CollinHeist/CropTop/docs/prototype/Raspberry Pi Code/stalk-pusher-master/README.md

```

Copyright (c) 2016-2017 [NYUAD Biomechanics Laboratory] - All Rights Reserved

No part of StalkPusher Project, including this file, may be copied, modified, 
propagated, or distributed unless given explicit permission.

Please contact Professor Cook at douglascook(at)nyu.edu for permission and 
further information.

```
# StalkPusher

A device that aids crop plant breeders to more accurately predict plant strength

## Introduction

IMAGE ALT TEXT (https://www.youtube.com/watch?v=vgz_xZ3Y4XQ "Corn Stalk Engineering")

Yield losses in maize (Zea mays L.) due to stalk lodging has significant negative economic impact. The lodging resistance in maize could be advanced more rapidly with the development of selective breeding tools that accurately predict stalk strength. Motivated by the strong correlation between flexural stiffness and stalk strength as demonstrated by Robertson et al, the StalkPusher device aims to predict crop stalk strength by measuring the plant's flexural rigidity.

## Installation/Setup

For installation and setup, please refer to [placeholder]

## Electronics Hardware

https://circuitmaker.com/Projects/Details/Ting-Che-Lin/stalkTesterForkWithDCDCConverter

## Graphical User Interface

## Physical Hardware

## Results

## Bibliography
Robertson, Daniel J., et al. "Maize Stalk Lodging: Flexural Stiffness Predicts Strength." Crop Science 56.4 (2016): 1711-1718.
