CollinHeist/CropTop/docs/prez/schematic poster.pptx

## cereal grain Data Acquisition device Designed by Ryan Donahue & Kennedy Caisley

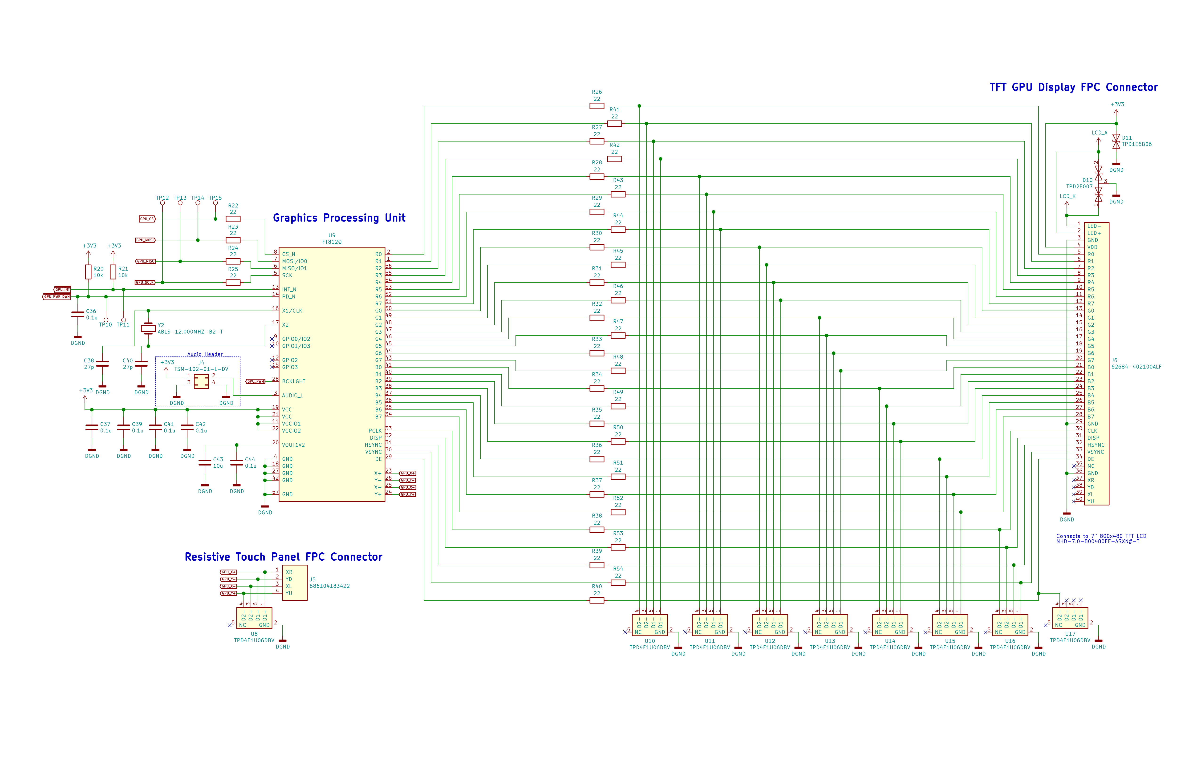
[picture p9: figure]
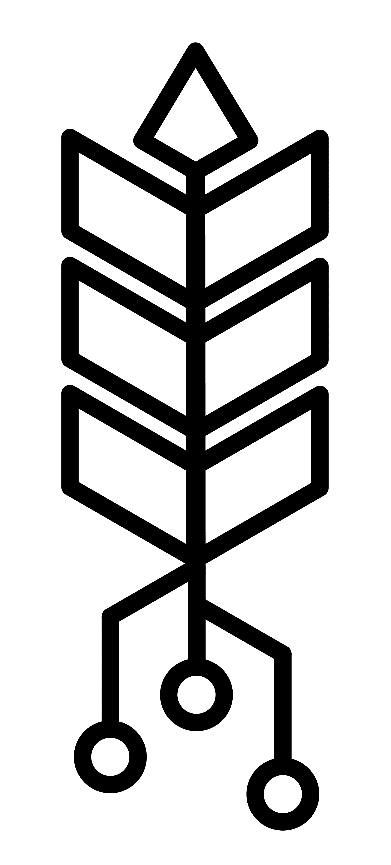
[picture p10: figure]
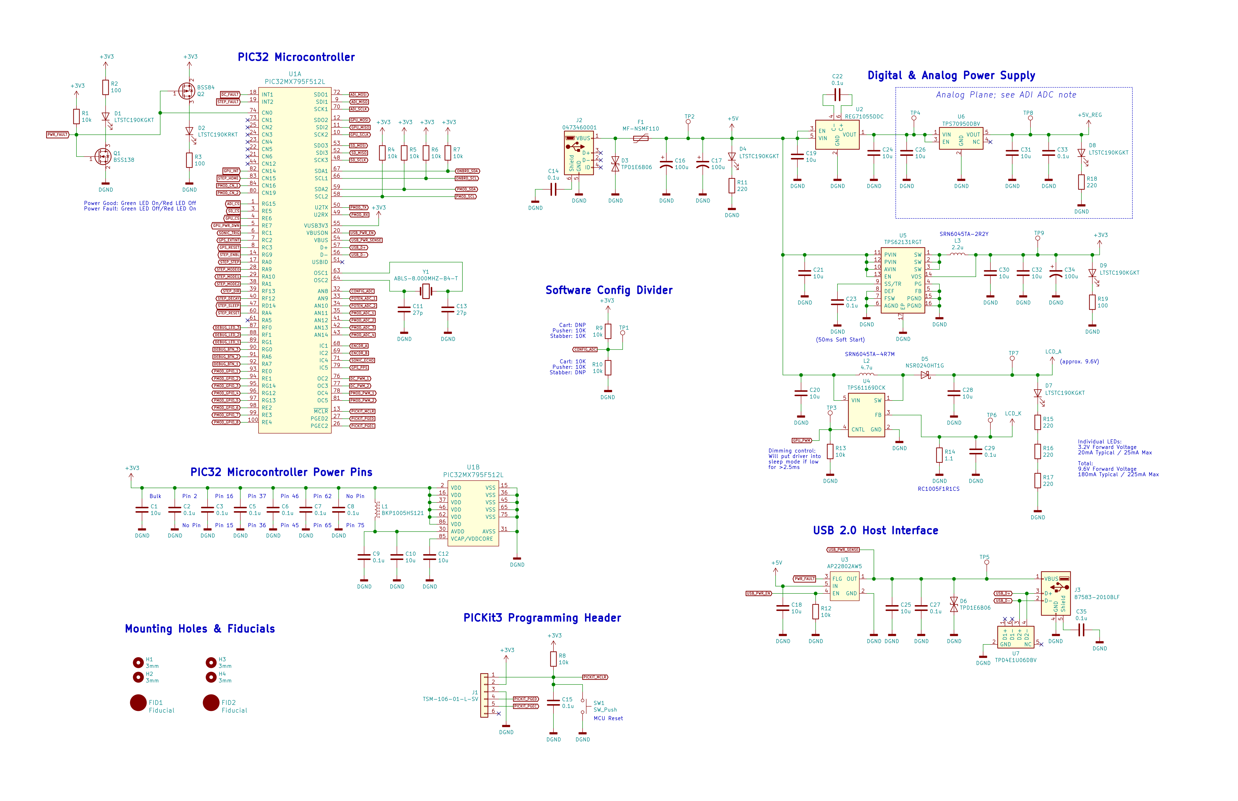
[picture p11: figure]
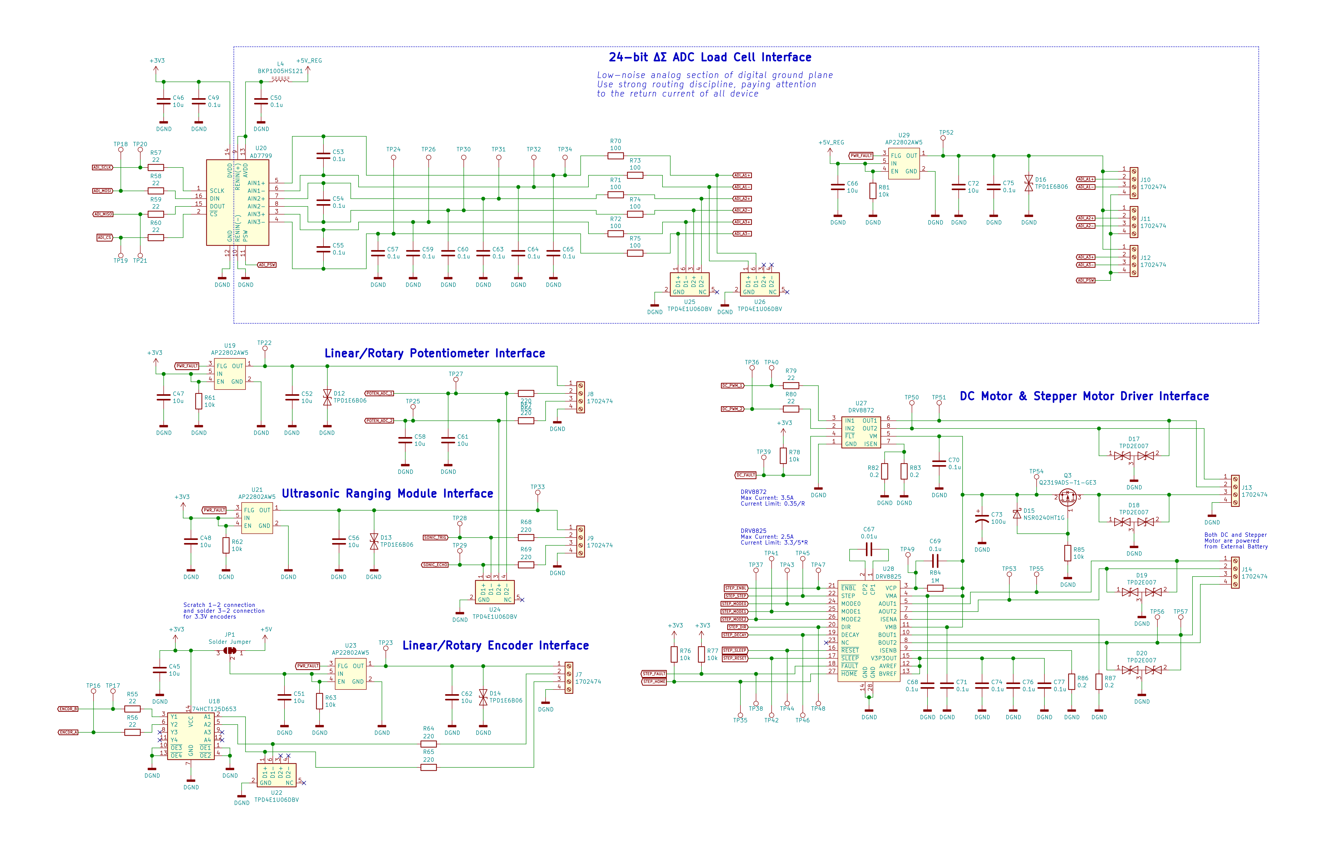
[picture p12: figure]
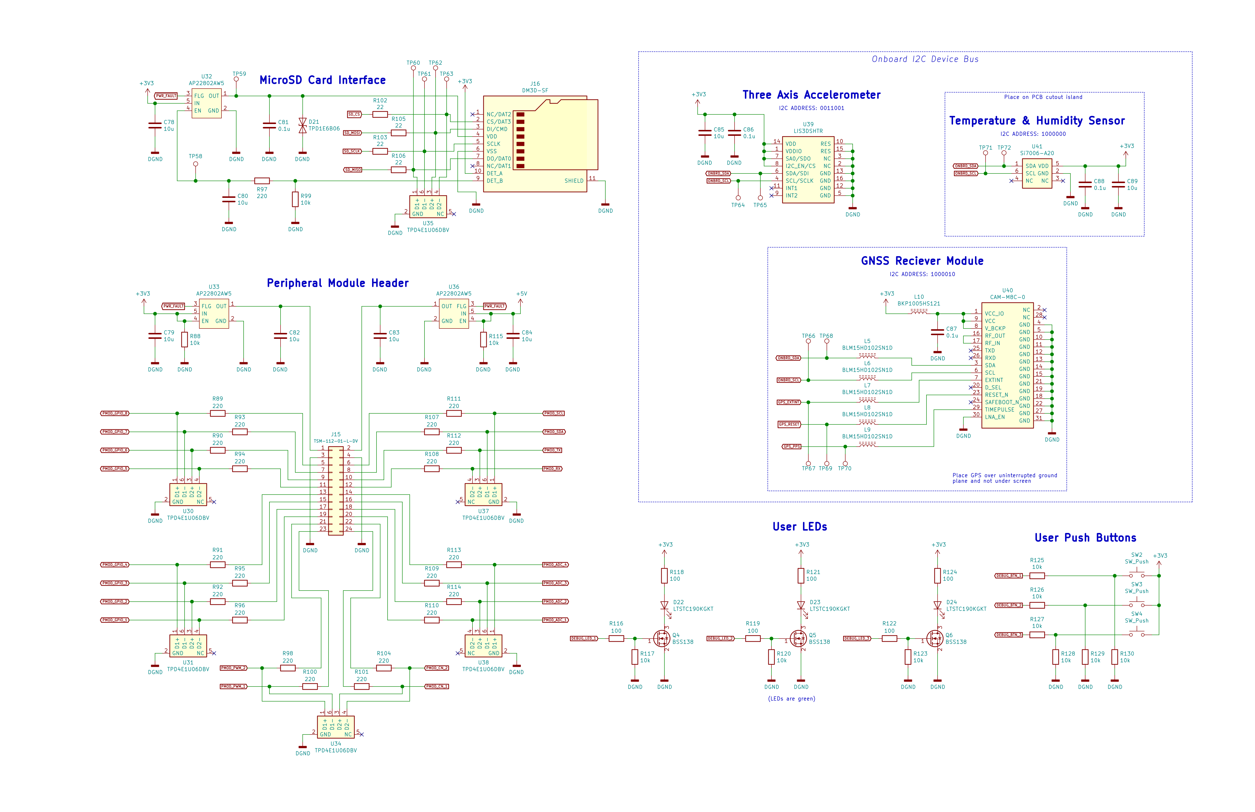
[picture p13: figure]
