CollinHeist/CropTop/pinout.xlsx

Sheet: Pin Function Selection
AERXERR/RG15 | GPIO |  |  |  |  | RG15 | GPIO
VDD | POWER
PMD5/RE5 | GPIO
PMD6/RE6 | GPIO
PMD7/RE7 | GPIO
T2CK/RC1 | GPIO
T3CK/AC2TX/RC2 | GPIO
T4CK/AC2RX/RC3 | GPIO
T5CK/SDI1/RC4 |  | SPI1
ECOL/SCK2/U6TX/U3RTS/PMA5/CN8/RG6 | I2C | SPI2 | UART | CN
ECRS/SDA4/SDI2/U3RX/PMA4/CN9/RG7 | I2C | SPI2 | UART | CN
ERXDV/AERXDV/ECRSDV/AECRSDV/SCL4/SDO2/U3TX/PMA3/CN10/RG8 |  | SPI2 |  | CN
MCLR | PROGRAM
ERXCLK/AERXCLK/EREFCLK/AEREFCLK/SS2/U6RX/U3CTS/PMA2/CN11/RG9 |  | SPI2 |  | CN
VSS | POWER
VDD | POWER
TMS/RA0 | GPIO
AERXD0/INT1/RE8 |  |  |  |  | INT
AERXD1/INT2/RE9 |  |  |  |  | INT
AN5/C1IN+/VBUSON/CN7/RB5 | USB | ADC |  | CN
AN4/C1IN-/CN6/RB4 |  | ADC |  | CN
AN3/C2IN+/CN5/RB3 |  | ADC |  | CN
AN2/C2IN-/CN4/RB2 |  | ADC |  | CN
PGEC1/AN1/CN3/RB1 | PROGRAM | ADC |  | CN
PGED1/AN0/CN2/RB0 | PROGRAM | ADC |  | CN
PGEC2/AN6/OCFA/RB6 | PROGRAM | ADC |  |  | OC FAULT
PGED2/AN7/RB7 | PROGRAM | ADC
VREF-/CVREF-/AERXD2/PMA7/RA9 | GPIO
VREF+/CVREF+/AERXD3/PMA6/RA10 | GPIO
AVDD | POWER
AVSS | POWER
AN8/C1OUT/RB8 |  | ADC
AN9/C2OUT/RB9 |  | ADC
AN10/CVREFOUT/PMA13/RB10 |  | ADC
AN11/ERXERR/AETXERR/PMA12/RB11 |  | ADC
VSS | POWER
VDD | POWER
TCK/RA1 | GPIO
AC1TX/SCK4/U5TX/U2RTS/RF13 |  | SPI4 | UART
AC1RX/SS4/U5RX/U2CTS/RF12 |  | SPI4 | UART
AN12/ERXD0/AECRS/PMA11/RB12 |  | ADC
AN13/ERXD1/AECOL/PMA10/RB13 |  | ADC
AN14/ERXD2/AETXD3/PMALH/PMA1/RB14 |  | ADC
AN15/ERXD3/AETXD2/OCFB/PMALL/PMA0/CN12/RB15 |  | ADC |  | CN | OC FAULT
VSS | POWER
VDD | POWER
AETXD0/SS3/U4RX/U1CTS/CN20/RD14 |  | SPI3 | UART | CN
AETXD1/SCK3/U4TX/U1RTS/CN21/RD15 |  | SPI3 | UART | CN
SDA5/SDI4/U2RX/PMA9/CN17/RF4 | I2C | SPI4 | UART | CN
SCL5/SDO4/U2TX/PMA8/CN18/RF5 | I2C | SPI4 | UART | CN
USBID/RF3 | USB
SDA3/SDI3/U1RX/RF2 | I2C | SPI3 | UART
SCL3/SDO3/U1TX/RF8 | I2C | SPI3 | UART | e
VBUS | USB
VUSB3V3 | USB
D-/RG3 | USB
D+/RG2 | USB
SCL2/RA2 | I2C
SDA2/RA3 | I2C
TDI/RA4 | GPIO
TDO/RA5 | GPIO
VDD | POWER
OSC1/CLKI/RC12 | OSCILLATOR
OSC2/CLKO/RC15 | OSCILLATOR
VSS | POWER
AETXCLK/SCL1/INT3/RA14 | I2C |  |  |  | INT
AETXEN/SDA1/INT4/RA15 | I2C |  |  |  | INT
RTCC/EMDIO/AEMDIO/IC1/RD8 | GPIO |  |  | IC
SS1/IC2/RD9 |  | SPI1 |  | IC
SCK1/IC3/PMCS2/PMA15/RD10 |  | SPI1 |  | IC
EMDC/AEMDC/IC4/PMCS1/PMA14/RD11 |  |  |  | IC
SDO1/OC1/INT0/RD0 |  | SPI1 |  |  | OC | INT
SOSCI/CN1/RC13 |  |  | CN
SOSCO/T1CK/CN0/RC14 |  |  | CN
VSS | POWER
OC2/RD1 |  |  |  |  | OC
OC3/RD2 |  |  |  |  | OC
OC4/RD3 |  |  |  |  | OC
ETXD2/IC5/PMD12/RD12 |  |  |  | IC
ETXD3/PMD13/CN19/RD13 |  |  | CN
OC5/PMWR/CN13/RD4 |  |  | CN |  | OC
PMRD/CN14/RD5 |  |  | CN
ETXEN/PMD14/CN15/RD6 |  |  | CN
ETXCLK/PMD15/CN16/RD7 |  |  | CN
VCAP/VDDCORE | POWER
VDD | POWER
C1RX/ETXD1/PMD11/RF0 | GPIO
C1TX/ETXD0/PMD10/RF1 | GPIO
C2TX/ETXERR/PMD9/RG1 | GPIO
C2RX/PMD8/RG0 | GPIO
TRCLK/RA6 | GPIO
TRD3/RA7 | GPIO
PMD0/RE0 | GPIO
PMD1/RE1 | GPIO
TRD2/RG14 | GPIO
TRD1/RG12 | GPIO
TRD0/RG13 | GPIO
PMD2/RE2 | GPIO
PMD3/RE3 | GPIO
PMD4/RE4 | GPIO

Sheet: Totals
GPIO | 28
SPI | 3
UART | 2
INT | 2 | PKT_PGED |  | DC_PWM_1 |  | ADI_MOSI | GPU_MOSI | SDCARD_MOSI |  | ONBRD_SCL
CN | 12 | PKT_PGEC |  | DC_PWM_2 |  | ADI_MISO | GPU_MISO | SDCARD_MISO |  | ONBRD_SDA
ADC | 8 | PKT_MCLR |  |  |  | ADI_SCLK | GPU_SCLK | SDCARD_SCLK
USB | 1
I2C | 2
IC | 3
OC | 4
 |  | INT | 2 | CN | 12 | GPIO | 28 | ADC | 8 | IC | 3
 |  | ~STEPPER_FAULT |  | ~USB_PWR_GOOD |  | LED_1 |  | CONFIG_ADC |  | ENCDR_A |  | PMOD_TX
 |  | ~DC_FAULT |  | ~ADI_PWR_GOOD |  | LED_2 |  | POTEN_ADC_1 |  | ENCDR_B |  | PMOD_RX
 |  |  |  | ~SDCARD_PWR_GOOD |  | LED_3 |  | POTEN_ADC_2 |  | SONIC_ECHO
 |  |  |  | ~POTEN_PWR_GOOD |  | BTN_1 |  |  |  | GPS_PPS
 |  |  |  | ~SONIC_PWR_GOOD |  | BTN_2 |  | PMOD_ADC_1
 |  |  |  | ~ENCDR_PWR_GOOD |  | BTN_3 |  | PMOD_ADC_2
 |  |  |  | ~PMOD_3V3_PWR_GOOD |  |  |  | PMOD_ADC_3
 |  |  |  | ~PMOD_5V0_PWR_GOOD |  |  |  | PMOD_ADC_4
 |  |  |  |  |  | ~GPU_PD
 |  |  |  | ~STEPPER_HOME |  | ~GPU_INT
 |  |  |  | ACCEL_INT_1
 |  |  |  | ACCEL_INT_2 |  | SONIC_TRIG
 |  |  |  |  |  | ~GPU_CS
 |  |  |  |  |  | ~SDCARD_CS
 |  |  |  |  |  | ~ADI_CS
 |  |  |  |  |  | ~STEPPER_ENBL
 |  |  |  |  |  | STEPPER_STEP
 |  |  |  |  |  | STEPPER_MODE_0
 |  |  |  |  |  | STEPPER_MODE_1
 |  |  |  |  |  | STEPPER_MODE_2
 |  |  |  |  |  | STEPPER_DIR
 |  |  |  |  |  | STEPPER_DECAY
 |  |  |  |  |  | ~STEPPER_SLEEP
 |  |  |  |  |  | ~STEPPER_RESET
 |  |  |  |  |  | GPS_RST
 |  |  |  |  |  | GPS_EXTINT

Sheet: Tasks to Accomplish
Add Piezo Buzzer | Testpoints
Finish FT812Q Connection | Netnames
Work on PIC32 Pinout | Labels
Finish Stepper Motor Chip | Calculations
 | Check testpoint are on labeled nets
