CollinHeist/CropTop/docs/images/idaho.jpg

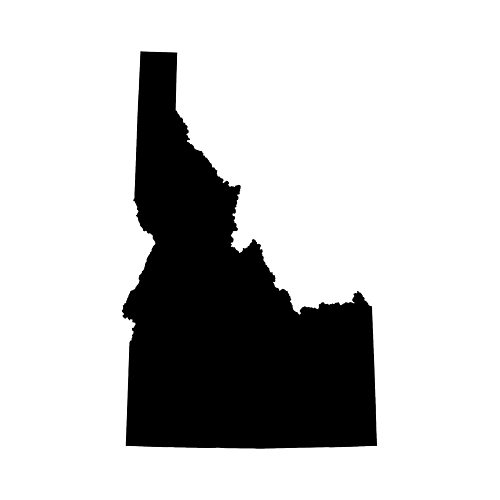
docs/images/idaho.jpg
