CollinHeist/CropTop/docs/prototype/Raspberry Pi Code/stalk-pusher-master/hardware/docs/buildOfMaterials/BOM_PartType-stalkTesterForkWithDCDCConverter.xls

CiivaID | Comment | Description | Designator | Footprint | LibRef | Quantity
 | 1k Ohms | Res Carbon Film 1K Ohm 5% 1/4W -400ppm/°C to 0ppm/°C Conformal AXL Thru-Hole T/R | R5 | PCB-bfjjg625tt0lscyu35rt-1 | CMP-db3e1311f37e04f9-1 | 1.0
 | 150 Ohm | Through Hole Thin Film Resistor, LR Series, 150 ohm, 600 mW, - 1%, 350 V, Axial Leaded | R7 | PCB-vx15ok3iiu352umrckug-1 | CMP-aa5a626003c1759d-1 | 1.0
 | 150 Ohms | Through Hole Thin Film Resistor, LR Series, 150 ohm, 600 mW, - 1%, 350 V, Axial Leaded | R1, R3 | PCB-vx15ok3iiu352umrckug-1 | CMP-aa5a626003c1759d-1 | 2.0
 | 220uF | Aluminium Electrolytic Capacitor, WCAP-ATG8 Series, 220 F, 20%, 25 V, 6.3 mm, Radial Leaded | C1 | PCB-kyskzfzvu5hkft7entwf-1 | CMP-eaa62094da6d3561-1 | 1.0
2034380 | 240 Ohm | RES 0.0 OHM 1/4W JUMP AXIAL | R6 | PCB-2034380-1 | CMP-2034380-1 | 1.0
 | 270 Ohm | Res Metal Film 270 Ohm 1% 0.6W ?50ppm/C Conformal Coated AXL Ammo Pack | R8, R9 | PCB-3e396qau55ic585a88p4-1 | CMP-fd3b34c9d94622fc-2 | 2.0
 | 470 Ohm | Through Hole Metal Film Resistor, SFR16S Series, 470 kohm, 500 mW, - 5%, 200 V, Axial Leaded | R4 | PCB-ignmdqeaj071785ev1qy-1 | CMP-135bdb585537cc9c-1 | 1.0
 | 620 Ohm | RESISTOR, 0.25W 1% 620R; Series: MF25; Resistance: 620R; Tolerance, resistance: +/-1%; Power rating: 0.25W; Temperatu... | R2 | PCB-2034602-1 | CMP-08b0c1ebf079d777-1 | 1.0
 | 282834-2 | Conn; Term Blk; PCB; Wire Receptacle; 3; 2.54mm; 30-16AWG; Green; 10A; 150V; M1.6 | Pot | PCB-3ptdhsghoqvd1l0ur6gj-1 | CMP-2bf4e0a55a8ff433-1 | 1.0
 | 282834-2 | Conn; Term Blk; PCB; Wire Receptacle; 4; 2.54mm; 30-16AWG; Green; 10A; 150V; M1.6 | AM2315 | PCB-pck2b3tw6vugzxi4asp2-1 | CMP-e39628c790073c51-1 | 1.0
 | Adafruit Industries 746 | Adafruit Ultimate GPS Breakout | GPS | PCB-bz3yr8570f4b4qxddo1b-1 | CMP-5d1695eb4fdc82d1-6 | 1.0
 | Adafruit Industries 1085 | ADS-1115 Programmable Gain Amplifier | ADC1, ADC2 | PCB-4lejntxigf7lhwnms15s-1 | CMP-311cf9d8a243eedb-16 | 2.0
 | Adafruit Industries 2021 | Adafruit 9-DOF Accel/Mag/Gyro+Temp Breakout Board | LSM9DS0 | PCB-maed6y3qleiqj331msl7-1 | CMP-d3cc19ecca900c0b-5 | 1.0
 | Arduino PRO shield | Arduino Pro Mini Atmega328 (3.3V /5V) | Arduino Pro Mini 5V | PCB-xjupnshw5z1zqg394mrs-1 | CMP-14badecfe295cb7d-20 | 1.0
 | CMP-4964073-3 | Standard Recovery Rectifier, 2-Pin Axial_Lead, Pb-Free, Tape and Reel | D1, D2 | ONSC-AXIAL_LEAD-2-59-10_P | CMP-4964073-3 | 2.0
 | CUI PDS1-S5-S12-S | PDS1 Series 1 W 12 VDC 83 mA Single Output DC-DC Isolated Converter | DCDC Conv | PCB-vjduovkroff0l3ptlkf4-1 | CMP-2838e08a97fff7ff-2 | 1.0
 | INA114AP | Precision Instrumentation Amplifier, -40 to 85 degC, 8-pin DIP (P8), Green (RoHS & no Sb/Br) | (1)INA114, (2)INA114 | TI-P8 | CMP-13608889-2 | 2.0
 | Inductor | High Frequency Split Core Ferrite Suppressors for Round Cable 835ohms 100MHz 5A Thru-hole | L2 | PCB-mg0q4fr7srabzfbwe7jf-1 | CMP-92d25afd71424d15-2 | 1.0
 | LM317T | 1.5A, 1.2V to 37V Adjustable Voltage Regulator, 3-Pin TO-220 | LReg 5V, LReg 7V | TO-220 | CMP-1170851-2 | 2.0
 | Raspberry Pi RASPBERRYPI3-MODB-1GB. | Raspberry Pi 3 Model B, 64bit, 1GB RAM, Wi-Fi 802.11n BT 4.1 | Raspberry Pi 3 | PiHAT template | Raspberry Pi RASPBERRYPI3-MODB-1GB.-4 | 1.0
 | SparkFun BOB-12009 | Logic Level Converter - Bi-Direc | Lvl Shifter | PCB-snpsjs3ljinaye23s7fj-1 | CMP-a9a86355bbb8766f-7 | 1.0
 | TDK FG28X5R1E475KRT06 | CAP CER 4.7UF 25V X5R RADIAL | C2, C3 | PCB-t6r2jniesmrfxoqfoh3w-1 | CMP-c1ff0cfb06121e38-1 | 2.0
 | TE Connectivity 282834-5 | Buchanan; Conn; Term Blk; PCB; 5; 2.54mm; Front; 30-16 AWG; Green; 10 A; 150 V | LCell X/Single, LCell Y | PCB-pck2b3tw6vugzxi4asp2-1 | CMP-216fea3e502afea8-2 | 2.0
 | TE Connectivity / AMP 282834-8 | Buchanan; Conn; Term Blk; PCB; 8; 2.54mm; Front; 30-16 AWG; Green; 10 A; 150 V | D Pad, LBut | PCB-31ifldq471oc3mn4sxz4-1 | CMP-2b39e0501fb7f4fe-6 | 2.0
 | UA741CP | General-Purpose Operational Amplifier, 7 to 36 V, 0 to 70 degC, 8-pin DIP (P8), Pb-Free (RoHS) | UA741 | TI-P8 | CMP-1320630-2 | 1.0
 | Vishay BCcomponents K104Z15Y5VF5TL2 | Capacitor; Ceramic; Cap 0.1 uF; Tol -20, +80%; Vol-Rtg 50 VDC; Radial; Y5V; Tape & Reel | C4, C5, C6, C7, C8, C9, C10, C11 | PCB-l4zci1ynknckpo24ombh-1 | CMP-7d20b42952c2a2e7-2 | 8.0
