CollinHeist/CropTop/PCB v3.0/step/ABS07.STEP

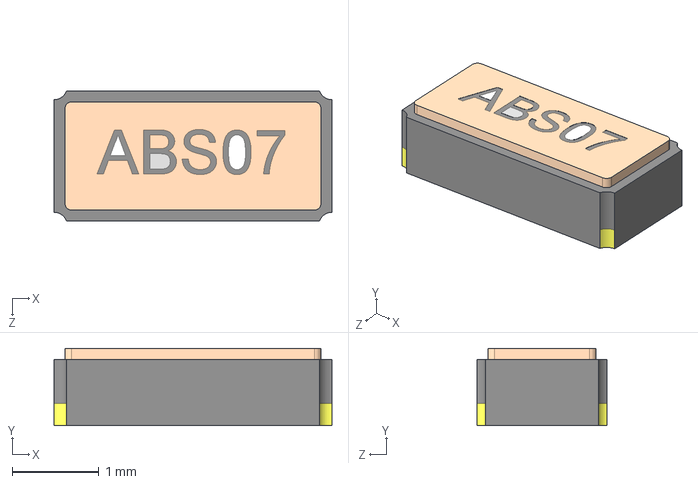
[picture p15: CAD file, 2019-05-08]
PCB v3.0/step/ABS07.STEP
3.20 x 0.889 x 1.50 mm
