CollinHeist/CropTop/PCB v3.0/step/USB_Micro-B_Molex_47346-0001.step

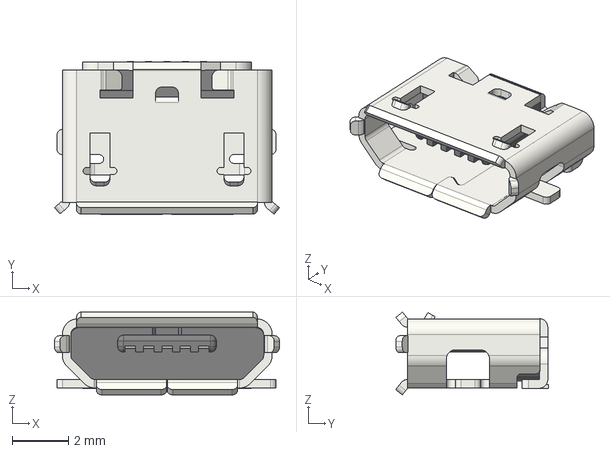
[picture p16: CAD file, 2019-04-25]
PCB v3.0/step/USB_Micro-B_Molex_47346-0001.step
7.98 x 5.42 x 2.94 mm
