CollinHeist/CropTop/PCB v3.0/step/usb a.step

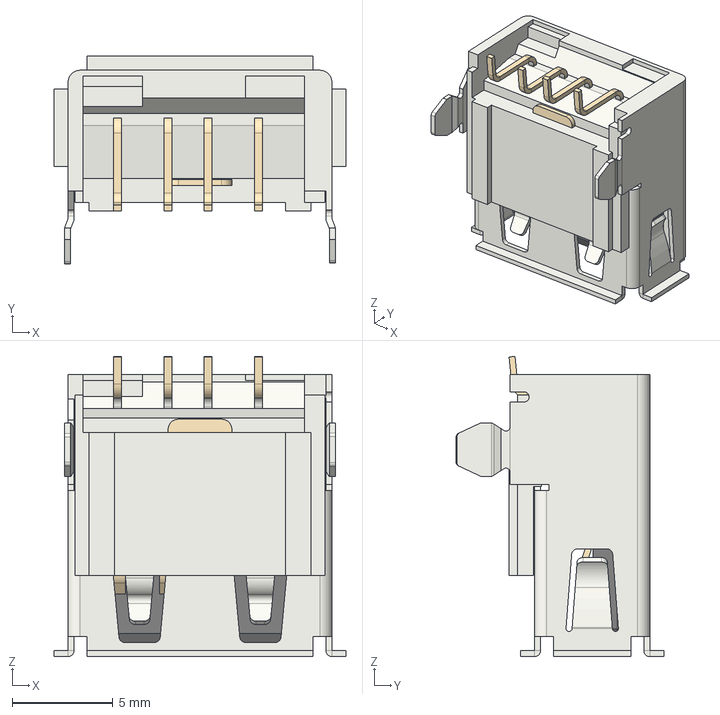
[picture p17: CAD file, 2019-04-25]
PCB v3.0/step/usb a.step
14.5 x 10.3 x 14.9 mm
