CollinHeist/CropTop/PCB v3.0/step/LGA-16.stp

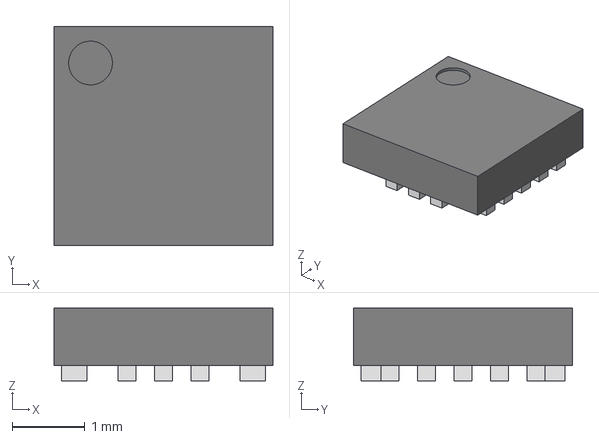
[picture p18: CAD file, 2019-04-22]
PCB v3.0/step/LGA-16.stp
3.00 x 3.00 x 1.00 mm
