CollinHeist/CropTop/PCB v3.0/step/soic-14.stp

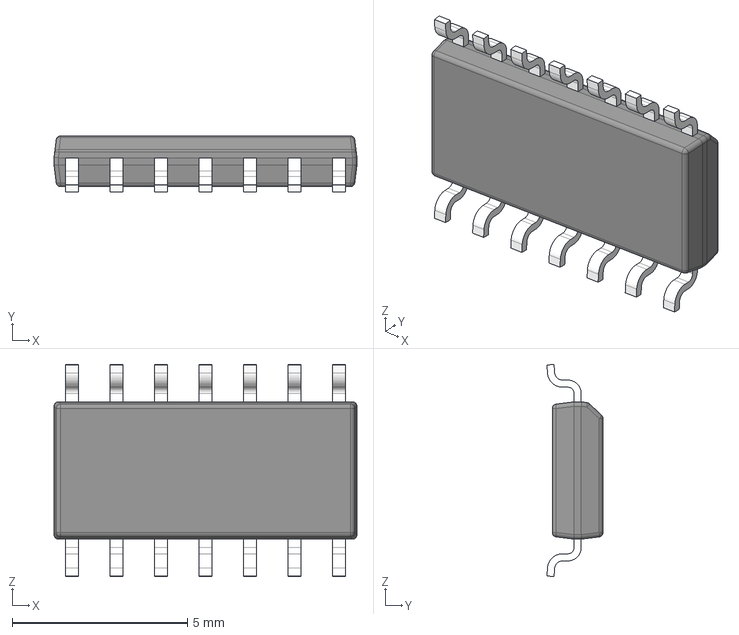
[picture p19: CAD file, 2019-04-22]
PCB v3.0/step/soic-14.stp
8.64 x 1.60 x 6.05 mm
BODY_M14A_20
LEAD_M14A_46 x 14
