CollinHeist/CropTop/PCB v3.0/step/DM3CS-SF.stp

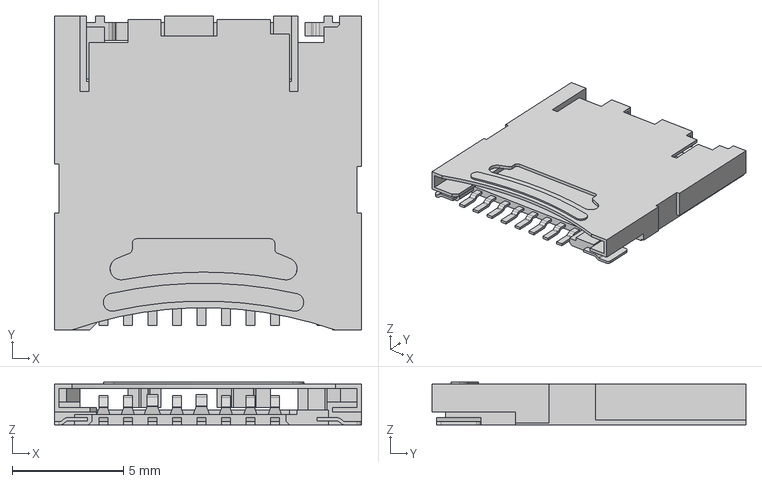
[picture p20: CAD file, 2019-04-22]
PCB v3.0/step/DM3CS-SF.stp
13.8 x 14.1 x 1.93 mm
