CollinHeist/CropTop/PCB v3.0/step/mf-nsmf110.stp

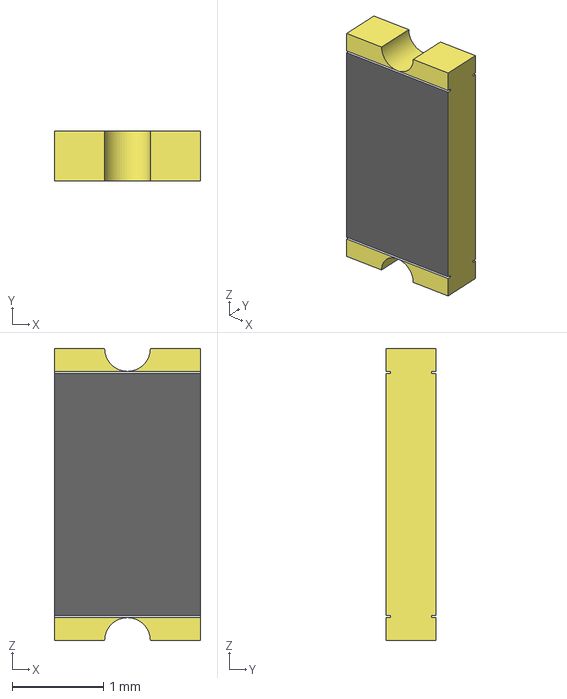
[picture p21: CAD file, 2019-04-22]
PCB v3.0/step/mf-nsmf110.stp
1.60 x 0.55 x 3.20 mm
