CollinHeist/CropTop/PCB v3.0/step/4fpc.FCStd

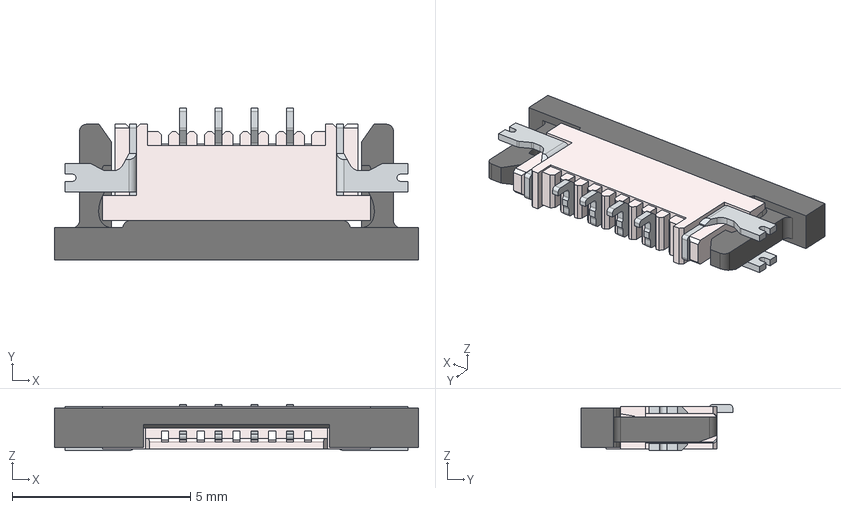
[picture p22: CAD file, 2019-04-22]
PCB v3.0/step/4fpc.FCStd
10.2 x 4.25 x 1.29 mm
68x109183x22
68x109183x22_Actuator
68X1xx183x22_Solder_Pad2
68X1XX183X22_Solder_Pad
68X1XX183X22_Pin_TOP
68X1XX183X22_Pin_TOP001
68X1XX183X22_Pin_TOP002
68X1XX183X22_Pin_TOP003
