CollinHeist/CropTop/PCB v3.0/step/40fpc.FCStd

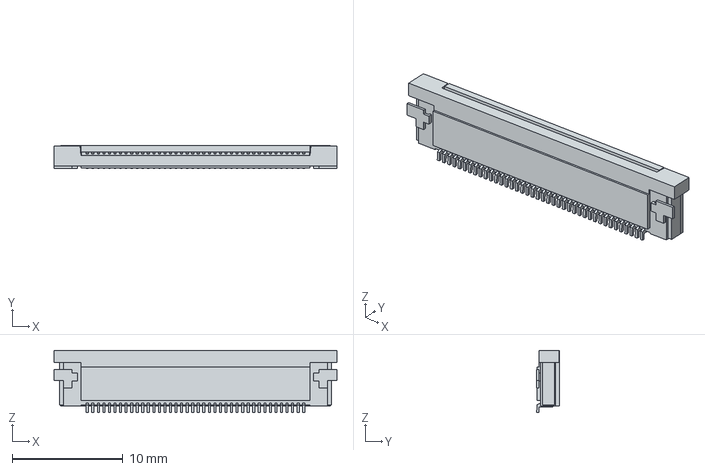
[picture p23: CAD file, 2019-04-22]
PCB v3.0/step/40fpc.FCStd
25.5 x 2.05 x 5.60 mm
