CollinHeist/CropTop/PCB v3.0/step/DM3AT-SF-PEJM5.stp

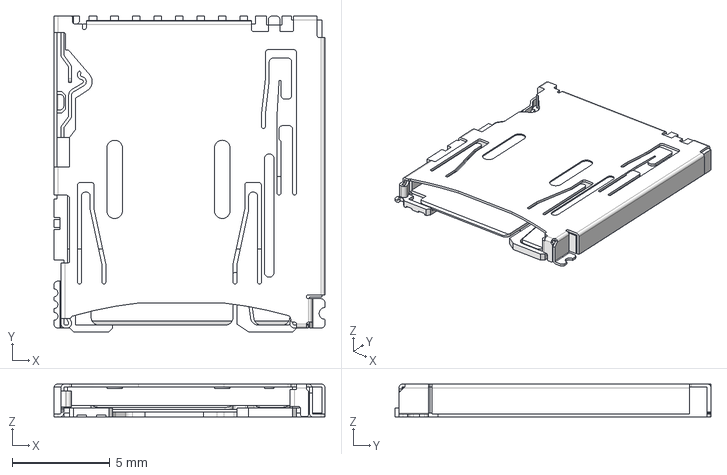
[picture p24: CAD file, 2019-04-22]
PCB v3.0/step/DM3AT-SF-PEJM5.stp
13.8 x 16.2 x 1.68 mm
