CollinHeist/CropTop/PCB v3.0/step/CAM-M8.STEP

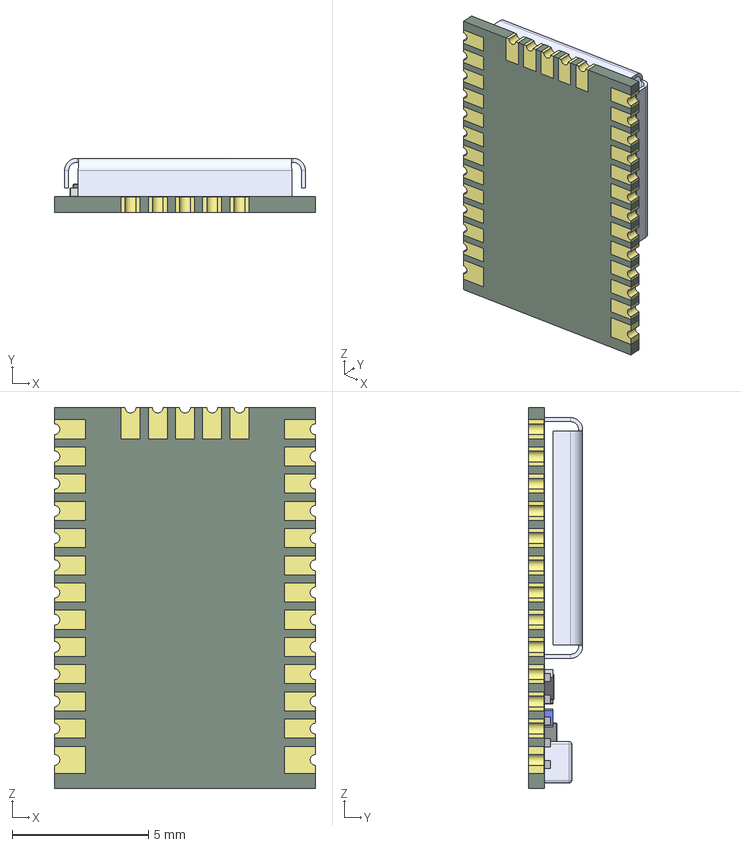
[picture p25: CAD file, 2019-04-22]
PCB v3.0/step/CAM-M8.STEP
9.60 x 2.00 x 14.0 mm
CAM-M8_PCB
CAM-M8_Pad_big001 x 2
CAM-M8_Pad_small028 x 29
CAM-M8_Shield
Capsule004 x 5
Encapsulation009 x 10
Cap0201_top004 x 5
Encapsulation_008 x 8
CAP_PART002 x 3
IC01
IC02
ChipAntenna
IND_PART
