CollinHeist/CropTop/PCB v3.0/step/TSM-102-01-T-DV.stp

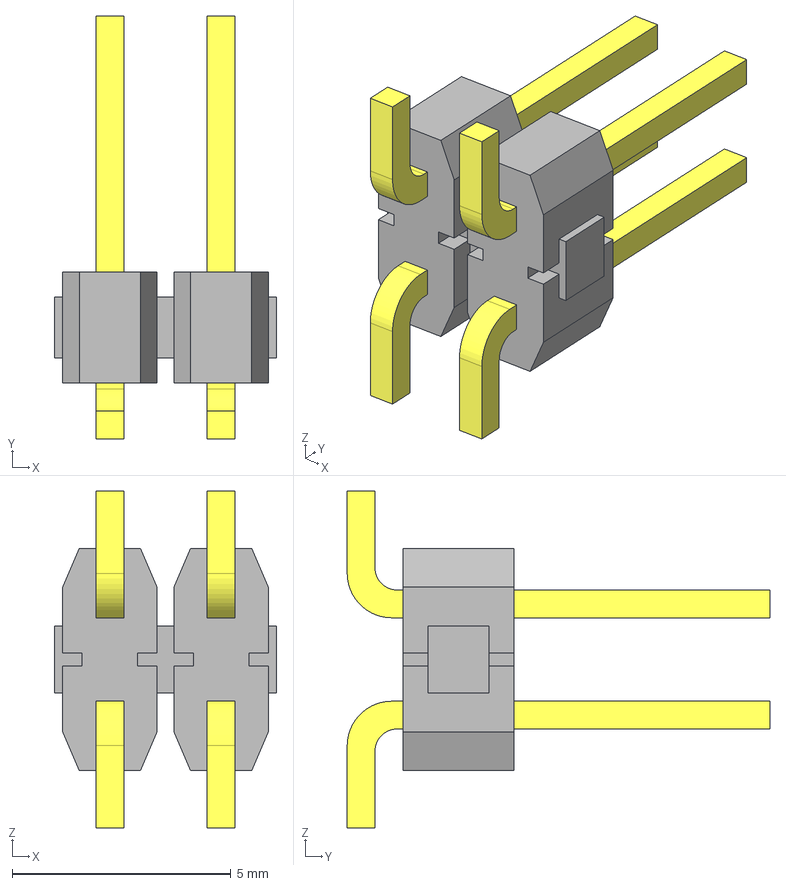
[picture p26: CAD file, 2019-04-22]
PCB v3.0/step/TSM-102-01-T-DV.stp
5.08 x 9.65 x 7.70 mm
_TSM-102-01-DV_body
_T-1S6-16(-01-2-DV)
