CollinHeist/CropTop/PCB v3.0/step/srn8040.stp

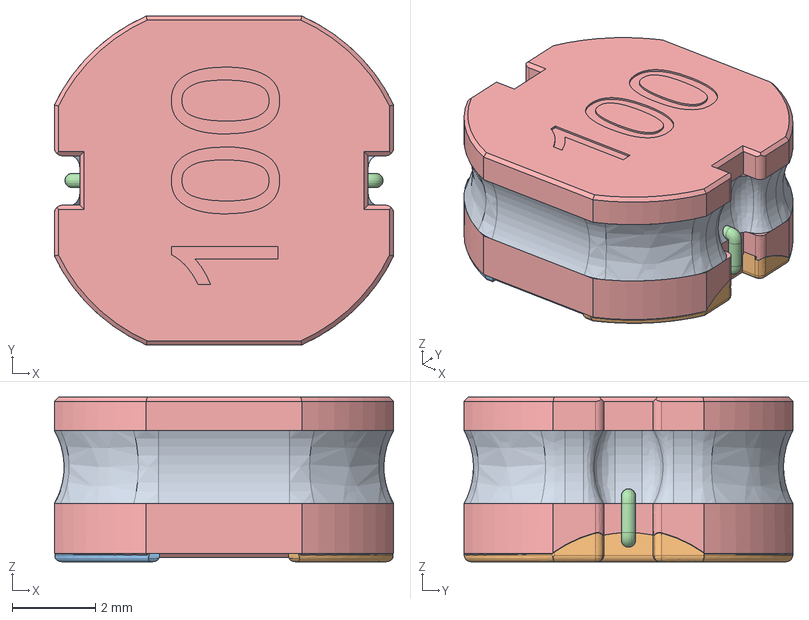
[picture p27: CAD file, 2019-04-22]
PCB v3.0/step/srn8040.stp
8.15 x 7.90 x 3.95 mm
