CollinHeist/CropTop/PCB v3.0/step/TSM-106-01-T-SV.stp

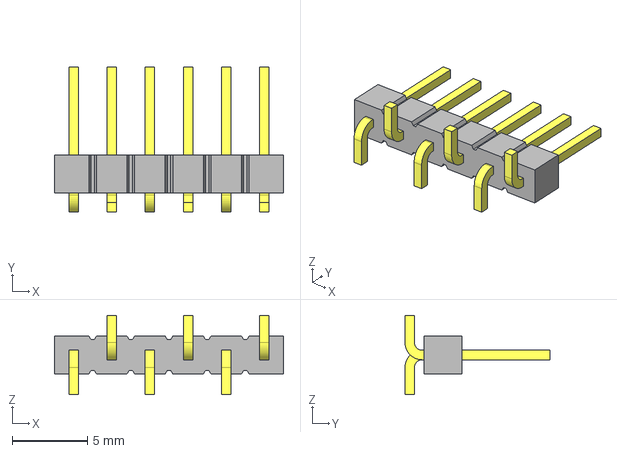
[picture p28: CAD file, 2019-04-22]
PCB v3.0/step/TSM-106-01-T-SV.stp
15.2 x 9.65 x 5.28 mm
_TSM-106-01-SV_body
_T-1S6-16(-01-6-SV)
