CollinHeist/CropTop/PCB v3.0/step/usb no.stp

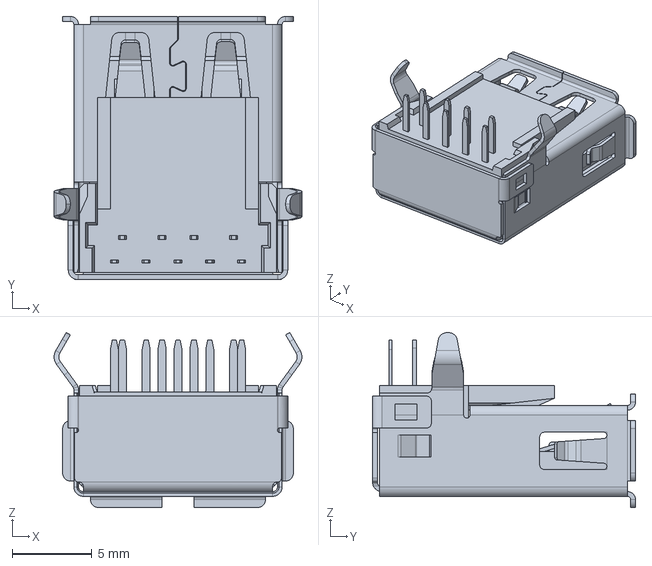
[picture p29: CAD file, 2019-03-17]
PCB v3.0/step/usb no.stp
15.6 x 16.5 x 11.0 mm
