CollinHeist/CropTop/PCB v3.0/step/c-4-1734839-0-c-3d.stp

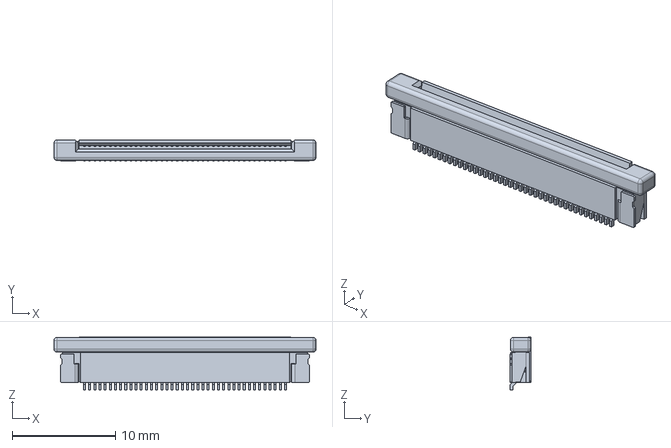
[picture p30: CAD file, 2019-03-17]
PCB v3.0/step/c-4-1734839-0-c-3d.stp
25.4 x 2.05 x 5.11 mm
