CollinHeist/CropTop/PCB v3.0/step/usb2.stp

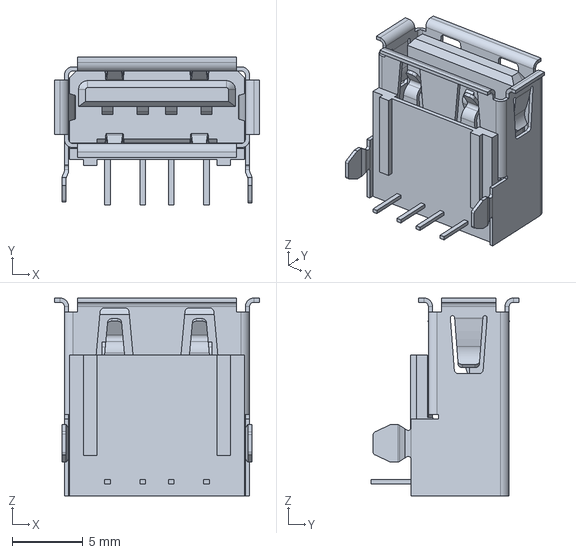
[picture p31: CAD file, 2019-03-17]
PCB v3.0/step/usb2.stp
14.5 x 10.5 x 14.0 mm
