CollinHeist/CropTop/PCB v3.0/step/Download_STP_614004190021 (rev1).stp

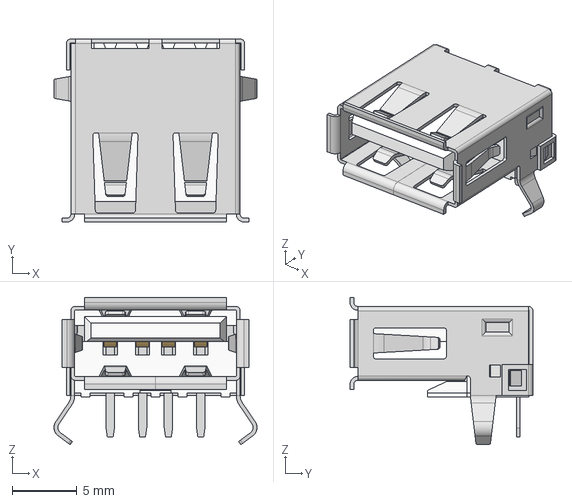
[picture p32: CAD file, 2019-03-17]
PCB v3.0/step/Download_STP_614004190021 (rev1).stp
15.7 x 14.1 x 11.4 mm
614004190021_Shielding
