CollinHeist/CropTop/PCB v3.0/step/ABLS.STEP

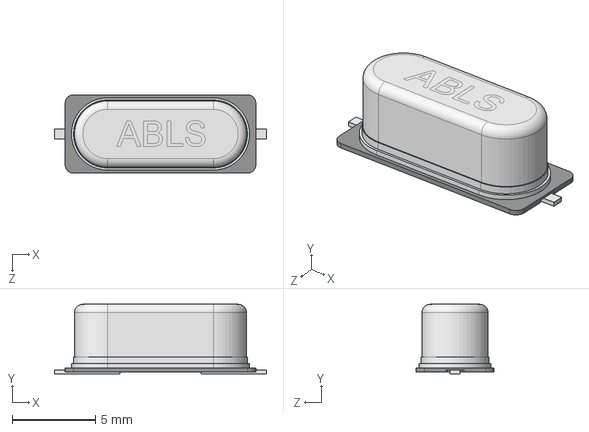
[picture p33: CAD file, 2019-03-17]
PCB v3.0/step/ABLS.STEP
12.7 x 4.17 x 4.70 mm
