CollinHeist/CropTop/PCB v3.0/step/Download_STP_61300611121 (rev1).stp

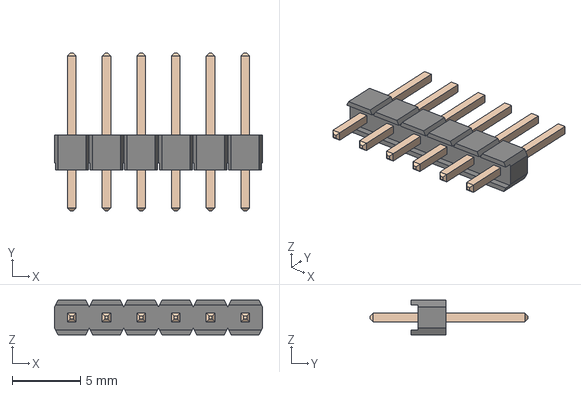
[picture p34: CAD file, 2019-03-17]
PCB v3.0/step/Download_STP_61300611121 (rev1).stp
15.2 x 11.5 x 2.54 mm
6130xx11121_PIN x 6
