CollinHeist/CropTop/PCB v3.0/step/Downlaod_STP_61300411121 (rev1).stp

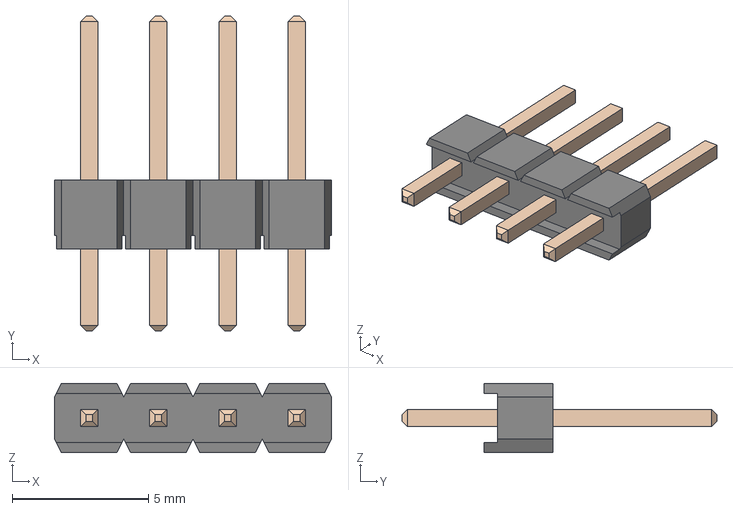
[picture p35: CAD file, 2019-03-17]
PCB v3.0/step/Downlaod_STP_61300411121 (rev1).stp
10.2 x 11.5 x 2.54 mm
6130xx11121_PIN x 4
