CollinHeist/CropTop/(list of files, cad)

Other CAD files:
PCB v3.0/step/gps step.FCStd
PCB v3.0/step/bourns_ptc_fuse.FCStd
PCB v2.0/step/1040310811.stp
PCB v2.0/step/1702474.stp
PCB v2.0/step/393570015.stp
PCB v2.0/step/686104183422.stp
PCB v2.0/step/87583-2010blfc.stp
PCB v2.0/step/bourns_ptc_fuse.FCStd
PCB v2.0/step/gps step.FCStd
PCB v2.0/step/s62684-402100alf.stp
PCB v2.0/step/usb a.FCStd
PCB v3.0/step/1040310811.stp
PCB v3.0/step/1702474.stp
PCB v3.0/step/393570015.stp
PCB v3.0/step/686104183422.stp
PCB v3.0/step/87583-2010blfc.stp
PCB v3.0/step/s62684-402100alf.stp
PCB v3.0/step/usb a.FCStd
