CollinHeist/CropTop/docs/prototype/Raspberry Pi Code/stalk-pusher-master/hardware/schematics/Schematics.PDF

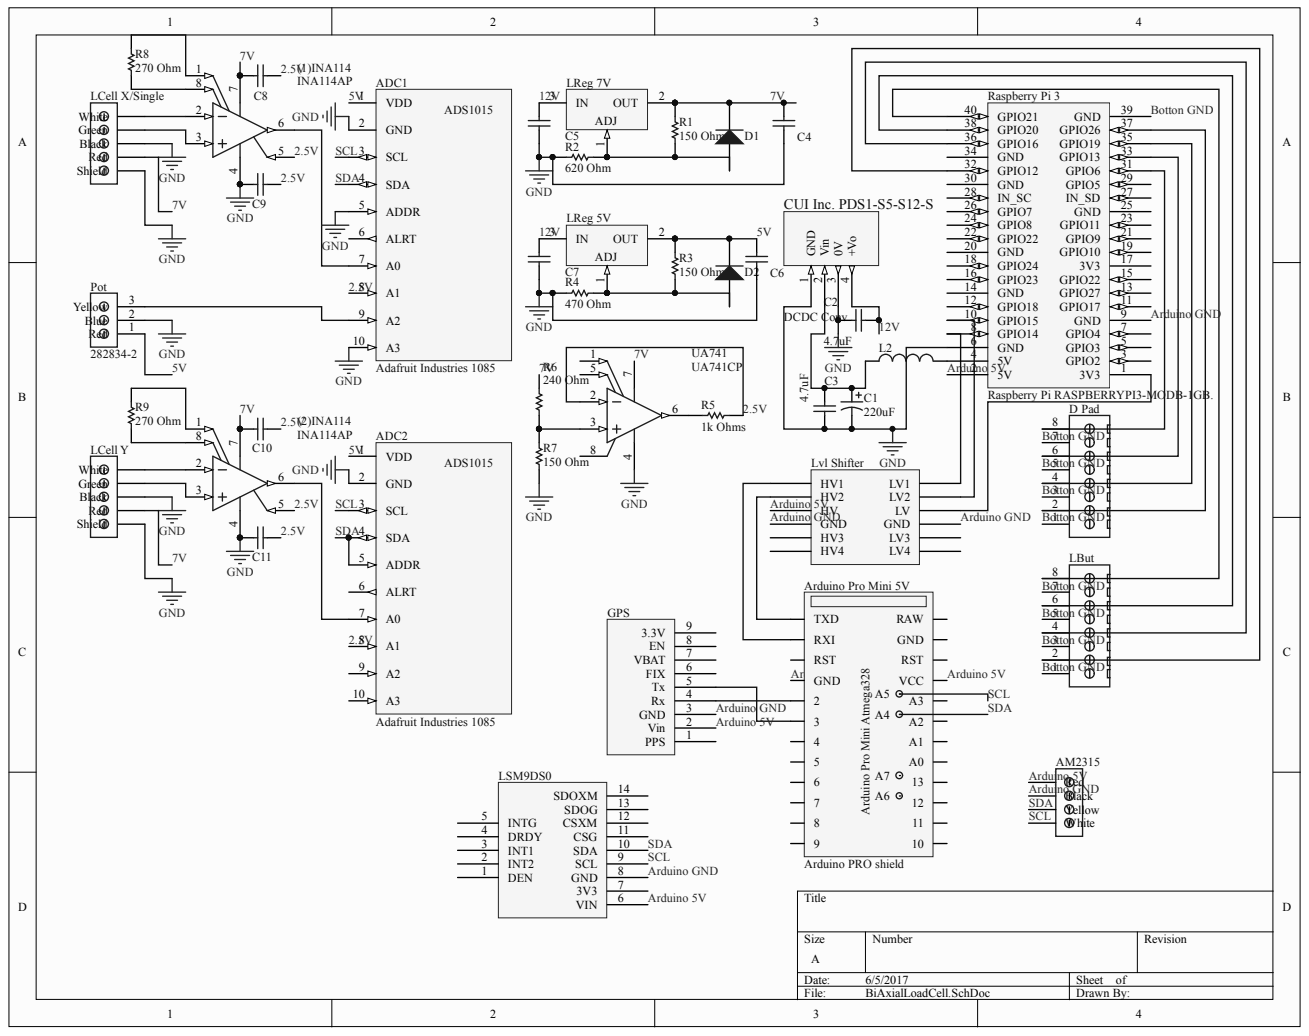
[picture p36: page 1]

Arduino 5V

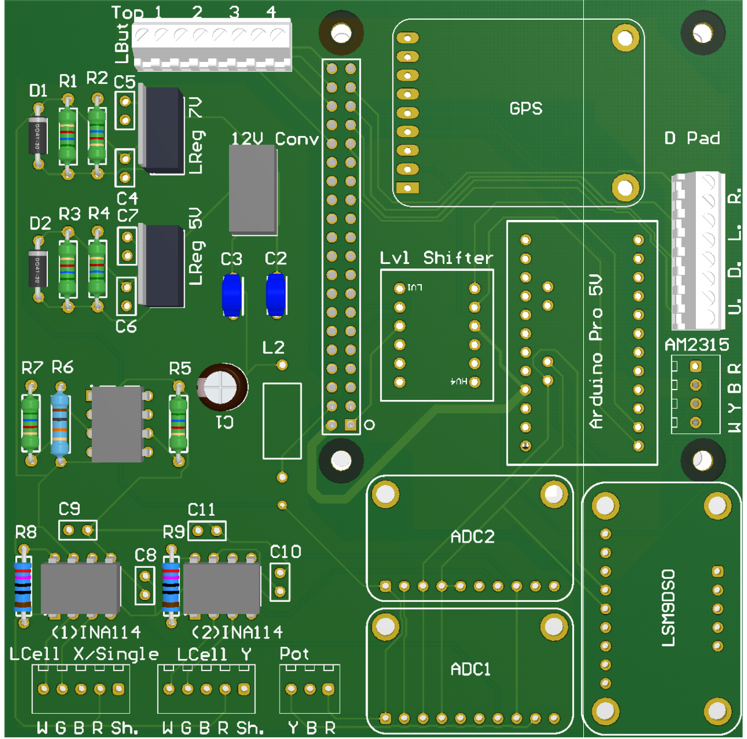
[picture p37: page 2]

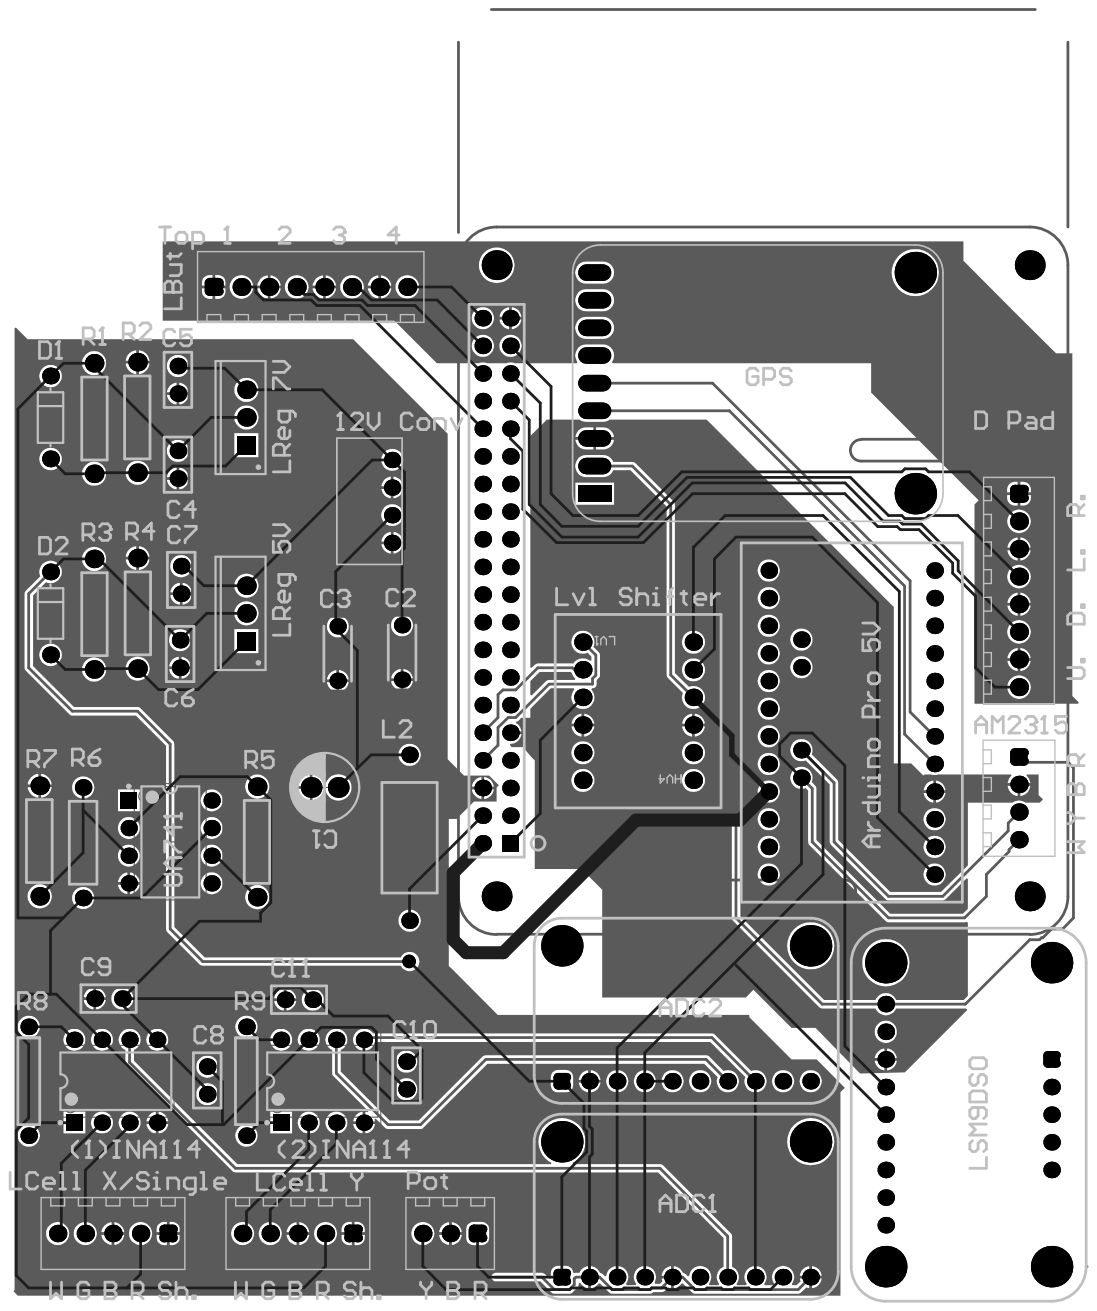
[picture p38: page 3]

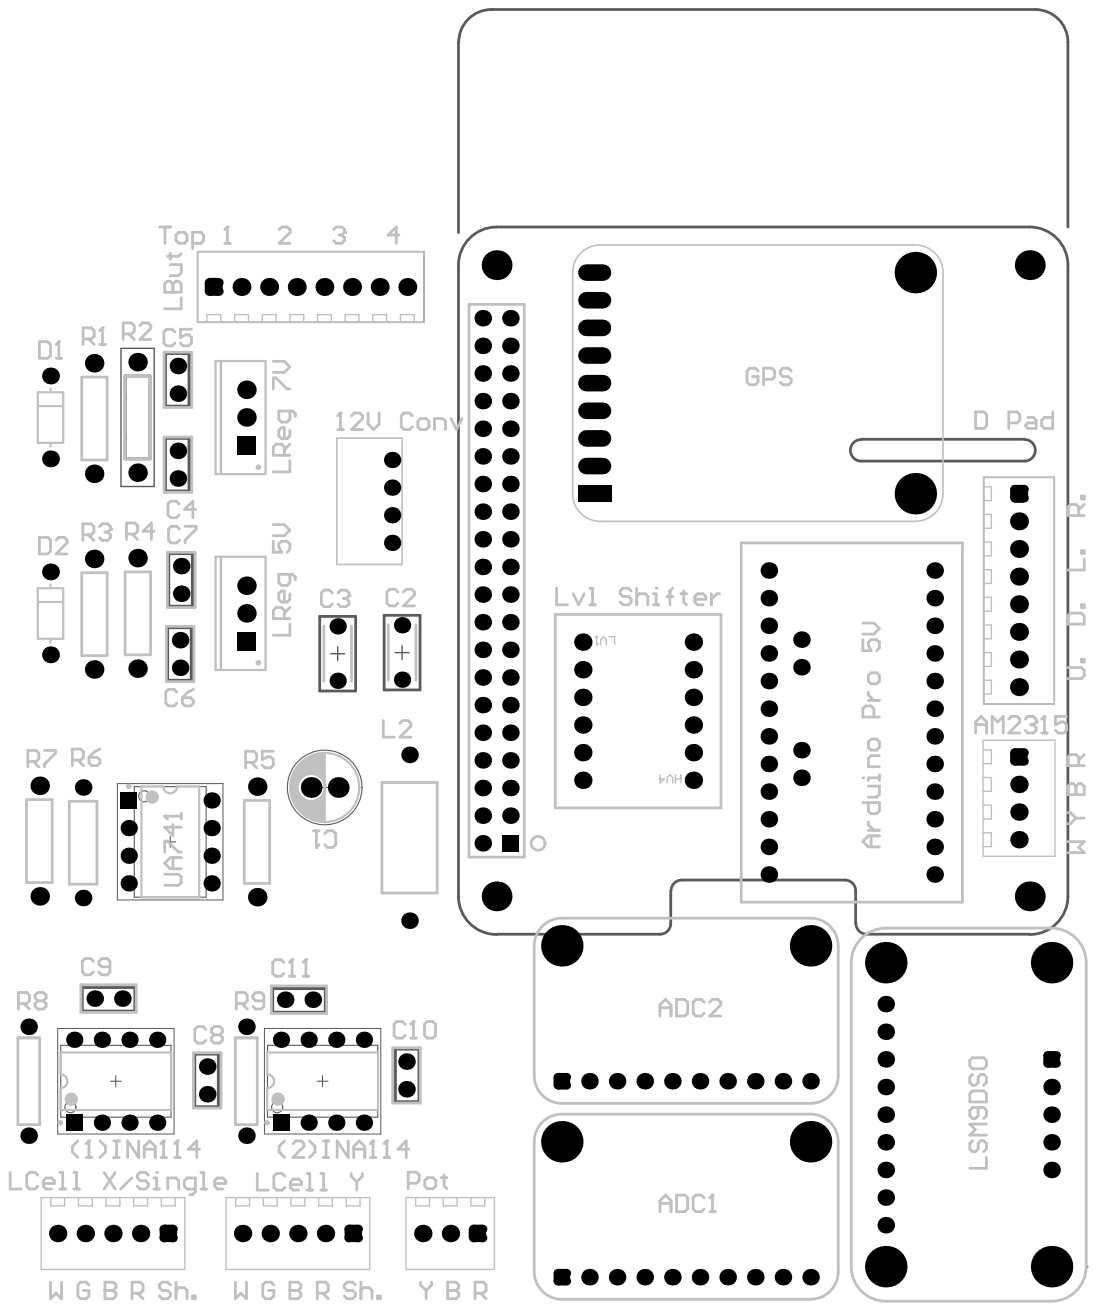
[picture p39: page 4]
