CollinHeist/CropTop/docs/7.0_Nextion_Dimension.pdf

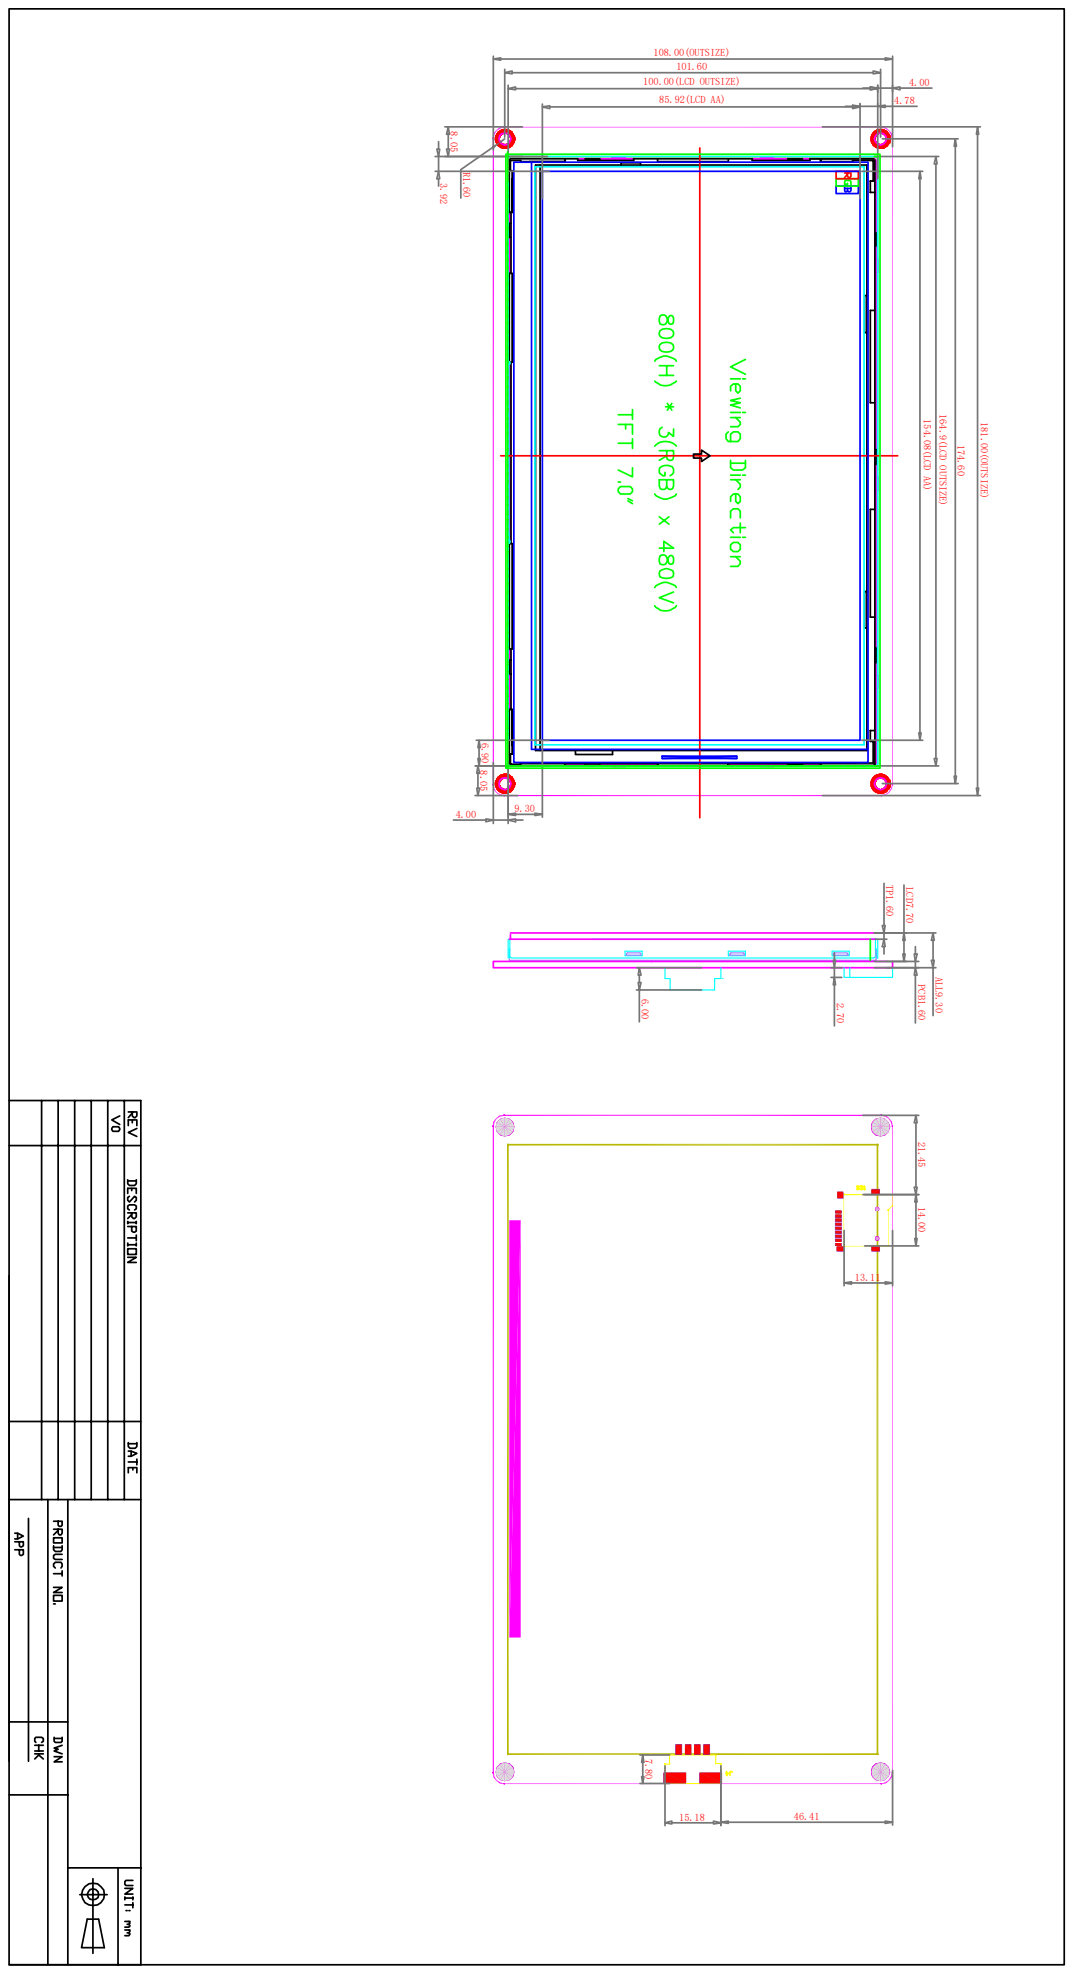
[picture p40: page 1]
154.08(LCD AA); 164.9(LCD OUTSIZE); 181.00(OUTSIZE); 85.92(LCD AA); 100.00(LCD OUTSIZE); 108.00(OUTSIZE); LCD7.70; PCB1.60 14.00 21.45; ALL9.30
