CollinHeist/CropTop/PCB v3.0/croptop.kicad_pcb

## KiCad design PCB v3.0/croptop.kicad_pcb (2020-05-27)

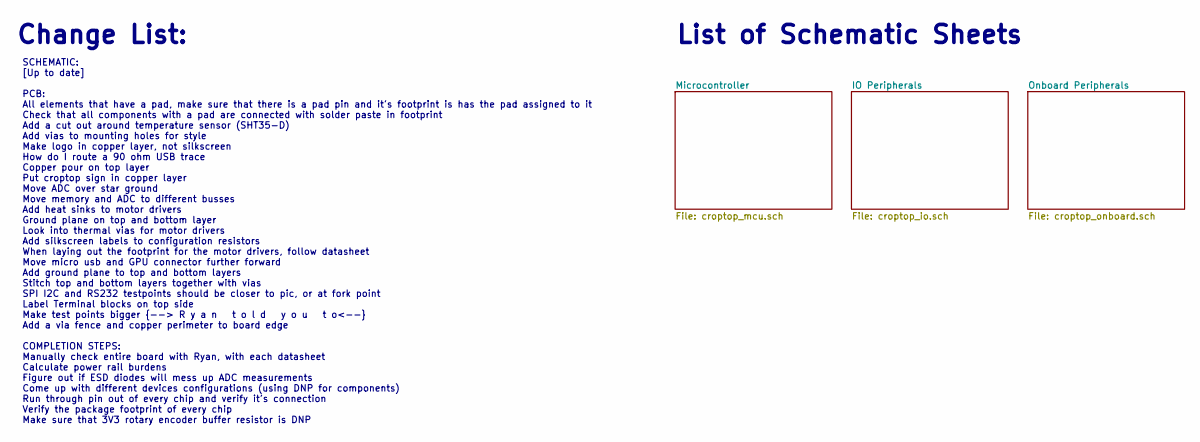
[picture p49: schematic croptop.sch, CropTop 2.2]

Notes on the sheet:
List of Schematic Sheets
SCHEMATIC: [Up to date] PCB: All elements that have a pad, make sure that there is a pad pin and it's footprint is has the pad assigned to it Check that all components with a pad are connected with solder paste in footprint Add a cut out around temperature sensor (SHT35-D) Add vias to mounting hole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
Change List:

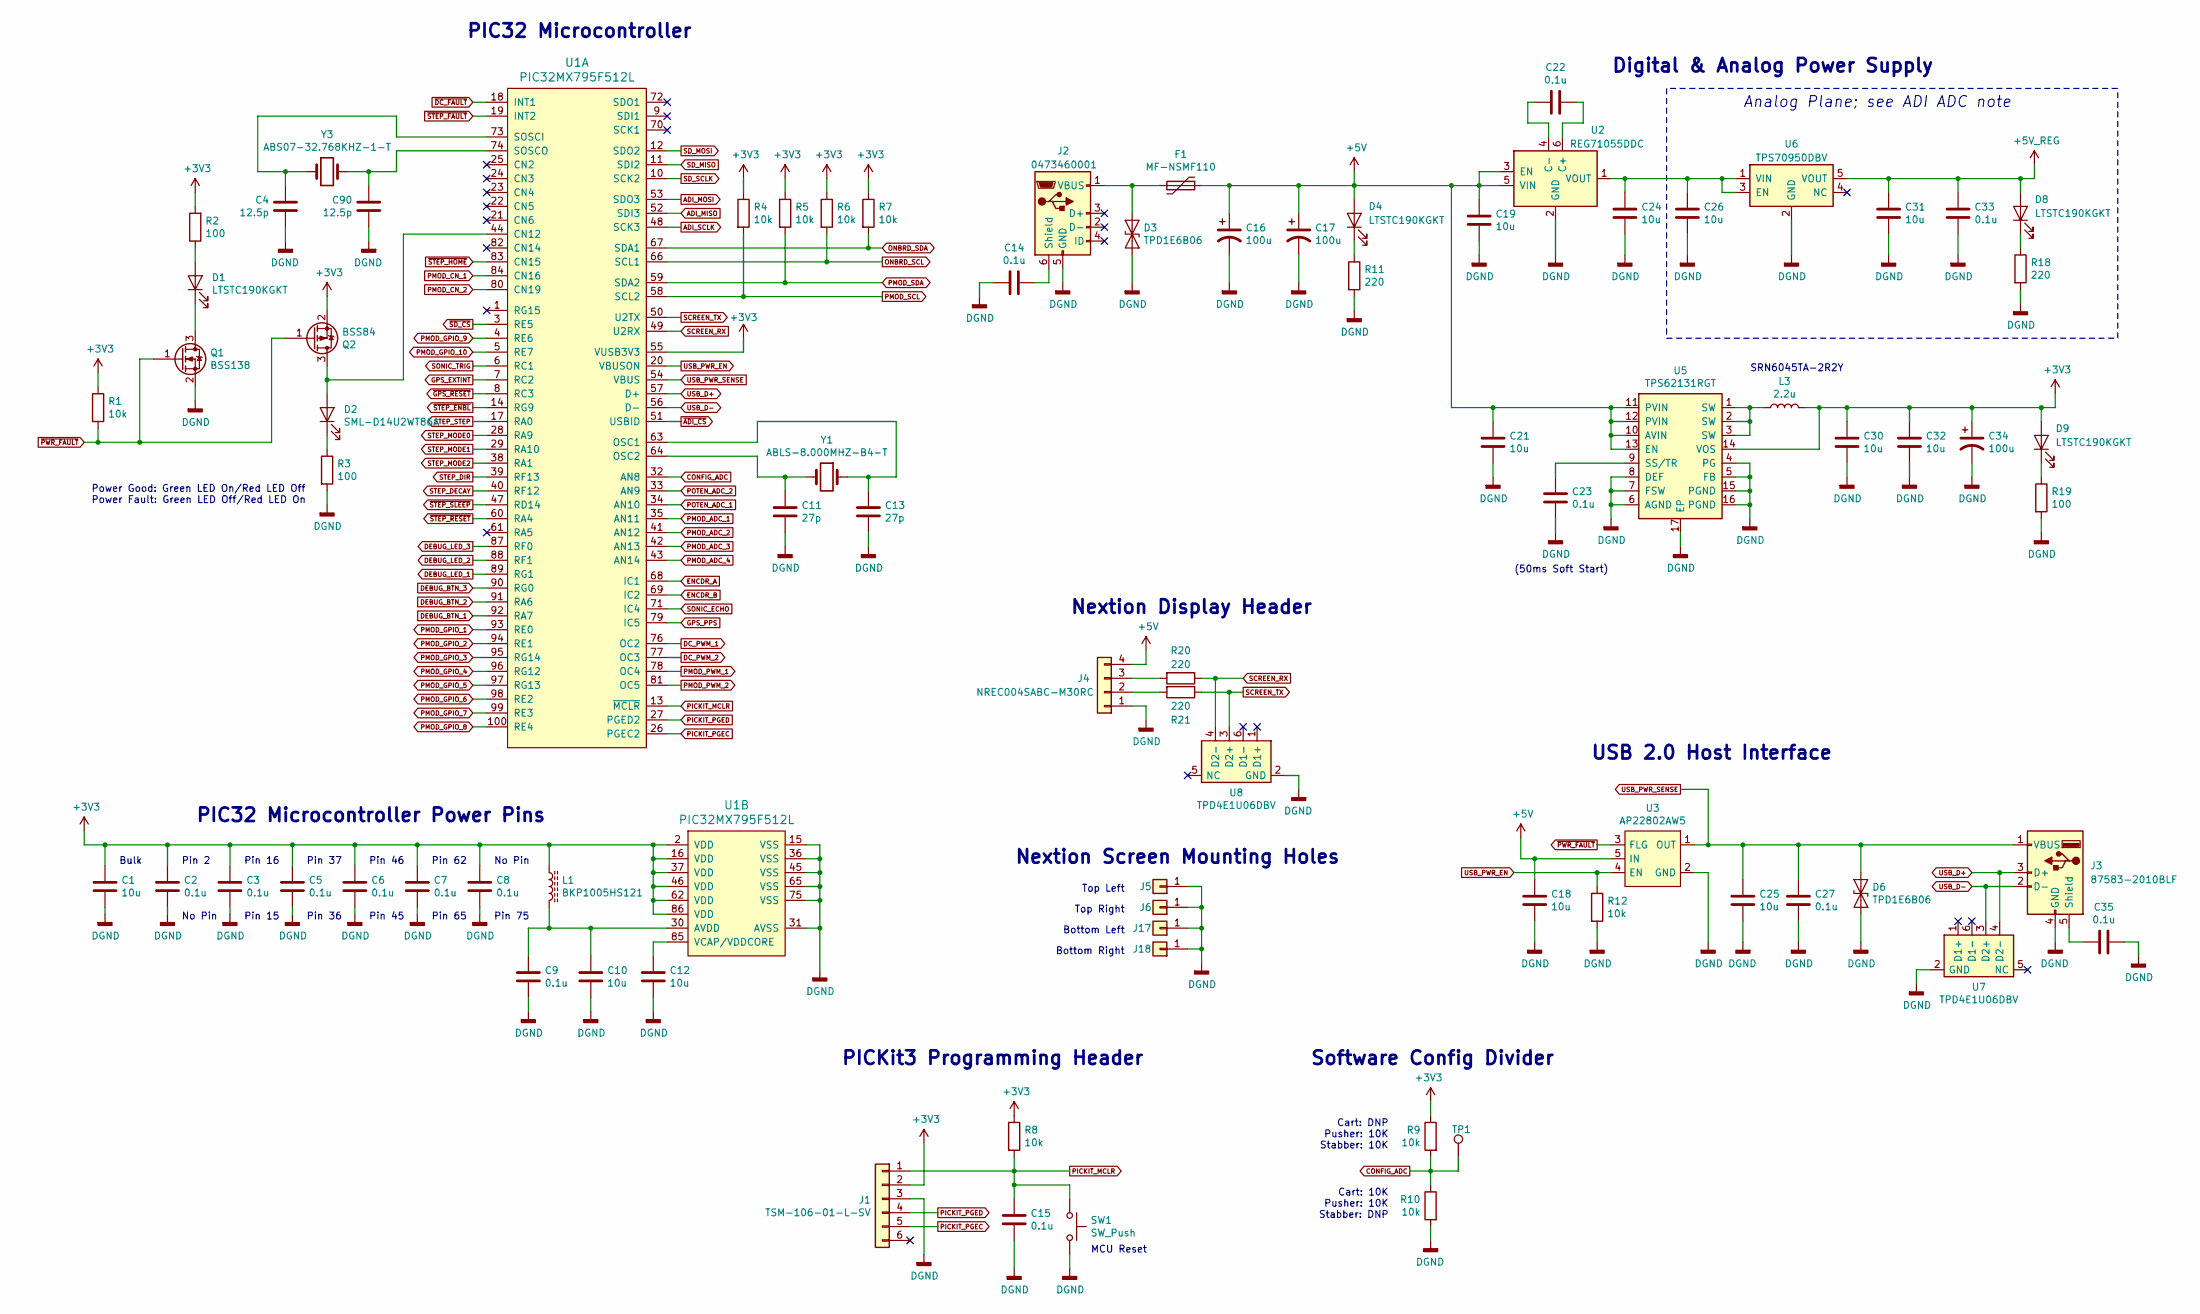
[picture p50: schematic croptop_mcu.sch, CropTop 2.2]

Parts:
C1, C10, C12, C18, C19, C21, C24, C25, C26, C31, C32: 10u; C_1206_3216Metric; MPN CC1206ZRY5V6BB106
C2, C3, C5, C6, C7, C8, C9, C14, C15, C22, C23, C27, C33, C35: 0.1u; C_0402_1005Metric; MPN CL05F104ZO5NNNC
C4, C90: 12.5p; C_0402_1005Metric; MPN CC0402JRNPO9BN120
C11, C13: 27p; C_0402_1005Metric; MPN C0402C270K5GACTU
C16, C17, C34: 100u; CP_Elec_6.3x7.7; MPN EEE-HC1C101XP
C30: 10u; C_1206_3216Metric; Rating 16V; MPN CC1206ZKY5V7BB106
D1, D4, D8, D9: LTSTC190KGKT; LED_0603_1608Metric; MPN LTST-C190KGKT
D2: SML-D14U2WT86A; LED_0603_1608Metric; MPN SML-D14U2WT86A
D3, D6: TPD1E6B06; D_0201_0603Metric; MPN TPD1E6B06DPLR
F1: MF-NSMF110; Fuse_1206_3216Metric; MPN MF-NSMF110-2
J1: TSM-106-01-L-SV; PinHeader_1x06_P2.54mm_Vertical_SMD_Pin1Right; MPN TSM-106-01-L-SV
J2: 0473460001; USB_Micro-B_Molex_47346-0001; MPN 0473460001
J3: 87583-2010BLF; MPN 87583-2010BLF
J4: NREC004SABC-M30RC; PinHeader_1x04_P2.54mm_Vertical_SMD_Pin1Right; MPN NREC004SABC-M30RC
J5, J6, J17, J18: Conn_01x01; MountingHole_3.2mm_M3_Pad_Via
L1: BKP1005HS121; L_0402_1005Metric; MPN BKP1005HS121-TV
L3: 2.2u; L_Bourns_SRN6045TA; MPN SRN6045TA-2R2Y
Q1: BSS138; SOT-23; MPN BSS138-TP
Q2: BSS84; SOT-23; MPN BSS84
R1, R4, R5, R6, R7, R8, R9, R10, R12: 10k; R_0402_1005Metric; MPN RC0402FR-0710KL
R2, R3, R19: 100; R_0402_1005Metric; MPN RC0402FR-07100RL
R11, R18, R20, R21: 220; R_0402_1005Metric; MPN CRGCQ0402F220R
SW1: SW_Push; SW_SPST_PTS645; MPN PTS645SM43SMTR92 LFS
TP1: TestPoint; TestPoint_Pad_D1.0mm
U1: PIC32MX795F512L; TQFP-100_12x12mm_P0.4mm; MPN PIC32MX795F512LT-80I/PT
U2: REG71055DDC; SOT-23-6; MPN REG71055DDCT
U3: AP22802AW5; SOT-23-5; MPN AP22802AW5-7
U5: TPS62131RGT; QFN-16-1EP_3x3mm_P0.5mm_EP1.8x1.8mm; MPN TPS62131RGTT
U6: TPS70950DBV; SOT-23-5; MPN TPS70950DBVR
U7, U8: TPD4E1U06DBV; SOT-23-6; MPN TPD4E1U06DBVR
Y1: ABLS-8.000MHZ-B4-T; ABLS_OX; MPN ABLS-8.000MHZ-B4-T
Y3: ABS07-32.768KHZ-1-T; ABLS_SEC; MPN ABS07-32.768KHZ-1-T

Connections:
+3V3: C1.1, C2.1, C3.1, C5.1, C6.1, C7.1, C8.1, C30.1, C32.1, C34.1, D9.2 (A), J1.2, L1.1, L3.1, Q2.2 (S), R1.1, R2.2, R4.1, R5.1, R6.1, R7.1, R8.1, R9.1, U1.2 (VDD), U1.16 (VDD), U1.37 (VDD), U1.46 (VDD), U1.55 (VUSB3V3), U1.62 (VDD), U1.86 (VDD), U5.14 (VOS); also elsewhere on the board
+5V: C16.1, C17.1, C18.1, C19.1, C21.1, D4.2 (A), F1.1, J4.4, U2.3 (EN), U2.5 (VIN), U3.5 (IN), U5.10 (AVIN), U5.11 (PVIN), U5.12 (PVIN), U5.13 (EN); also elsewhere on the board
+5V_REG: C31.1, C33.1, D8.2 (A), U6.5 (VOUT); also elsewhere on the board
ADI_MISO: U1.52 (SDI3); also elsewhere on the board
ADI_MOSI: U1.53 (SDO3); also elsewhere on the board
ADI_SCLK: U1.48 (SCK3); also elsewhere on the board
CONFIG_ADC: R9.2, R10.1, TP1.1, U1.32 (AN8)
DC_PWM_1: U1.76 (OC2); also elsewhere on the board
DC_PWM_2: U1.77 (OC3); also elsewhere on the board
DEBUG_BTN_1: U1.92 (RA7); also elsewhere on the board
DEBUG_BTN_2: U1.91 (RA6); also elsewhere on the board
DEBUG_BTN_3: U1.90 (RG0); also elsewhere on the board
DEBUG_LED_1: U1.89 (RG1); also elsewhere on the board
DEBUG_LED_2: U1.88 (RF1); also elsewhere on the board
DEBUG_LED_3: U1.87 (RF0); also elsewhere on the board
DGND: C1.2, C2.2, C3.2, C4.2, C5.2, C6.2, C7.2, C8.2, C9.2, C10.2, C11.2, C12.2, C13.2, C14.2, C15.2, C16.2, C17.2, C18.2, C19.2, C21.2, C23.2, C24.2, C25.2, C26.2, C27.2, C30.2, C31.2, C32.2, C33.2, C34.2, C35.1, C90.2, D3.2 (A2), D6.2 (A2), J1.3, J2.5 (GND), J3.4 (GND), J4.1, J5.1, J6.1, J17.1, J18.1, Q1.2 (S), R3.2, R10.2, R11.2, R12.2, R18.2, R19.2, SW1.2, U1.15 (VSS), U1.31 (AVSS), U1.36 (VSS), U1.45 (VSS), U1.65 (VSS), U1.75 (VSS), U2.2 (GND), U3.2 (GND), U5.4 (PG), U5.5 (FB), U5.6 (AGND), U5.7 (FSW), U5.8 (DEF), U5.15 (PGND), U5.16 (PGND), U5.17 (EP), U6.2 (GND), U7.2 (GND), U8.2 (GND); also elsewhere on the board
ENCDR_A: U1.68 (IC1); also elsewhere on the board
ENCDR_B: U1.69 (IC2); also elsewhere on the board
GPS_EXTINT: U1.7 (RC2); also elsewhere on the board
GPS_PPS: U1.79 (IC5); also elsewhere on the board
unnamed: C4.1, U1.73 (SOSCI), Y3.1
unnamed: C9.1, C10.1, L1.2, U1.30 (AVDD)
unnamed: C11.1, U1.64 (OSC2), Y1.2
unnamed: C12.1, U1.85 (VCAP/VDDCORE)
unnamed: C13.1, U1.63 (OSC1), Y1.1
unnamed: C14.1, J2.6 (Shield)
unnamed: C22.1, U2.6 (C+)
unnamed: C22.2, U2.4 (C-)
unnamed: C23.1, U5.9 (SS/TR)
unnamed: C24.1, C26.1, U2.1 (VOUT), U6.1 (VIN), U6.3 (EN)
unnamed: C35.2, J3.5 (Shield)
unnamed: C90.1, U1.74 (SOSCO), Y3.2
unnamed: D1.1 (K), Q1.3 (D)
unnamed: D1.2 (A), R2.1
unnamed: D2.1 (K), R3.1
unnamed: D2.2 (A), Q2.3 (D), U1.44 (CN12)
unnamed: D3.1 (A1), F1.2, J2.1 (VBUS)
unnamed: D4.1 (K), R11.1
unnamed: D8.1 (K), R18.1
unnamed: D9.1 (K), R19.1
unnamed: J4.2, R21.2
unnamed: J4.3, R20.2
unnamed: L3.2, U5.1 (SW), U5.2 (SW), U5.3 (SW)
ONBRD_SCL: R6.2, U1.66 (SCL1); also elsewhere on the board
ONBRD_SDA: R7.2, U1.67 (SDA1); also elsewhere on the board
PICKIT_MCLR: C15.1, J1.1, R8.2, SW1.1, U1.13 (~MCLR)
PICKIT_PGEC: J1.5, U1.26 (PGEC2)
PICKIT_PGED: J1.4, U1.27 (PGED2)
PMOD_ADC_1: U1.35 (AN11); also elsewhere on the board
PMOD_ADC_2: U1.41 (AN12); also elsewhere on the board
PMOD_ADC_3: U1.42 (AN13); also elsewhere on the board
PMOD_ADC_4: U1.43 (AN14); also elsewhere on the board
PMOD_CN_1: U1.84 (CN16); also elsewhere on the board
PMOD_CN_2: U1.80 (CN19); also elsewhere on the board
PMOD_GPIO_1: U1.93 (RE0); also elsewhere on the board
PMOD_GPIO_2: U1.94 (RE1); also elsewhere on the board
PMOD_GPIO_3: U1.95 (RG14); also elsewhere on the board
PMOD_GPIO_4: U1.96 (RG12); also elsewhere on the board
PMOD_GPIO_5: U1.97 (RG13); also elsewhere on the board
PMOD_GPIO_6: U1.98 (RE2); also elsewhere on the board
PMOD_GPIO_7: U1.99 (RE3); also elsewhere on the board
PMOD_GPIO_8: U1.100 (RE4); also elsewhere on the board
PMOD_GPIO_9: U1.4 (RE6); also elsewhere on the board
PMOD_GPIO_10: U1.5 (RE7); also elsewhere on the board
PMOD_PWM_1: U1.78 (OC4); also elsewhere on the board
PMOD_PWM_2: U1.81 (OC5); also elsewhere on the board
PMOD_SCL: R4.2, U1.58 (SCL2); also elsewhere on the board
PMOD_SDA: R5.2, U1.59 (SDA2); also elsewhere on the board
POTEN_ADC_1: U1.34 (AN10); also elsewhere on the board
POTEN_ADC_2: U1.33 (AN9); also elsewhere on the board
SCREEN_RX: R20.1, U1.49 (U2RX), U8.4 (D2-)
SCREEN_TX: R21.1, U1.50 (U2TX), U8.3 (D2+)
SD_MISO: U1.11 (SDI2); also elsewhere on the board
SD_MOSI: U1.12 (SDO2); also elsewhere on the board
SD_SCLK: U1.10 (SCK2); also elsewhere on the board
SONIC_ECHO: U1.71 (IC4); also elsewhere on the board
SONIC_TRIG: U1.6 (RC1); also elsewhere on the board
STEP_DECAY: U1.40 (RF12); also elsewhere on the board
STEP_DIR: U1.39 (RF13); also elsewhere on the board
STEP_MODE0: U1.28 (RA9); also elsewhere on the board
STEP_MODE1: U1.29 (RA10); also elsewhere on the board
STEP_MODE2: U1.38 (RA1); also elsewhere on the board
STEP_STEP: U1.17 (RA0); also elsewhere on the board
USB_D+: J3.3 (D+), U1.57 (D+), U7.4 (D2-)
USB_D-: J3.2 (D-), U1.56 (D-), U7.3 (D2+)
USB_PWR_EN: R12.1, U1.20 (VBUSON), U3.4 (EN)
USB_PWR_SENSE: C25.1, C27.1, D6.1 (A1), J3.1 (VBUS), U1.54 (VBUS), U3.1 (OUT)
~ADI_CS: U1.51 (USBID); also elsewhere on the board
~DC_FAULT: U1.18 (INT1); also elsewhere on the board
~GPS_RESET: U1.8 (RC3); also elsewhere on the board
~PWR_FAULT: Q1.1 (G), Q2.1 (G), R1.2, U3.3 (FLG); also elsewhere on the board
~SD_CS: U1.3 (RE5); also elsewhere on the board
~STEP_ENBL: U1.14 (RG9); also elsewhere on the board
~STEP_FAULT: U1.19 (INT2); also elsewhere on the board
~STEP_HOME: U1.83 (CN15); also elsewhere on the board
~STEP_RESET: U1.60 (RA4); also elsewhere on the board
~STEP_SLEEP: U1.47 (RD14); also elsewhere on the board

Notes on the sheet:
Digital & Analog Power Supply
Analog Plane; see ADI ADC note
(50ms Soft Start)
SRN6045TA-2R2Y
Bulk
No Pin
Pin 2
Pin 16
Pin 15
Pin 46
Pin 45
Pin 37
Pin 36
Pin 62
Pin 65
Pin 75
PIC32 Microcontroller
PICKit3 Programming Header
MCU Reset
Software Config Divider
Cart: 10K Pusher: 10K Stabber: DNP
Cart: DNP Pusher: 10K Stabber: 10K
USB 2.0 Host Interface
PIC32 Microcontroller Power Pins
Power Good: Green LED On/Red LED Off Power Fault: Green LED Off/Red LED On
Nextion Display Header
Top Left
Top Right
Bottom Left
Bottom Right
Nextion Screen Mounting Holes

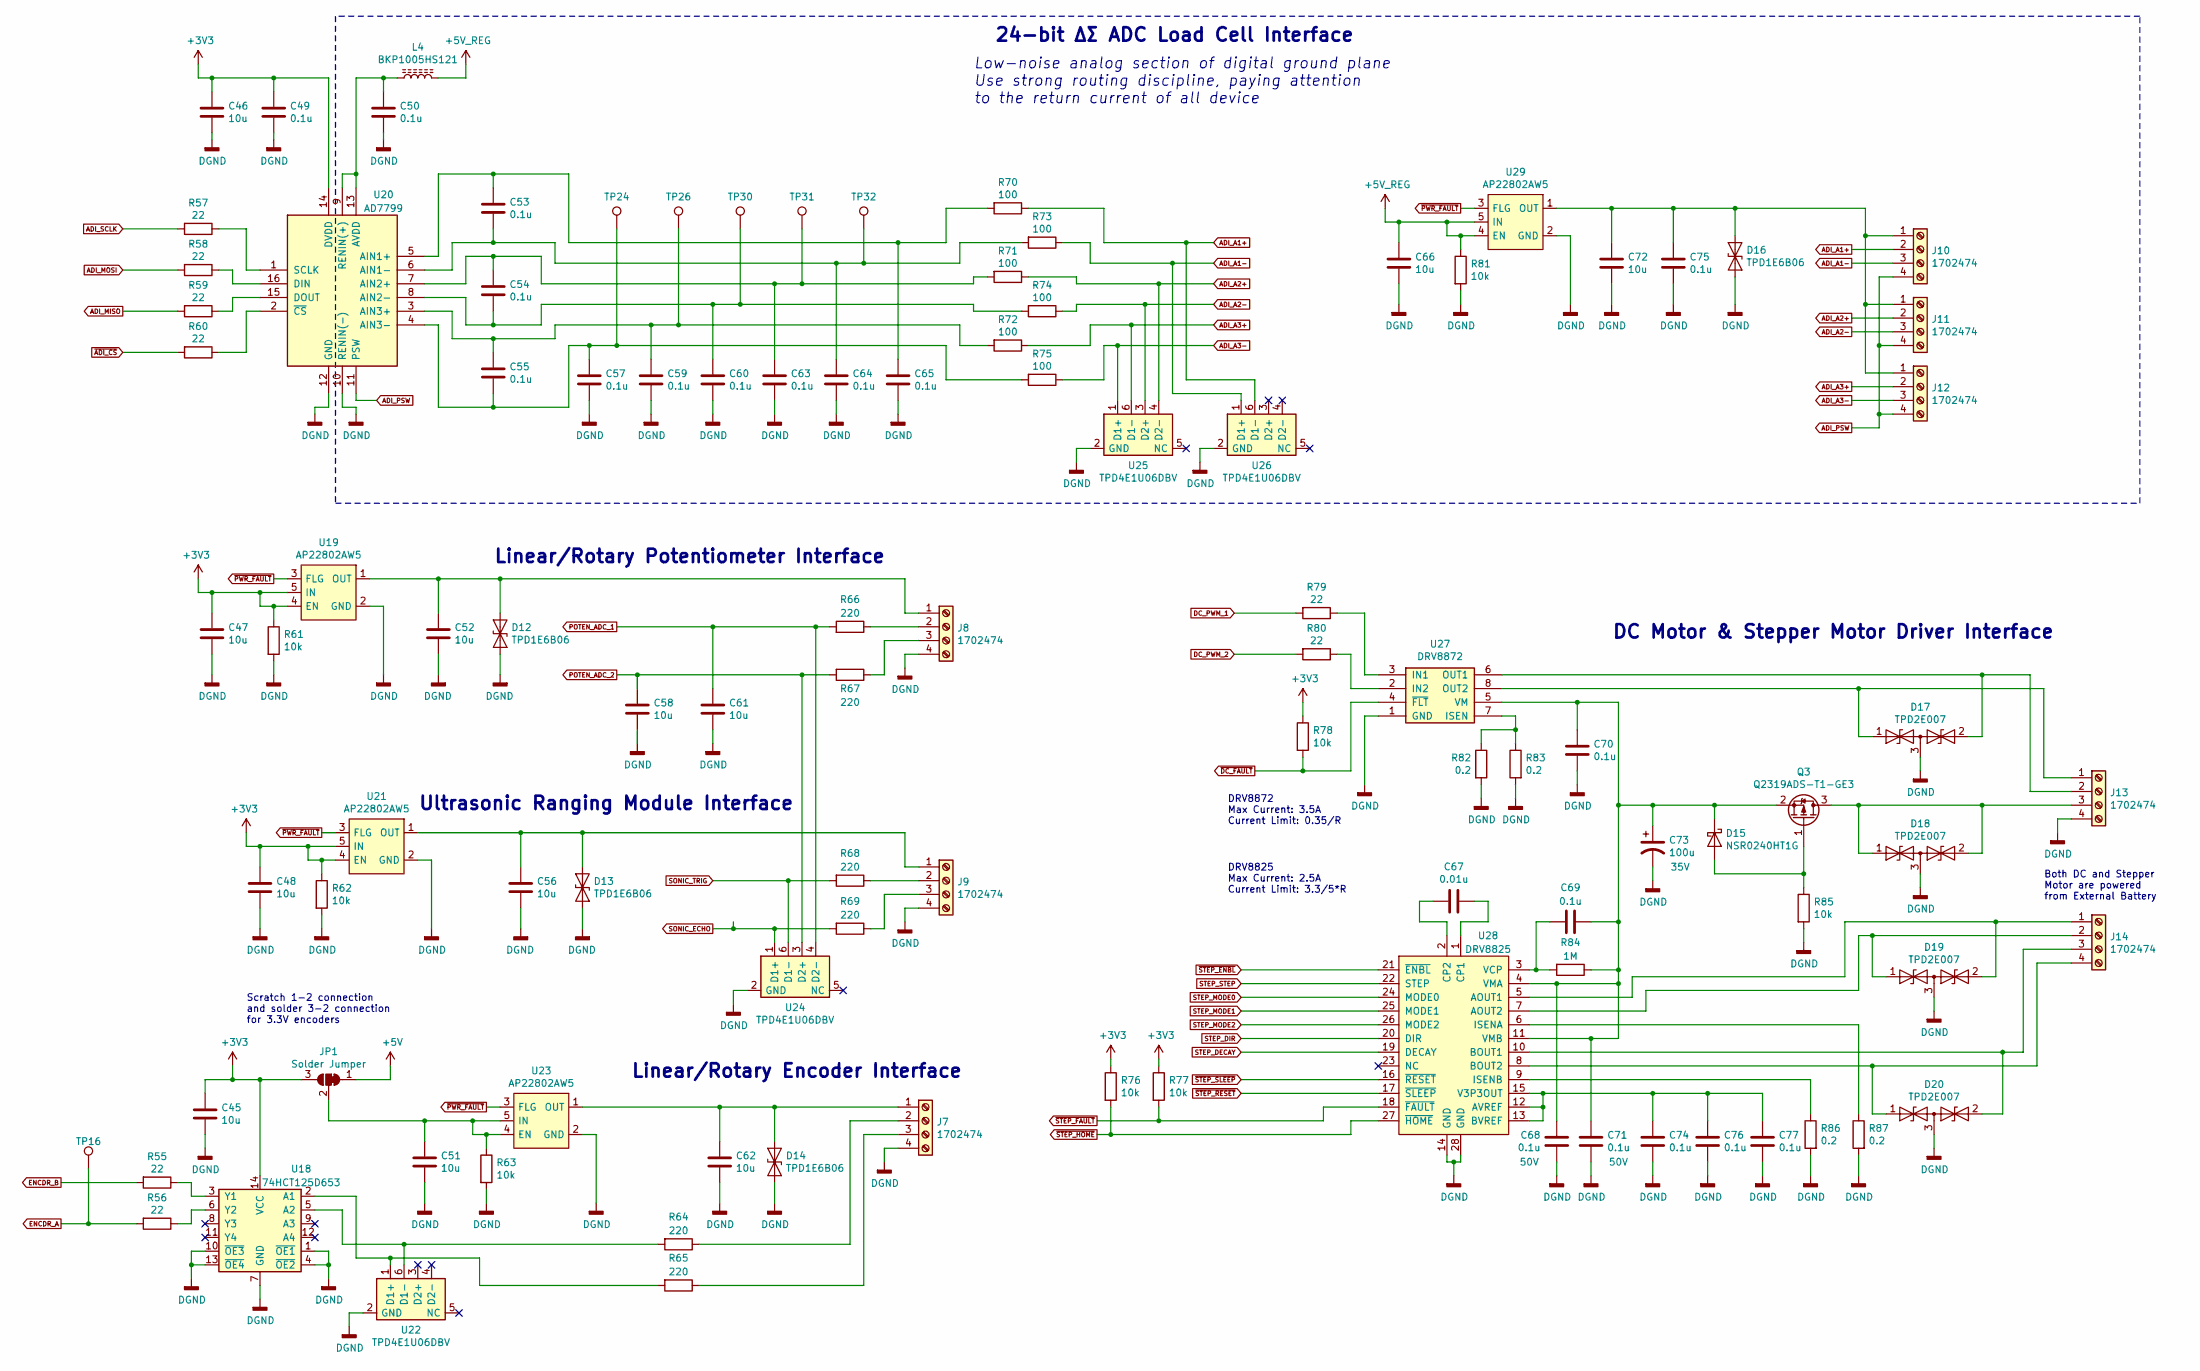
[picture p51: schematic croptop_io.sch, CropTop 2.2]

Parts:
C45, C46, C47, C48, C51, C52, C56, C58, C61, C62, C66, C72: 10u; C_1206_3216Metric; MPN CC1206ZRY5V6BB106
C49, C50, C53, C54, C55, C57, C59, C60, C63, C64, C65, C74, C75, C76, C77: 0.1u; C_0402_1005Metric; MPN CL05F104ZO5NNNC
C67: 0.01u; C_0402_1005Metric; Rating 50V; MPN CC0402KRX7R9BB103
C68, C71: 0.1u; C_0805_2012Metric; Rating 50V; MPN C0805C104Z5VACTU
C69: 0.1u; C_0402_1005Metric; Rating 50V; MPN CL05F104ZO5NNNC
C70: 0.1u; C_0805_2012Metric; MPN C0805C104Z5VACTU
C73: 100u; CP_Elec_6.3x7.7; Rating 35V; MPN UWT1V101MCL1GS
D12, D13, D14, D16: TPD1E6B06; D_0201_0603Metric; MPN TPD1E6B06DPLR
D15: NSR0240HT1G; D_SOD-323; MPN NSR0240HT1G
D17, D18, D19, D20: TPD2E007; SOT-323_SC-70; MPN TPD2E007DCKR
J7, J8, J9, J10, J11, J12, J13, J14: 1702474; solderless_terminal; MPN 1702474
JP1: Solder Jumper; SolderJumper-3_P1.3mm_Bridged12_RoundedPad1.0x1.5mm; MPN JL-100-25-T
L4: BKP1005HS121; L_0402_1005Metric; MPN BKP1005HS121-TV
Q3: Q2319ADS-T1-GE3; SOT-23; MPN SQ2319ADS-T1_GE3
R55, R56, R57, R58, R59, R60, R79, R80: 22; R_0402_1005Metric; MPN RC0402FR-0722RL
R61, R62, R63, R76, R77, R78, R81, R85: 10k; R_0402_1005Metric; MPN RC0402FR-0710KL
R64, R65, R66, R67, R68, R69: 220; R_0402_1005Metric; MPN CRGCQ0402F220R
R70, R71, R72, R73, R74, R75: 100; R_0402_1005Metric; MPN RC0402FR-07100RL
R82, R83, R86, R87: 0.2; R_2512_6332Metric; MPN CSRN2512FKR200
R84: 1M; R_0402_1005Metric; MPN RC0402FR-071ML
TP16, TP24, TP26, TP30, TP31, TP32: TestPoint; TestPoint_Pad_D1.0mm
U18: 74HCT125D653; SOIC-14_3.9x8.7mm_P1.27mm; MPN 74HCT125D,653
U19, U21, U23, U29: AP22802AW5; SOT-23-5; MPN AP22802AW5-7
U20: AD7799; TSSOP-16_4.4x5mm_P0.65mm; MPN AD7799BRUZ
U22, U24, U25, U26: TPD4E1U06DBV; SOT-23-6; MPN TPD4E1U06DBVR
U27: DRV8872; 8-PowerSOIC; MPN DRV8872DDAR
U28: DRV8825; HTSSOP-28-1EP_4.4x9.7mm_P0.65mm_EP3.4x9.5mm_Mask2.4x6.17mm_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; MPN DRV8825PWPR

Connections:
+3V3: C45.1, C46.1, C47.1, C48.1, C49.1, JP1.3 (B), R61.1, R62.1, R76.1, R77.1, R78.1, U18.14 (VCC), U19.4 (EN), U19.5 (IN), U20.14 (DVDD), U21.4 (EN), U21.5 (IN); also elsewhere on the board
+5V: JP1.1 (A); also elsewhere on the board
+5V_REG: C66.1, L4.2, R81.1, U29.4 (EN), U29.5 (IN); also elsewhere on the board
ADI_A1+: J10.2, R70.1, U26.6 (D1-)
ADI_A1-: J10.3, R73.1, U26.1 (D1+)
ADI_A2+: J11.2, R71.1, U25.4 (D2-)
ADI_A2-: J11.3, R74.1, U25.3 (D2+)
ADI_A3+: J12.2, R72.1, U25.6 (D1-)
ADI_A3-: J12.3, R75.1, U25.1 (D1+)
ADI_MISO: R59.2; also elsewhere on the board
ADI_MOSI: R58.2; also elsewhere on the board
ADI_PSW: J10.4, J11.4, J12.4, U20.11 (PSW)
ADI_SCLK: R57.2; also elsewhere on the board
DC_PWM_1: R79.2; also elsewhere on the board
DC_PWM_2: R80.2; also elsewhere on the board
DGND: C45.2, C46.2, C47.2, C48.2, C49.2, C50.2, C51.2, C52.2, C56.2, C57.1, C58.2, C59.1, C60.1, C61.2, C62.2, C63.1, C64.1, C65.1, C66.2, C68.2, C70.2, C71.2, C72.2, C73.2, C74.2, C75.1, C76.2, C77.2, D12.1 (A1), D13.1 (A1), D14.1 (A1), D16.2 (A2), D17.3 (common), D18.3 (common), D19.3 (common), D20.3 (common), J7.4, J8.4, J9.4, J13.4, R61.2, R62.2, R63.2, R81.2, R82.2, R83.2, R85.2, R86.2, R87.2, U18.1 (~OE1), U18.4 (~OE2), U18.7 (GND), U18.10 (~OE3), U18.13 (~OE4), U19.2 (GND), U20.10 (RENIN(-)), U20.12 (GND), U21.2 (GND), U22.2 (GND), U23.2 (GND), U24.2 (GND), U25.2 (GND), U26.2 (GND), U27.1 (GND), U28.14 (GND), U28.28 (GND), U29.2 (GND); also elsewhere on the board
ENCDR_A: R56.2, TP16.1; also elsewhere on the board
ENCDR_B: R55.2; also elsewhere on the board
unnamed: C50.1, L4.1, U20.9 (RENIN(+)), U20.13 (AVDD)
unnamed: C51.1, JP1.2 (C), R63.1, U23.4 (EN), U23.5 (IN)
unnamed: C52.1, D12.2 (A2), J8.1, U19.1 (OUT)
unnamed: C53.1, C64.2, R73.2, TP32.1, U20.6 (AIN1-)
unnamed: C53.2, C65.2, R70.2, U20.5 (AIN1+)
unnamed: C54.1, C60.2, R74.2, TP30.1, U20.8 (AIN2-)
unnamed: C54.2, C63.2, R71.2, TP31.1, U20.7 (AIN2+)
unnamed: C55.1, C57.2, R75.2, TP24.1, U20.4 (AIN3-)
unnamed: C55.2, C59.2, R72.2, TP26.1, U20.3 (AIN3+)
unnamed: C56.1, D13.2 (A2), J9.1, U21.1 (OUT)
unnamed: C62.1, D14.2 (A2), J7.1, U23.1 (OUT)
unnamed: C67.1, U28.2 (CP2)
unnamed: C67.2, U28.1 (CP1)
unnamed: C68.1, C69.2, C70.1, C71.1, C73.1, D15.1 (K), Q3.2 (S), R84.1, U27.5 (VM), U28.4 (VMA), U28.11 (VMB)
unnamed: C69.1, R84.2, U28.3 (VCP)
unnamed: C72.1, C75.2, D16.1 (A1), J10.1, J11.1, J12.1, U29.1 (OUT)
unnamed: C74.1, C76.1, C77.1, U28.12 (AVREF), U28.13 (BVREF), U28.15 (V3P3OUT)
unnamed: D15.2 (A), Q3.1 (G), R85.1
unnamed: D17.1 (A1), J13.1, U27.8 (OUT2)
unnamed: D17.2 (A2), J13.2, U27.6 (OUT1)
unnamed: D18.1 (A1), D18.2 (A2), J13.3, Q3.3 (D)
unnamed: D19.1 (A1), J14.2, U28.7 (AOUT2)
unnamed: D19.2 (A2), J14.1, U28.5 (AOUT1)
unnamed: D20.1 (A1), J14.4, U28.8 (BOUT2)
unnamed: D20.2 (A2), J14.3, U28.10 (BOUT1)
unnamed: J7.2, R64.1
unnamed: J7.3, R65.1
unnamed: J8.2, R66.1
unnamed: J8.3, R67.1
unnamed: J9.2, R68.1
unnamed: J9.3, R69.1
unnamed: R55.1, U18.3 (Y1)
unnamed: R56.1, U18.6 (Y2)
unnamed: R57.1, U20.1 (SCLK)
unnamed: R58.1, U20.16 (DIN)
unnamed: R59.1, U20.15 (DOUT)
unnamed: R60.1, U20.2 (~CS)
unnamed: R64.2, U18.5 (A2), U22.6 (D1-)
unnamed: R65.2, U18.2 (A1), U22.1 (D1+)
unnamed: R79.1, U27.3 (IN1)
unnamed: R80.1, U27.2 (IN2)
unnamed: R82.1, R83.1, U27.7 (ISEN)
unnamed: R86.1, U28.9 (ISENB)
unnamed: R87.1, U28.6 (ISENA)
POTEN_ADC_1: C61.1, R66.2, U24.4 (D2-); also elsewhere on the board
POTEN_ADC_2: C58.1, R67.2, U24.3 (D2+); also elsewhere on the board
SONIC_ECHO: R69.2, U24.1 (D1+); also elsewhere on the board
SONIC_TRIG: R68.2, U24.6 (D1-); also elsewhere on the board
STEP_DECAY: U28.19 (DECAY); also elsewhere on the board
STEP_DIR: U28.20 (DIR); also elsewhere on the board
STEP_MODE0: U28.24 (MODE0); also elsewhere on the board
STEP_MODE1: U28.25 (MODE1); also elsewhere on the board
STEP_MODE2: U28.26 (MODE2); also elsewhere on the board
STEP_STEP: U28.22 (STEP); also elsewhere on the board
~ADI_CS: R60.2; also elsewhere on the board
~DC_FAULT: R78.2, U27.4 (~FLT); also elsewhere on the board
~PWR_FAULT: U19.3 (FLG), U21.3 (FLG), U23.3 (FLG), U29.3 (FLG); also elsewhere on the board
~STEP_ENBL: U28.21 (~ENBL); also elsewhere on the board
~STEP_FAULT: R77.2, U28.18 (~FAULT); also elsewhere on the board
~STEP_HOME: R76.2, U28.27 (~HOME); also elsewhere on the board
~STEP_RESET: U28.17 (~SLEEP); also elsewhere on the board
~STEP_SLEEP: U28.16 (~RESET); also elsewhere on the board

Notes on the sheet:
Low-noise analog section of digital ground plane Use strong routing discipline, paying attention to the return current of all device
DC Motor & Stepper Motor Driver Interface
24-bit ΔΣ ADC Load Cell Interface
Linear/Rotary Encoder Interface
DRV8872 Max Current: 3.5A Current Limit: 0.35/R
DRV8825 Max Current: 2.5A Current Limit: 3.3/5*R
Ultrasonic Ranging Module Interface
Linear/Rotary Potentiometer Interface
Scratch 1-2 connection and solder 3-2 connection for 3.3V encoders
Both DC and Stepper Motor are powered from External Battery

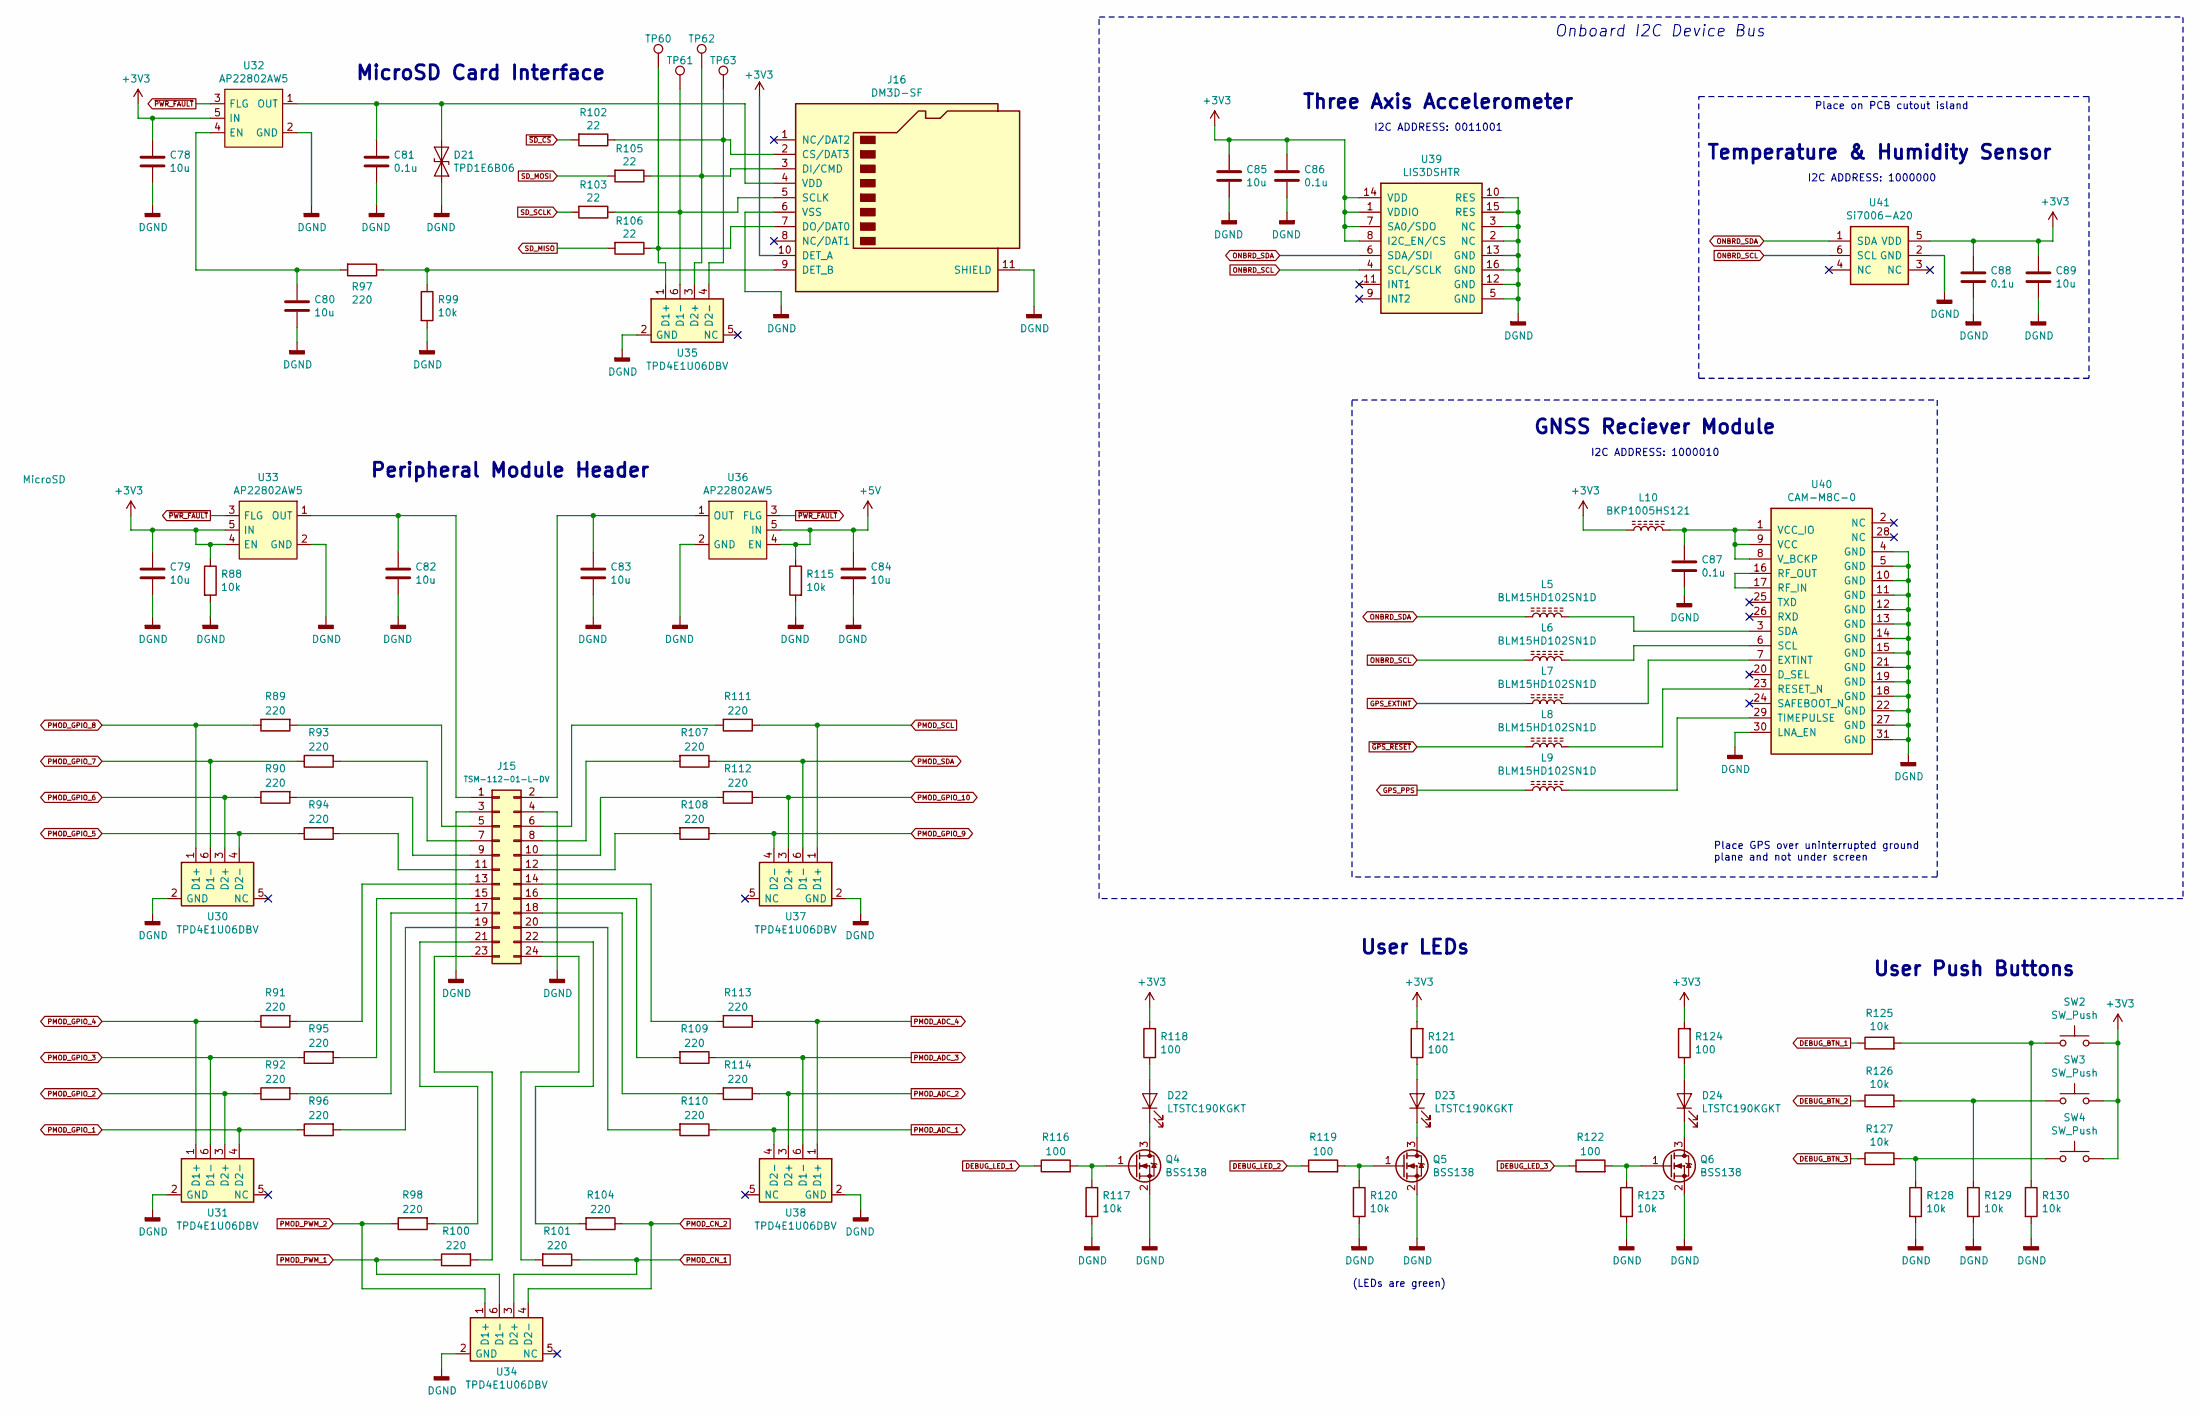
[picture p52: schematic croptop_onboard.sch, CropTop 2.2]

Parts:
C78, C79, C80, C82, C83, C84, C85, C89: 10u; C_1206_3216Metric; MPN CC1206ZRY5V6BB106
C81, C86, C87, C88: 0.1u; C_0402_1005Metric; MPN CL05F104ZO5NNNC
D21: TPD1E6B06; D_0201_0603Metric; MPN TPD1E6B06DPLR
D22, D23, D24: LTSTC190KGKT; LED_0603_1608Metric; MPN LTST-C190KGKT
J15: TSM-112-01-L-DV; PinHeader_2x12_P2.54mm_Vertical_SMD; MPN TSM-112-01-L-DV
J16: DM3D-SF; microSD_HC_Hirose_DM3D-SF; MPN DM3D-SF
L5, L6, L7, L8, L9: BLM15HD102SN1D; L_0402_1005Metric; MPN BLM15HD102SN1D
L10: BKP1005HS121; L_0402_1005Metric; MPN BKP1005HS121-TV
Q4, Q5, Q6: BSS138; SOT-23; MPN BSS138-TP
R88, R99, R115, R117, R120, R123, R125, R126, R127, R128, R129, R130: 10k; R_0402_1005Metric; MPN RC0402FR-0710KL
R89, R90, R91, R92, R93, R94, R95, R96, R97, R98, R100, R101, R104, R107, R108, R109, R110, R111, R112, R113, R114: 220; R_0402_1005Metric; MPN CRGCQ0402F220R
R102, R103, R105, R106: 22; R_0402_1005Metric; MPN RC0402FR-0722RL
R116, R118, R119, R121, R122, R124: 100; R_0402_1005Metric; MPN RC0402FR-07100RL
SW2, SW3, SW4: SW_Push; SW_SPST_PTS645; MPN PTS645SM43SMTR92 LFS
TP60, TP61, TP62, TP63: TestPoint; TestPoint_Pad_D1.0mm
U30, U31, U34, U35, U37, U38: TPD4E1U06DBV; SOT-23-6; MPN TPD4E1U06DBVR
U32, U33, U36: AP22802AW5; SOT-23-5; MPN AP22802AW5-7
U39: LIS3DSHTR; LISDR; MPN LIS3DSHTR
U40: CAM-M8C-0; GPS; MPN CAM-M8C-0-10
U41: Si7006-A20; SI7006; MPN SI7006-A20-IMR

Connections:
+3V3: C78.1, C79.1, C85.1, C86.1, C88.1, C89.1, J16.10 (DET_A), L10.1, R88.1, R118.2, R121.2, R124.2, SW2.2, SW3.2, SW4.2, U32.5 (IN), U33.4 (EN), U33.5 (IN), U39.1 (VDDIO), U39.7 (SA0/SDO), U39.8 (I2C_EN/CS), U39.14 (VDD), U41.5 (VDD); also elsewhere on the board
+5V: C84.1, R115.1, U36.4 (EN), U36.5 (IN); also elsewhere on the board
DEBUG_BTN_1: R125.1; also elsewhere on the board
DEBUG_BTN_2: R126.1; also elsewhere on the board
DEBUG_BTN_3: R127.1; also elsewhere on the board
DEBUG_LED_1: R116.1; also elsewhere on the board
DEBUG_LED_2: R119.1; also elsewhere on the board
DEBUG_LED_3: R122.1; also elsewhere on the board
DGND: C78.2, C79.2, C80.2, C81.2, C82.2, C83.2, C84.2, C85.2, C86.2, C87.2, C88.2, C89.2, D21.1 (A1), J15.3, J15.4, J16.6 (VSS), J16.11 (SHIELD), Q4.2 (S), Q5.2 (S), Q6.2 (S), R88.2, R99.2, R115.2, R117.2, R120.2, R123.2, R128.2, R129.2, R130.2, U30.2 (GND), U31.2 (GND), U32.2 (GND), U33.2 (GND), U34.2 (GND), U35.2 (GND), U36.2 (GND), U37.2 (GND), U38.2 (GND), U39.2 (NC), U39.3 (NC), U39.5 (GND), U39.10 (RES), U39.12 (GND), U39.13 (GND), U39.15 (RES), U39.16 (GND), U40.4 (GND), U40.5 (GND), U40.10 (GND), U40.11 (GND), U40.12 (GND), U40.13 (GND), U40.14 (GND), U40.15 (GND), U40.18 (GND), U40.19 (GND), U40.21 (GND), U40.22 (GND), U40.27 (GND), U40.30 (LNA_EN), U40.31 (GND), U41.2 (GND); also elsewhere on the board
GPS_EXTINT: L7.1; also elsewhere on the board
GPS_PPS: L9.1; also elsewhere on the board
unnamed: C80.1, R97.2, U32.4 (EN)
unnamed: C81.1, D21.2 (A2), J16.4 (VDD), U32.1 (OUT)
unnamed: C82.1, J15.1, U33.1 (OUT)
unnamed: C83.1, J15.2, U36.1 (OUT)
unnamed: C87.1, L10.2, U40.1 (VCC_IO), U40.8 (V_BCKP), U40.9 (VCC)
unnamed: D22.1 (K), Q4.3 (D)
unnamed: D22.2 (A), R118.1
unnamed: D23.1 (K), Q5.3 (D)
unnamed: D23.2 (A), R121.1
unnamed: D24.1 (K), Q6.3 (D)
unnamed: D24.2 (A), R124.1
unnamed: J15.5, R89.2
unnamed: J15.6, R111.2
unnamed: J15.7, R93.2
unnamed: J15.8, R107.2
unnamed: J15.9, R90.2
unnamed: J15.10, R112.2
unnamed: J15.11, R94.2
unnamed: J15.12, R108.2
unnamed: J15.13, R91.2
unnamed: J15.14, R113.2
unnamed: J15.15, R95.2
unnamed: J15.16, R109.2
unnamed: J15.17, R92.2
unnamed: J15.18, R114.2
unnamed: J15.19, R96.2
unnamed: J15.20, R110.2
unnamed: J15.21, R98.2
unnamed: J15.22, R104.2
unnamed: J15.23, R100.2
unnamed: J15.24, R101.2
unnamed: J16.2 (CS/DAT3), R102.1, TP63.1, U35.4 (D2-)
unnamed: J16.3 (DI/CMD), R105.1, TP62.1, U35.3 (D2+)
unnamed: J16.5 (SCLK), R103.1, TP61.1, U35.6 (D1-)
unnamed: J16.7 (DO/DAT0), R106.1, TP60.1, U35.1 (D1+)
unnamed: J16.9 (DET_B), R97.1, R99.1
unnamed: L5.2, U40.3 (SDA)
unnamed: L6.2, U40.6 (SCL)
unnamed: L7.2, U40.7 (EXTINT)
unnamed: L8.2, U40.23 (RESET_N)
unnamed: L9.2, U40.29 (TIMEPULSE)
unnamed: Q4.1 (G), R116.2, R117.1
unnamed: Q5.1 (G), R119.2, R120.1
unnamed: Q6.1 (G), R122.2, R123.1
unnamed: R125.2, R130.1, SW2.1
unnamed: R126.2, R129.1, SW3.1
unnamed: R127.2, R128.1, SW4.1
unnamed: U40.16 (RF_OUT), U40.17 (RF_IN)
ONBRD_SCL: L6.1, U39.4 (SCL/SCLK), U41.6 (SCL); also elsewhere on the board
ONBRD_SDA: L5.1, U39.6 (SDA/SDI), U41.1 (SDA); also elsewhere on the board
PMOD_ADC_1: R110.1, U38.4 (D2-); also elsewhere on the board
PMOD_ADC_2: R114.1, U38.3 (D2+); also elsewhere on the board
PMOD_ADC_3: R109.1, U38.6 (D1-); also elsewhere on the board
PMOD_ADC_4: R113.1, U38.1 (D1+); also elsewhere on the board
PMOD_CN_1: R101.1, U34.3 (D2+); also elsewhere on the board
PMOD_CN_2: R104.1, U34.4 (D2-); also elsewhere on the board
PMOD_GPIO_1: R96.1, U31.4 (D2-); also elsewhere on the board
PMOD_GPIO_2: R92.1, U31.3 (D2+); also elsewhere on the board
PMOD_GPIO_3: R95.1, U31.6 (D1-); also elsewhere on the board
PMOD_GPIO_4: R91.1, U31.1 (D1+); also elsewhere on the board
PMOD_GPIO_5: R94.1, U30.4 (D2-); also elsewhere on the board
PMOD_GPIO_6: R90.1, U30.3 (D2+); also elsewhere on the board
PMOD_GPIO_7: R93.1, U30.6 (D1-); also elsewhere on the board
PMOD_GPIO_8: R89.1, U30.1 (D1+); also elsewhere on the board
PMOD_GPIO_9: R108.1, U37.4 (D2-); also elsewhere on the board
PMOD_GPIO_10: R112.1, U37.3 (D2+); also elsewhere on the board
PMOD_PWM_1: R100.1, U34.6 (D1-); also elsewhere on the board
PMOD_PWM_2: R98.1, U34.1 (D1+); also elsewhere on the board
PMOD_SCL: R111.1, U37.1 (D1+); also elsewhere on the board
PMOD_SDA: R107.1, U37.6 (D1-); also elsewhere on the board
SD_MISO: R106.2; also elsewhere on the board
SD_MOSI: R105.2; also elsewhere on the board
SD_SCLK: R103.2; also elsewhere on the board
~GPS_RESET: L8.1; also elsewhere on the board
~PWR_FAULT: U32.3 (FLG), U33.3 (FLG), U36.3 (FLG); also elsewhere on the board
~SD_CS: R102.2; also elsewhere on the board

Notes on the sheet:
User Push Buttons
Temperature & Humidity Sensor
MicroSD Card Interface
GNSS Reciever Module
Three Axis Accelerometer
Peripheral Module Header
I2C ADDRESS: 0011001
I2C ADDRESS: 1000000
I2C ADDRESS: 1000010
Onboard I2C Device Bus
User LEDs
(LEDs are green)
Place on PCB cutout island
Place GPS over uninterrupted ground plane and not under screen
