CollinHeist/CropTop/PCB v3.0/croptop.kicad_pcb

## KiCad design PCB v3.0/croptop.kicad_pcb (continued)

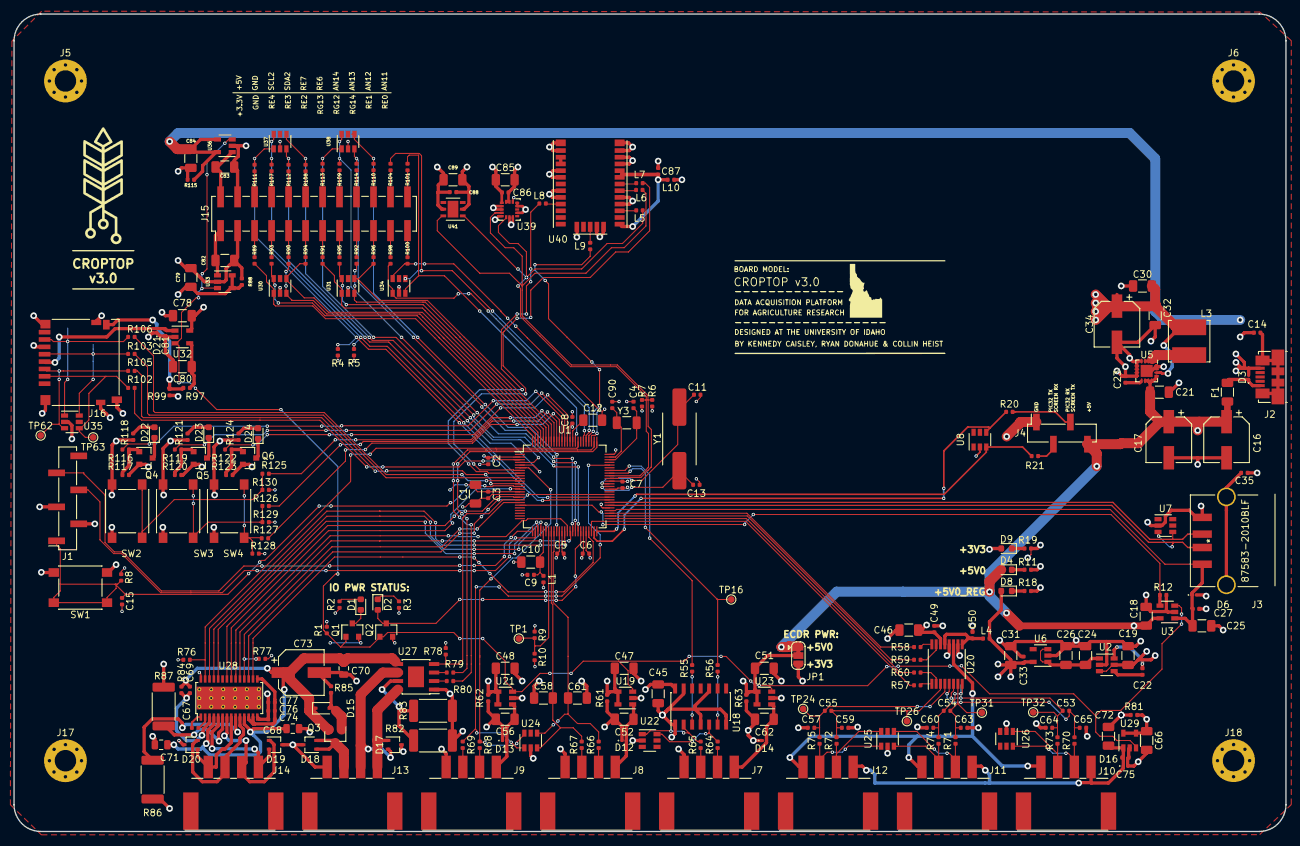
[picture p53: board PCB v3.0/croptop.kicad_pcb from above]

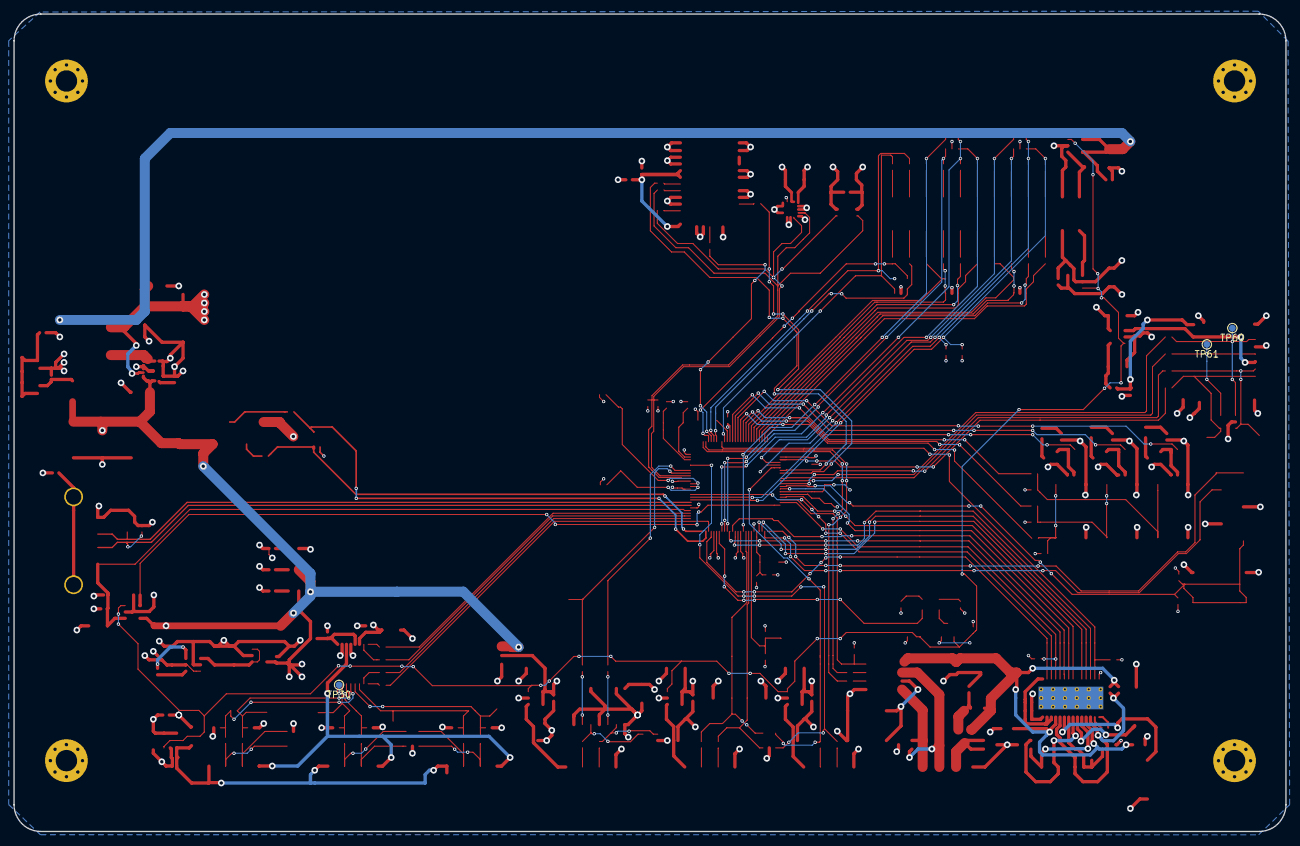
[picture p54: board PCB v3.0/croptop.kicad_pcb from below]

Board: 4 copper layers, 190.1 x 122.2 mm, 274 parts (3 on the bottom side), 196 nets.

Other parts of the board:
 : idaho
