CollinHeist/CropTop/PCB v1.0/croptop.kicad_pcb

## KiCad design PCB v1.0/croptop.kicad_pcb (2019-04-05, an earlier design)

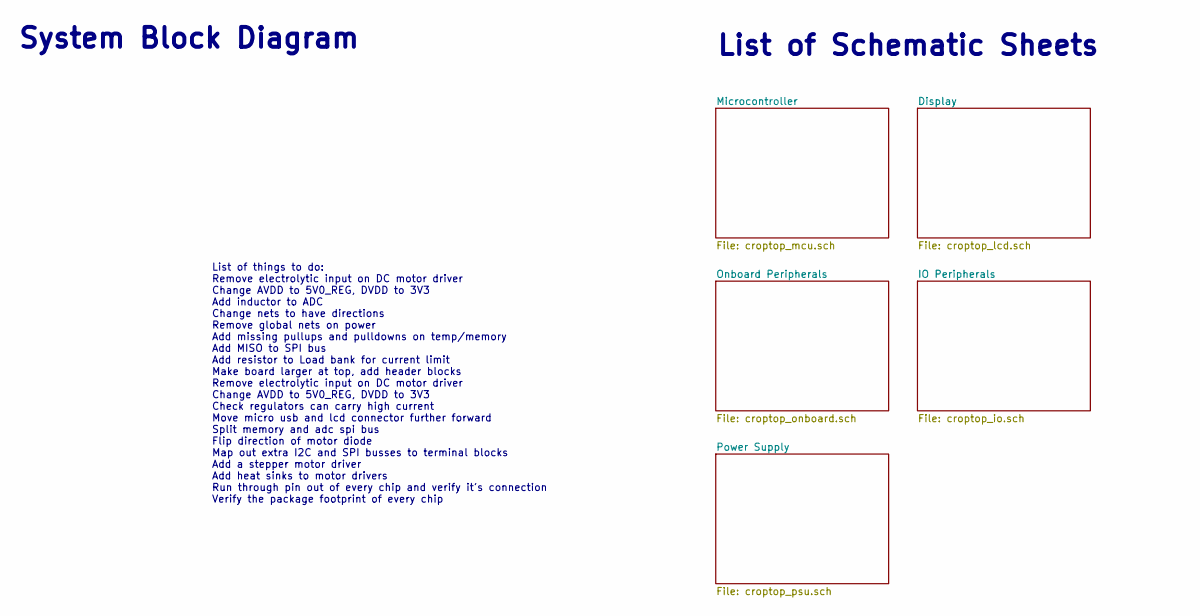
[picture p55: schematic croptop.sch]

Notes on the sheet:
List of Schematic Sheets
System Block Diagram
List of things to do: Remove electrolytic input on DC motor driver Change AVDD to 5V0_REG, DVDD to 3V3 Add inductor to ADC Change nets to have directions Remove global nets on power Add missing pullups and pulldowns on temp/memory Add MISO to SPI bus Add resistor to Load bank for current limit Make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

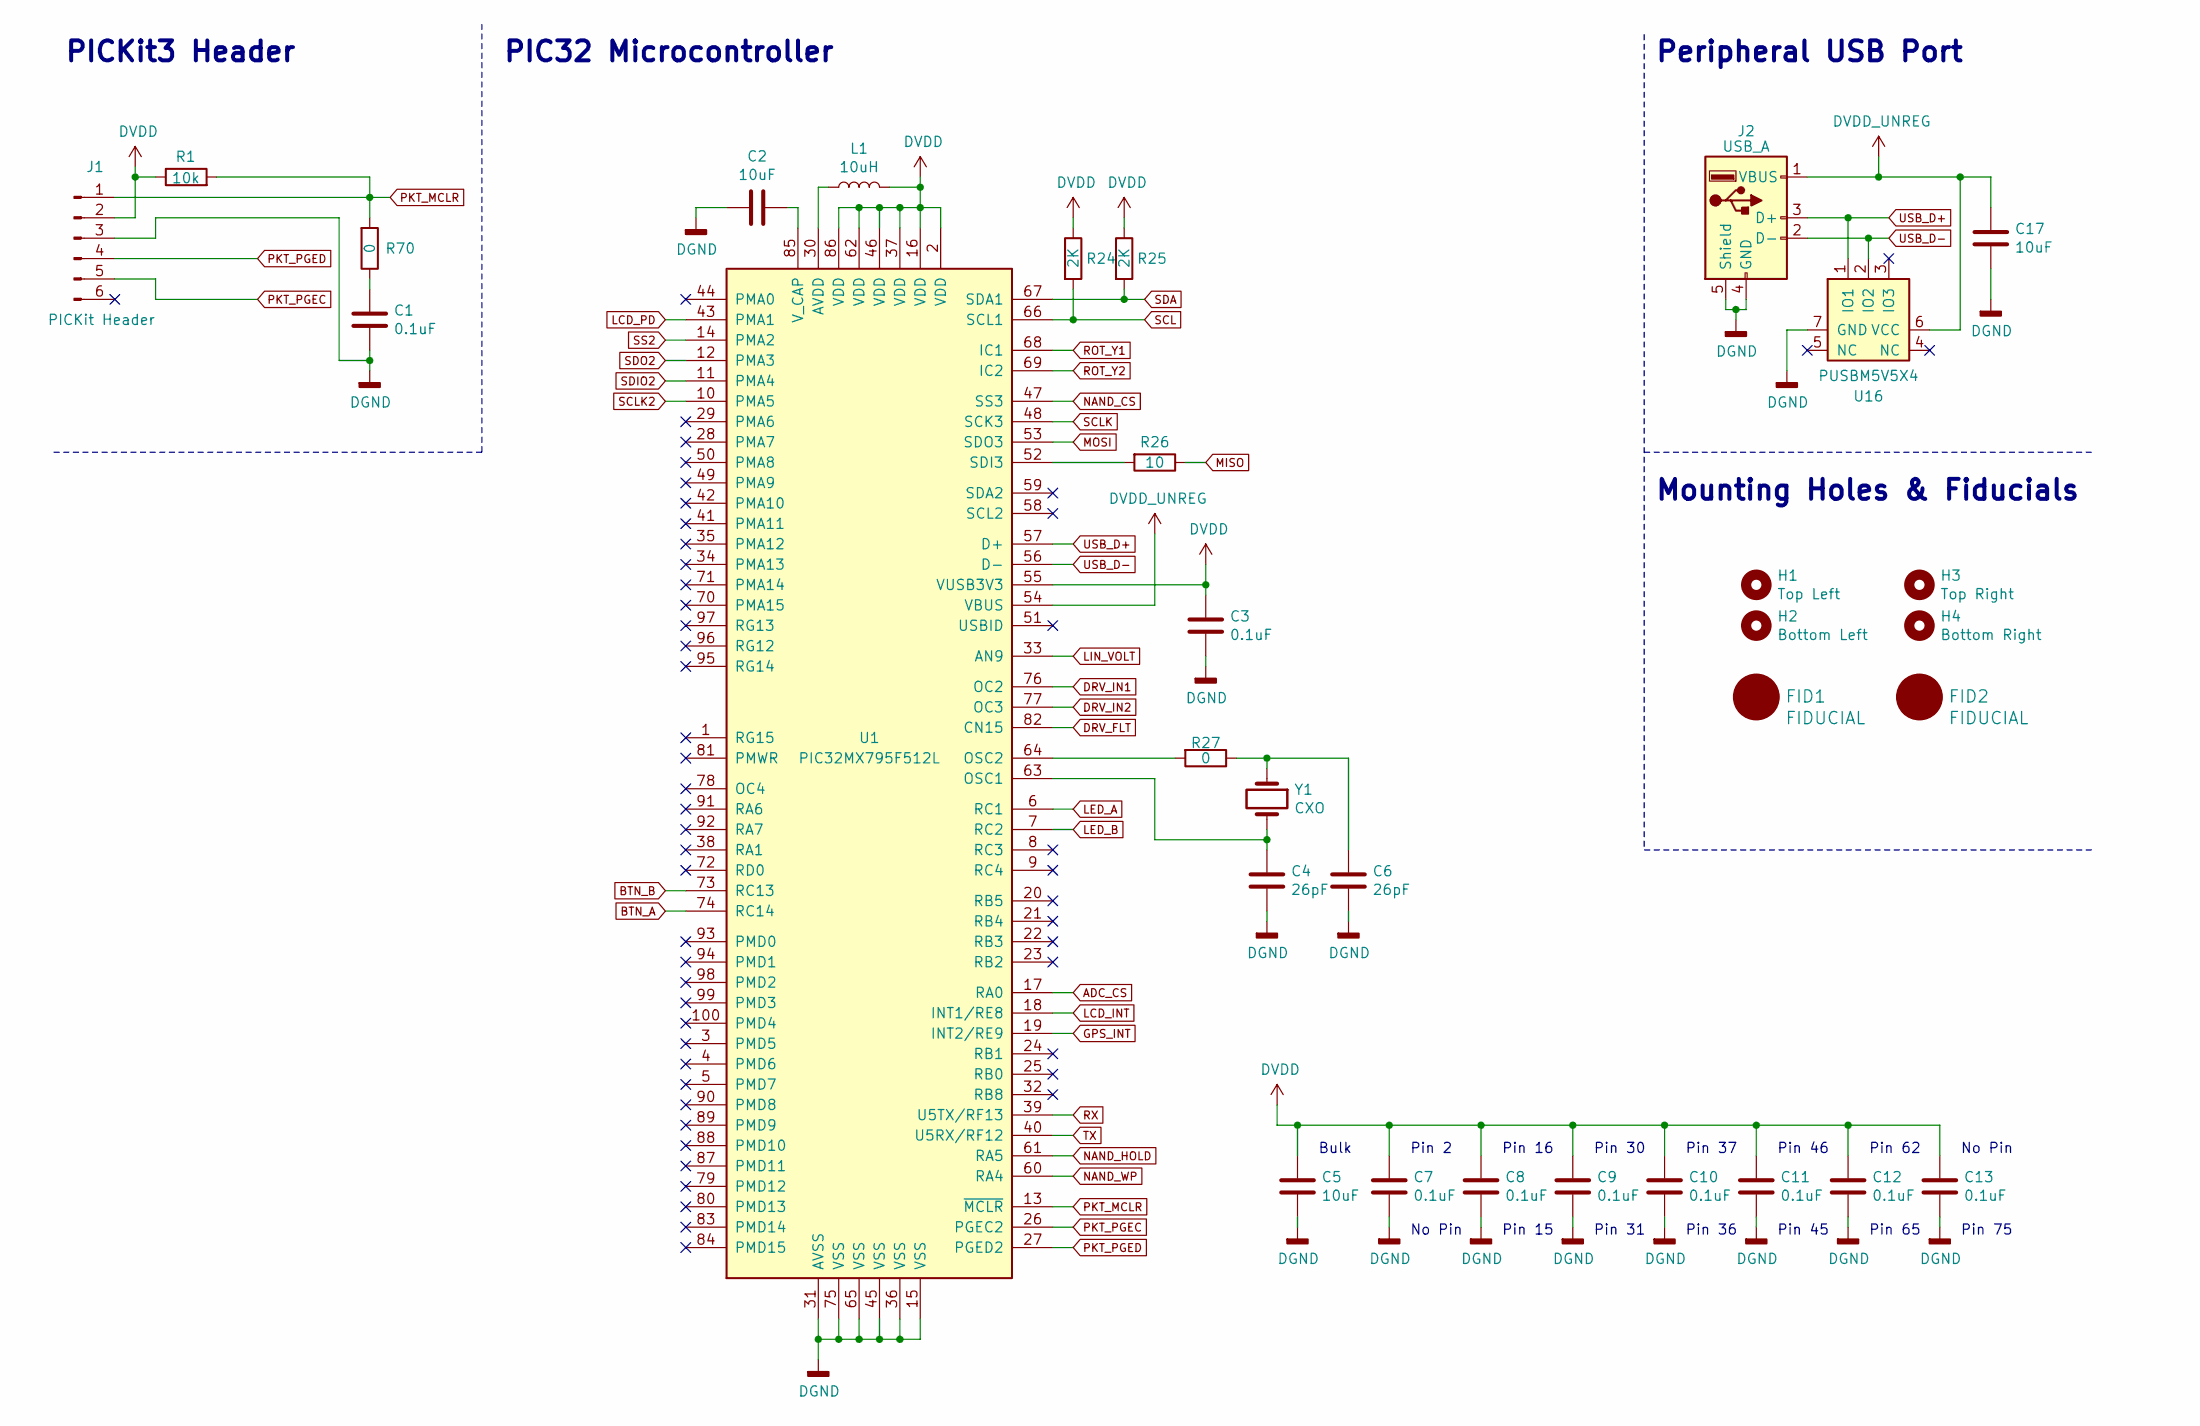
[picture p56: schematic croptop_mcu.sch, CropTop]

Parts:
C1, C3, C7, C8, C9, C10, C11, C12, C13: 0.1uF; C_0402_1005Metric
C2, C5, C17: 10uF; C_0805_2012Metric
C4, C6: 26pF; C_0402_1005Metric
FID1, FID2: FIDUCIAL; Fiducial_1mm_Dia_2.54mm_Outer_CopperTop
H1: Top Left; MountingHole_4mm_Pad
H2: Bottom Left; MountingHole_4mm_Pad
H3: Top Right; MountingHole_4mm_Pad
H4: Bottom Right; MountingHole_4mm_Pad
J1: PICKit Header; PinHeader_1x06_P2.54mm_Vertical
J2: USB_A; USB_A_Assmann_Horizontal
L1: 10uH; L_1210_3225Metric
R1: 10k; R_0402_1005Metric
R24, R25: 2K; R_0402_1005Metric
R26: 10; R_0402_1005Metric
R27, R70: 0; R_0402_1005Metric
U1: PIC32MX795F512L; TQFP-100_12x12mm_P0.4mm
U16: PUSBM5V5X4
Y1: CXO; ABLS_OX

Connections:
ADC_CS: U1.17 (RA0); also elsewhere on the board
BTN_A: U1.74 (RC14); also elsewhere on the board
BTN_B: U1.73 (RC13); also elsewhere on the board
DRV_FLT: U1.82 (CN15); also elsewhere on the board
DRV_GND: C1.2, C2.2, C3.2, C4.2, C5.2, C6.2, C7.2, C8.2, C9.2, C10.2, C11.2, C12.2, C13.2, C17.2, J1.3, J2.4 (GND), J2.5 (Shield), U1.15 (VSS), U1.31 (AVSS), U1.36 (VSS), U1.45 (VSS), U1.65 (VSS), U1.75 (VSS), U16.7 (GND); also elsewhere on the board
DRV_IN1: U1.76 (OC2); also elsewhere on the board
DRV_IN2: U1.77 (OC3); also elsewhere on the board
DVDD: C3.1, C5.1, C7.1, C8.1, C9.1, C10.1, C11.1, C12.1, C13.1, J1.2, L1.1, R1.1, R24.1, R25.1, U1.2 (VDD), U1.16 (VDD), U1.37 (VDD), U1.46 (VDD), U1.55 (VUSB3V3), U1.62 (VDD), U1.86 (VDD); also elsewhere on the board
DVDD_UNREG: C17.1, J2.1 (VBUS), U1.54 (VBUS), U16.6 (VCC); also elsewhere on the board
GPS_INT: U1.19 (INT2/RE9); also elsewhere on the board
LCD_INT: U1.18 (INT1/RE8); also elsewhere on the board
LCD_PD: U1.43 (PMA1); also elsewhere on the board
LED_A: U1.6 (RC1); also elsewhere on the board
LED_B: U1.7 (RC2); also elsewhere on the board
LIN_IN: U1.33 (AN9); also elsewhere on the board
MISO: R26.1; also elsewhere on the board
MOSI: U1.53 (SDO3); also elsewhere on the board
NAND_CS: U1.47 (SS3); also elsewhere on the board
NAND_HOLD: U1.61 (RA5); also elsewhere on the board
NAND_WP: U1.60 (RA4); also elsewhere on the board
unnamed: C1.1, R70.1
unnamed: C2.1, U1.85 (V_CAP)
unnamed: C4.1, U1.63 (OSC1), Y1.2
unnamed: C6.1, R27.1, Y1.1
unnamed: L1.2, U1.30 (AVDD)
unnamed: R26.2, U1.52 (SDI3)
unnamed: R27.2, U1.64 (OSC2)
PKT_MCLR: J1.1, R1.2, R70.2, U1.13 (~MCLR)
PKT_PGEC: J1.5, U1.26 (PGEC2)
PKT_PGED: J1.4, U1.27 (PGED2)
ROT_Y1: U1.68 (IC1); also elsewhere on the board
ROT_Y2: U1.69 (IC2); also elsewhere on the board
RX: U1.39 (U5TX/RF13); also elsewhere on the board
SCL: R24.2, U1.66 (SCL1); also elsewhere on the board
SCLK: U1.48 (SCK3); also elsewhere on the board
SCLK2: U1.10 (PMA5); also elsewhere on the board
SDA: R25.2, U1.67 (SDA1); also elsewhere on the board
SDIO2: U1.11 (PMA4); also elsewhere on the board
SDO2: U1.12 (PMA3); also elsewhere on the board
SS2: U1.14 (PMA2); also elsewhere on the board
TX: U1.40 (U5RX/RF12); also elsewhere on the board
USB_D+: J2.3 (D+), U1.57 (D+), U16.1 (IO1)
USB_D-: J2.2 (D-), U1.56 (D-), U16.2 (IO2)

Notes on the sheet:
Peripheral USB Port
PIC32 Microcontroller
PICKit3 Header
Pin 75
Pin 65
Pin 62
Pin 36
Pin 37
Pin 45
Pin 46
Pin 31
Pin 30
Pin 15
Pin 16
Pin 2
No Pin
Bulk
Mounting Holes & Fiducials

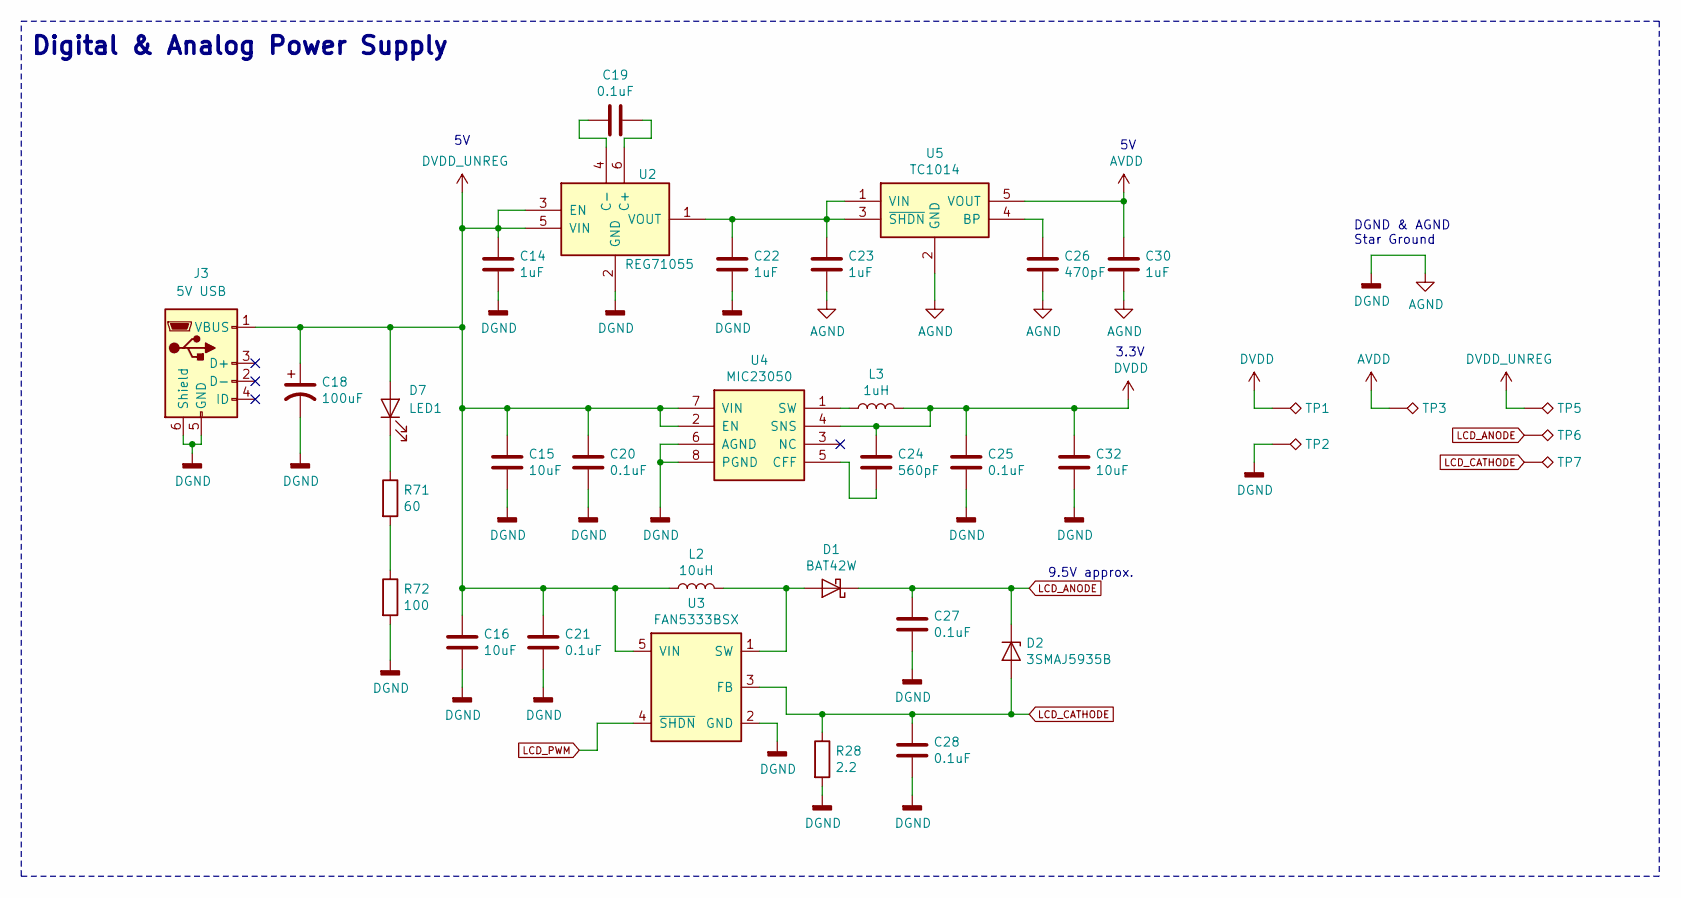
[picture p57: schematic croptop_psu.sch, CropTop]

Parts:
C14, C22, C23, C30: 1uF; C_0402_1005Metric
C15, C16, C32: 10uF; C_0805_2012Metric
C18: 100uF; CP_Elec_6.3x7.7
C19, C20, C21, C25, C28: 0.1uF; C_0402_1005Metric
C24: 560pF; C_0603_1608Metric
C26: 470pF; C_0402_1005Metric
C27: 0.1uF; C_0805_2012Metric
D1: BAT42W; D_SOD-123
D2: 3SMAJ5935B; DO-214AC
D7: LED1; LED_0805_2012Metric
J3: 5V USB; USB_Micro-B_Molex_47346-0001
L2: 10uH; L_1210_3225Metric
L3: 1uH; L_0805_2012Metric
R28: 2.2; R_0603_1608Metric
R71: 60; R_0402_1005Metric
R72: 100; R_0402_1005Metric
TP1, TP2, TP3, TP5, TP6, TP7: TestPoint_Alt; TestPoint
U2: REG71055; SOT-23-6
U3: FAN5333BSX; SOT-23-5
U4: MIC23050; DFN-8-1EP_2x2mm_P0.45mm_EP0.64x1.38mm
U5: TC1014; SOT-23-5

Connections:
ADC_VDD: C30.1, TP3.1, U5.5 (VOUT); also elsewhere on the board
DRV_GND: C14.2, C15.2, C16.2, C18.2, C20.2, C21.2, C22.2, C23.2, C25.2, C26.2, C27.2, C28.2, C30.2, C32.2, J3.5 (GND), J3.6 (Shield), R28.2, R72.2, TP2.1, U2.2 (GND), U3.2 (GND), U4.6 (AGND), U4.8 (PGND), U5.2 (GND); also elsewhere on the board
DVDD: C24.2, C25.1, C32.1, L3.1, TP1.1, U4.4 (SNS); also elsewhere on the board
DVDD_UNREG: C14.1, C15.1, C16.1, C18.1, C20.1, C21.1, D7.2 (A), J3.1 (VBUS), L2.2, TP5.1, U2.3 (EN), U2.5 (VIN), U3.5 (VIN), U4.2 (EN), U4.7 (VIN); also elsewhere on the board
LCD_ANODE: C27.1, D1.1 (K), D2.1 (K), TP6.1; also elsewhere on the board
LCD_CATHODE: C28.1, D2.2 (A), R28.1, TP7.1, U3.3 (FB); also elsewhere on the board
LCD_PWM: U3.4 (~SHDN); also elsewhere on the board
unnamed: C19.1, U2.6 (C+)
unnamed: C19.2, U2.4 (C-)
unnamed: C22.1, C23.1, U2.1 (VOUT), U5.1 (VIN), U5.3 (~SHDN)
unnamed: C24.1, U4.5 (CFF)
unnamed: C26.1, U5.4 (BP)
unnamed: D1.2 (A), L2.1, U3.1 (SW)
unnamed: D7.1 (K), R71.1
unnamed: L3.2, U4.1 (SW)
unnamed: R71.2, R72.1

Notes on the sheet:
Digital & Analog Power Supply
DGND & AGND Star Ground
3.3V
9.5V approx.

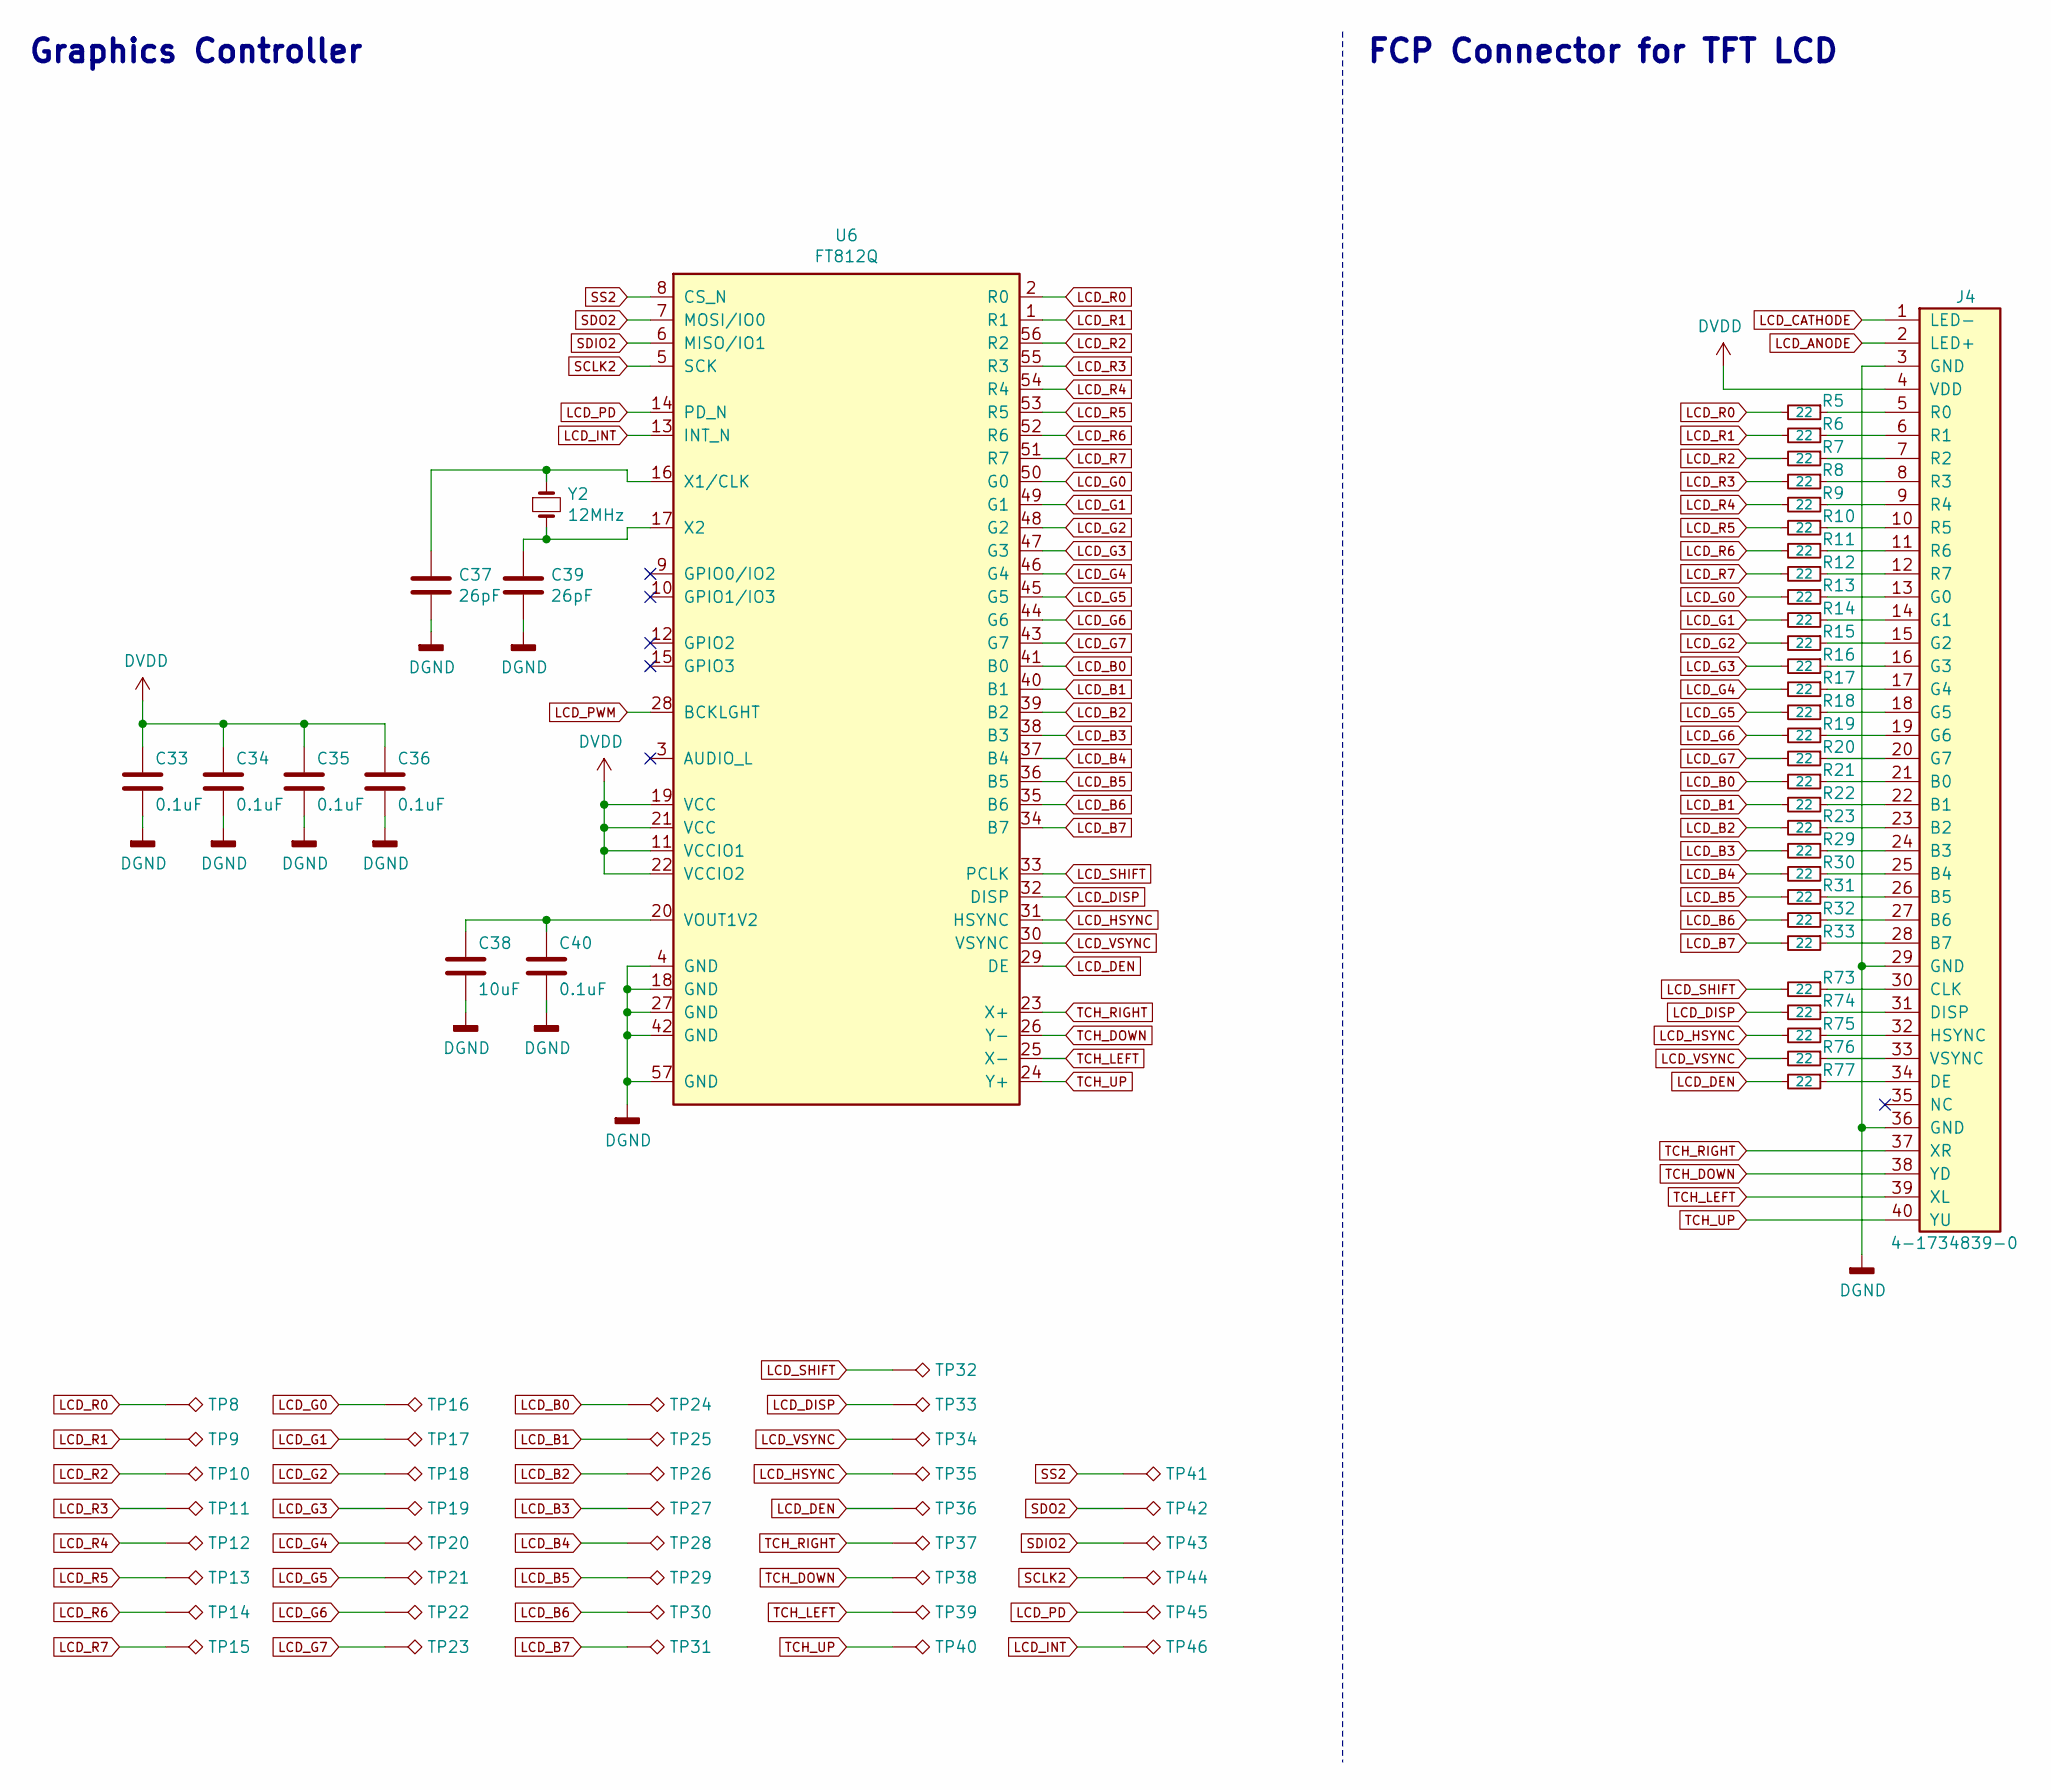
[picture p58: schematic croptop_lcd.sch, CropTop]

Parts:
C33, C34, C35, C36, C40: 0.1uF; C_0402_1005Metric
C37, C39: 26pF; C_0402_1005Metric
C38: 10uF; C_0805_2012Metric
J4: 4-1734839-0
R5, R6, R7, R8, R9, R10, R11, R12, R13, R14, R15, R16, R17, R18, R19, R20, R21, R22, R23, R29, R30, R31, R32, R33, R73, R74, R75, R76, R77: 22; R_0402_1005Metric
TP8, TP9, TP10, TP11, TP12, TP13, TP14, TP15, TP16, TP17, TP18, TP19, TP20, TP21, TP22, TP23, TP24, TP25, TP26, TP27, TP28, TP29, TP30, TP31, TP32, TP33, TP34, TP35, TP36, TP37, TP38, TP39, TP40, TP41, TP42, TP43, TP44, TP45, TP46: TestPoint_Alt; TestPoint
U6: FT812Q; QFN-56-1EP_8x8mm_P0.5mm_EP4.5x5.2mm
Y2: 12MHz; ABLS_OX

Connections:
DRV_GND: C33.2, C34.2, C35.2, C36.2, C37.2, C38.2, C39.2, C40.2, J4.3 (GND), J4.29 (GND), J4.36 (GND), U6.4 (GND), U6.18 (GND), U6.27 (GND), U6.42 (GND), U6.57 (GND); also elsewhere on the board
DVDD: C33.1, C34.1, C35.1, C36.1, J4.4 (VDD), U6.11 (VCCIO1), U6.19 (VCC), U6.21 (VCC), U6.22 (VCCIO2); also elsewhere on the board
LCD_ANODE: J4.2 (LED+); also elsewhere on the board
LCD_B0: R21.2, TP24.1, U6.41 (B0)
LCD_B1: R22.2, TP25.1, U6.40 (B1)
LCD_B2: R23.2, TP26.1, U6.39 (B2)
LCD_B3: R29.2, TP27.1, U6.38 (B3)
LCD_B4: R30.2, TP28.1, U6.37 (B4)
LCD_B5: R31.2, TP29.1, U6.36 (B5)
LCD_B6: R32.2, TP30.1, U6.35 (B6)
LCD_B7: R33.2, TP31.1, U6.34 (B7)
LCD_CATHODE: J4.1 (LED-); also elsewhere on the board
LCD_DEN: R77.2, TP36.1, U6.29 (DE)
LCD_DISP: R74.2, TP33.1, U6.32 (DISP)
LCD_G0: R13.2, TP16.1, U6.50 (G0)
LCD_G1: R14.2, TP17.1, U6.49 (G1)
LCD_G2: R15.2, TP18.1, U6.48 (G2)
LCD_G3: R16.2, TP19.1, U6.47 (G3)
LCD_G4: R17.2, TP20.1, U6.46 (G4)
LCD_G5: R18.2, TP21.1, U6.45 (G5)
LCD_G6: R19.2, TP22.1, U6.44 (G6)
LCD_G7: R20.2, TP23.1, U6.43 (G7)
LCD_HSYNC: R75.2, TP35.1, U6.31 (HSYNC)
LCD_INT: TP46.1, U6.13 (INT_N); also elsewhere on the board
LCD_PD: TP45.1, U6.14 (PD_N); also elsewhere on the board
LCD_PWM: U6.28 (BCKLGHT); also elsewhere on the board
LCD_R0: R5.2, TP8.1, U6.2 (R0)
LCD_R1: R6.2, TP9.1, U6.1 (R1)
LCD_R2: R7.2, TP10.1, U6.56 (R2)
LCD_R3: R8.2, TP11.1, U6.55 (R3)
LCD_R4: R9.2, TP12.1, U6.54 (R4)
LCD_R5: R10.2, TP13.1, U6.53 (R5)
LCD_R6: R11.2, TP14.1, U6.52 (R6)
LCD_R7: R12.2, TP15.1, U6.51 (R7)
LCD_SHIFT: R73.2, TP32.1, U6.33 (PCLK)
LCD_VSYNC: R76.2, TP34.1, U6.30 (VSYNC)
unnamed: C37.1, U6.16 (X1/CLK), Y2.1
unnamed: C38.1, C40.1, U6.20 (VOUT1V2)
unnamed: C39.1, U6.17 (X2), Y2.2
unnamed: J4.5 (R0), R5.1
unnamed: J4.6 (R1), R6.1
unnamed: J4.7 (R2), R7.1
unnamed: J4.8 (R3), R8.1
unnamed: J4.9 (R4), R9.1
unnamed: J4.10 (R5), R10.1
unnamed: J4.11 (R6), R11.1
unnamed: J4.12 (R7), R12.1
unnamed: J4.13 (G0), R13.1
unnamed: J4.14 (G1), R14.1
unnamed: J4.15 (G2), R15.1
unnamed: J4.16 (G3), R16.1
unnamed: J4.17 (G4), R17.1
unnamed: J4.18 (G5), R18.1
unnamed: J4.19 (G6), R19.1
unnamed: J4.20 (G7), R20.1
unnamed: J4.21 (B0), R21.1
unnamed: J4.22 (B1), R22.1
unnamed: J4.23 (B2), R23.1
unnamed: J4.24 (B3), R29.1
unnamed: J4.25 (B4), R30.1
unnamed: J4.26 (B5), R31.1
unnamed: J4.27 (B6), R32.1
unnamed: J4.28 (B7), R33.1
unnamed: J4.30 (CLK), R73.1
unnamed: J4.31 (DISP), R74.1
unnamed: J4.32 (HSYNC), R75.1
unnamed: J4.33 (VSYNC), R76.1
unnamed: J4.34 (DE), R77.1
SCLK2: TP44.1, U6.5 (SCK); also elsewhere on the board
SDIO2: TP43.1, U6.6 (MISO/IO1); also elsewhere on the board
SDO2: TP42.1, U6.7 (MOSI/IO0); also elsewhere on the board
SS2: TP41.1, U6.8 (CS_N); also elsewhere on the board
TCH_DOWN: J4.38 (YD), TP38.1, U6.26 (Y-)
TCH_LEFT: J4.39 (XL), TP39.1, U6.25 (X-)
TCH_RIGHT: J4.37 (XR), TP37.1, U6.23 (X+)
TCH_UP: J4.40 (YU), TP40.1, U6.24 (Y+)

Notes on the sheet:
FCP Connector for TFT LCD
Graphics Controller

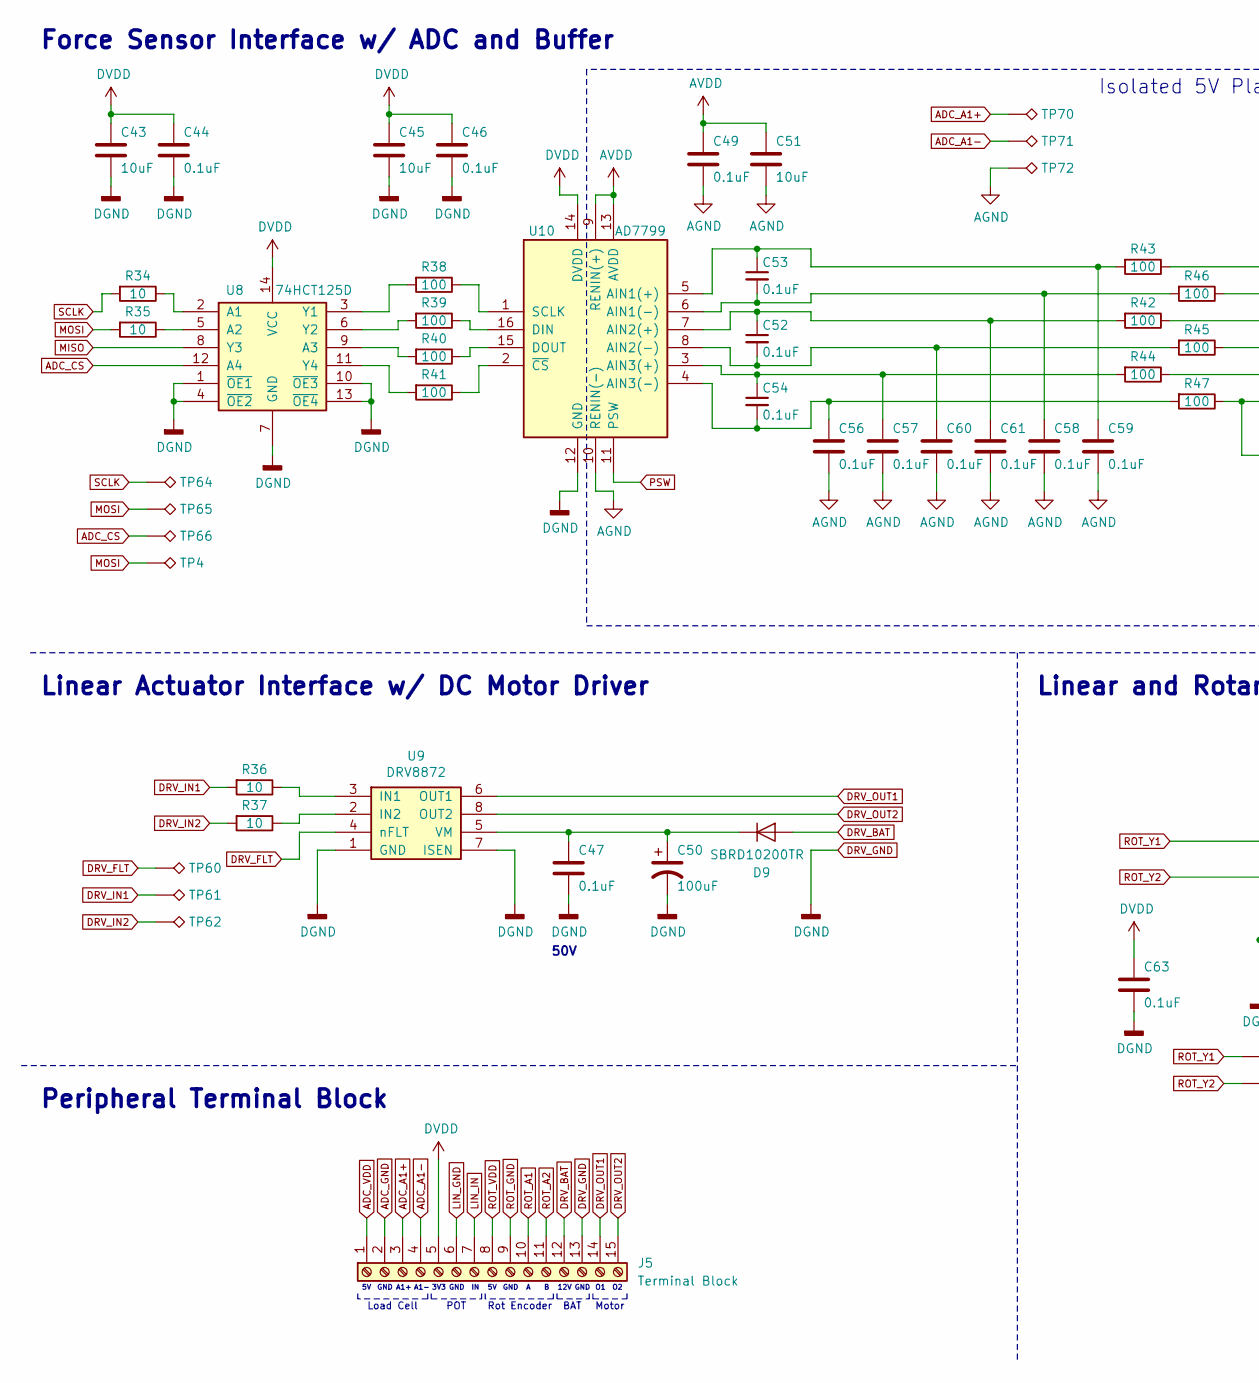
[picture p59: schematic croptop_io.sch, CropTop, part in row 1, column 1]

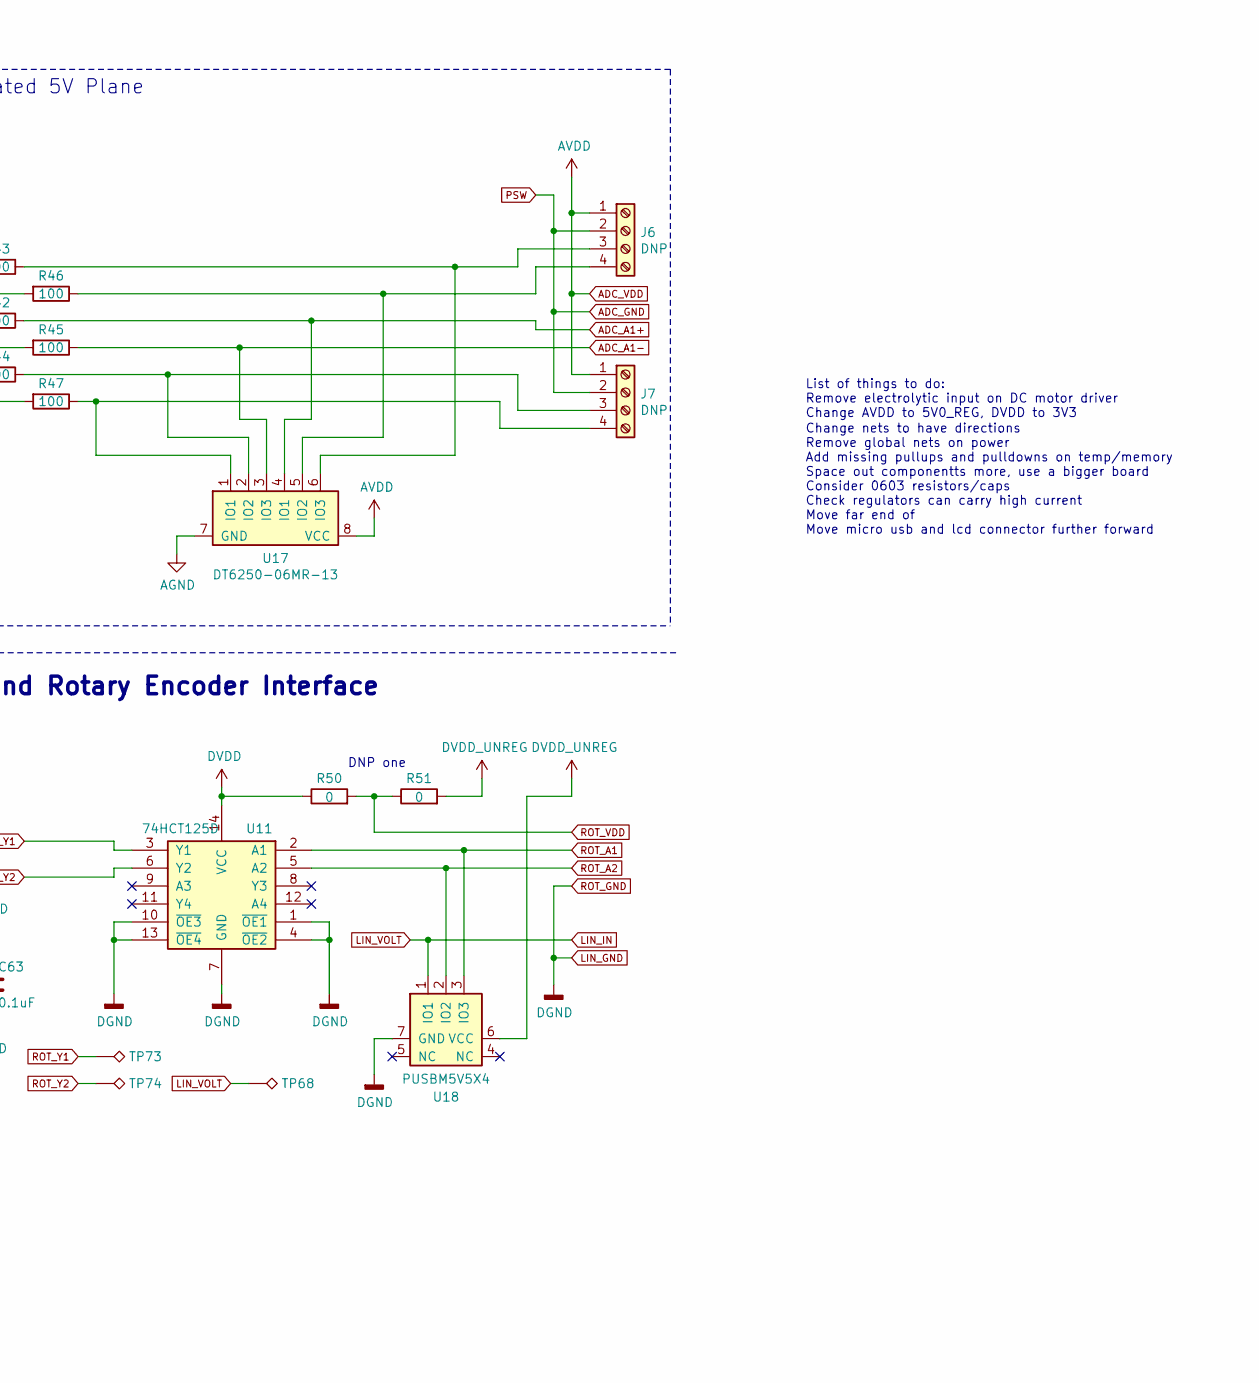
[picture p60: schematic croptop_io.sch, CropTop, part in row 1, column 2]

Parts:
C43, C45, C51: 10uF; C_0805_2012Metric
C44, C46, C49, C52, C53, C54, C56, C57, C58, C59, C60, C61, C63: 0.1uF; C_0402_1005Metric
C47: 0.1uF; C_0805_2012Metric
C50: 100uF; CP_Elec_6.3x7.7
D9: SBRD10200TR; SizeOfThisLad
J5: Terminal Block; TerminalBlock_4Ucon_1x15_P3.50mm_Horizontal
J6, J7: DNP; PinHeader_1x04_P2.54mm_Vertical
R34, R35, R36, R37: 10; R_0402_1005Metric
R38, R39, R40, R41, R42, R43, R44, R45, R46, R47: 100; R_0402_1005Metric
R50, R51: 0; R_0402_1005Metric
TP4, TP60, TP61, TP62, TP64, TP65, TP66, TP68, TP70, TP71, TP72, TP73, TP74: TestPoint_Alt; TestPoint
U8, U11: 74HCT125D; SOIC-14_3.9x8.7mm_P1.27mm
U9: DRV8872; 8-PowerSOIC
U10: AD7799; TSSOP-16_4.4x5mm_P0.65mm
U17: DT6250-06MR-13; MSOP-8_3x3mm_P0.65mm
U18: PUSBM5V5X4

Connections:
ADC_A1+: J5.3, R42.1, TP70.1, U17.4 (IO1)
ADC_A1-: J5.4, R45.1, TP71.1, U17.3 (IO3)
ADC_CS: TP66.1, U8.12 (A4); also elsewhere on the board
ADC_GND: J5.2, J6.2, J7.2, U10.11 (PSW)
ADC_VDD: C49.1, C51.1, J5.1, J6.1, J7.1, U10.9 (RENIN(+)), U10.13 (AVDD), U17.8 (VCC); also elsewhere on the board
DRV_BAT: D9.2 (A), J5.12
DRV_FLT: TP60.1, U9.4 (nFLT); also elsewhere on the board
DRV_GND: C43.2, C44.2, C45.2, C46.2, C47.2, C49.2, C50.2, C51.2, C56.1, C57.1, C58.1, C59.1, C60.1, C61.1, C63.2, J5.6, J5.9, J5.13, TP72.1, U8.1 (~OE1), U8.4 (~OE2), U8.7 (GND), U8.10 (~OE3), U8.13 (~OE4), U9.1 (GND), U9.7 (ISEN), U10.10 (RENIN(-)), U10.12 (GND), U11.1 (~OE1), U11.4 (~OE2), U11.7 (GND), U11.10 (~OE3), U11.13 (~OE4), U17.7 (GND), U18.7 (GND); also elsewhere on the board
DRV_IN1: R36.2, TP61.1; also elsewhere on the board
DRV_IN2: R37.2, TP62.1; also elsewhere on the board
DRV_OUT1: J5.14, U9.6 (OUT1)
DRV_OUT2: J5.15, U9.8 (OUT2)
DVDD: C43.1, C44.1, C45.1, C46.1, C63.1, J5.5, R50.1, U8.14 (VCC), U10.14 (DVDD), U11.14 (VCC); also elsewhere on the board
DVDD_UNREG: R51.2, U18.6 (VCC); also elsewhere on the board
LIN_IN: J5.7, TP68.1, U18.1 (IO1); also elsewhere on the board
MISO: U8.8 (Y3); also elsewhere on the board
MOSI: R35.2, TP4.1, TP65.1; also elsewhere on the board
unnamed: C47.1, C50.1, D9.1 (K), U9.5 (VM)
unnamed: C52.1, C61.2, R42.2, U10.7 (AIN2(+))
unnamed: C52.2, C60.2, R45.2, U10.8 (AIN2(-))
unnamed: C53.1, C59.2, R43.2, U10.5 (AIN1(+))
unnamed: C53.2, C58.2, R46.2, U10.6 (AIN1(-))
unnamed: C54.1, C57.2, R44.2, U10.3 (AIN3(+))
unnamed: C54.2, C56.2, R47.2, U10.4 (AIN3(-))
unnamed: J6.3, R43.1, U17.6 (IO3)
unnamed: J6.4, R46.1, U17.5 (IO2)
unnamed: J7.3, R44.1, U17.2 (IO2)
unnamed: J7.4, R47.1, U17.1 (IO1)
unnamed: R34.1, U8.2 (A1)
unnamed: R35.1, U8.5 (A2)
unnamed: R36.1, U9.3 (IN1)
unnamed: R37.1, U9.2 (IN2)
unnamed: R38.1, U10.1 (SCLK)
unnamed: R38.2, U8.3 (Y1)
unnamed: R39.1, U10.16 (DIN)
unnamed: R39.2, U8.6 (Y2)
unnamed: R40.1, U10.15 (DOUT)
unnamed: R40.2, U8.9 (A3)
unnamed: R41.1, U10.2 (~CS)
unnamed: R41.2, U8.11 (Y4)
ROT_A1: J5.10, U11.2 (A1), U18.3 (IO3)
ROT_A2: J5.11, U11.5 (A2), U18.2 (IO2)
ROT_VDD: J5.8, R50.2, R51.1
ROT_Y1: TP73.1, U11.3 (Y1); also elsewhere on the board
ROT_Y2: TP74.1, U11.6 (Y2); also elsewhere on the board
SCLK: R34.2, TP64.1; also elsewhere on the board

Notes on the sheet:
Linear and Rotary Encoder Interface
Force Sensor Interface w/ ADC and Buffer
Linear Actuator Interface w/ DC Motor Driver
DNP one
GND
A1+
A1-
3V3
12V
Load Cell
POT
Rot Encoder
BAT
Motor
Peripheral Terminal Block
Isolated 5V Plane
50V
List of things to do: Remove electrolytic input on DC motor driver Change AVDD to 5V0_REG, DVDD to 3V3
Change nets to have directions Remove global nets on power Add missing pullups and pulldowns on temp/memory Space out componentts more, use a bigger board Consider 0603 resistors/caps Check regulators can carry high current Move far end of Move micro usb and lcd connector further forward
