CollinHeist/CropTop/PCB v1.0/croptop.kicad_pcb

## KiCad design PCB v1.0/croptop.kicad_pcb (continued)

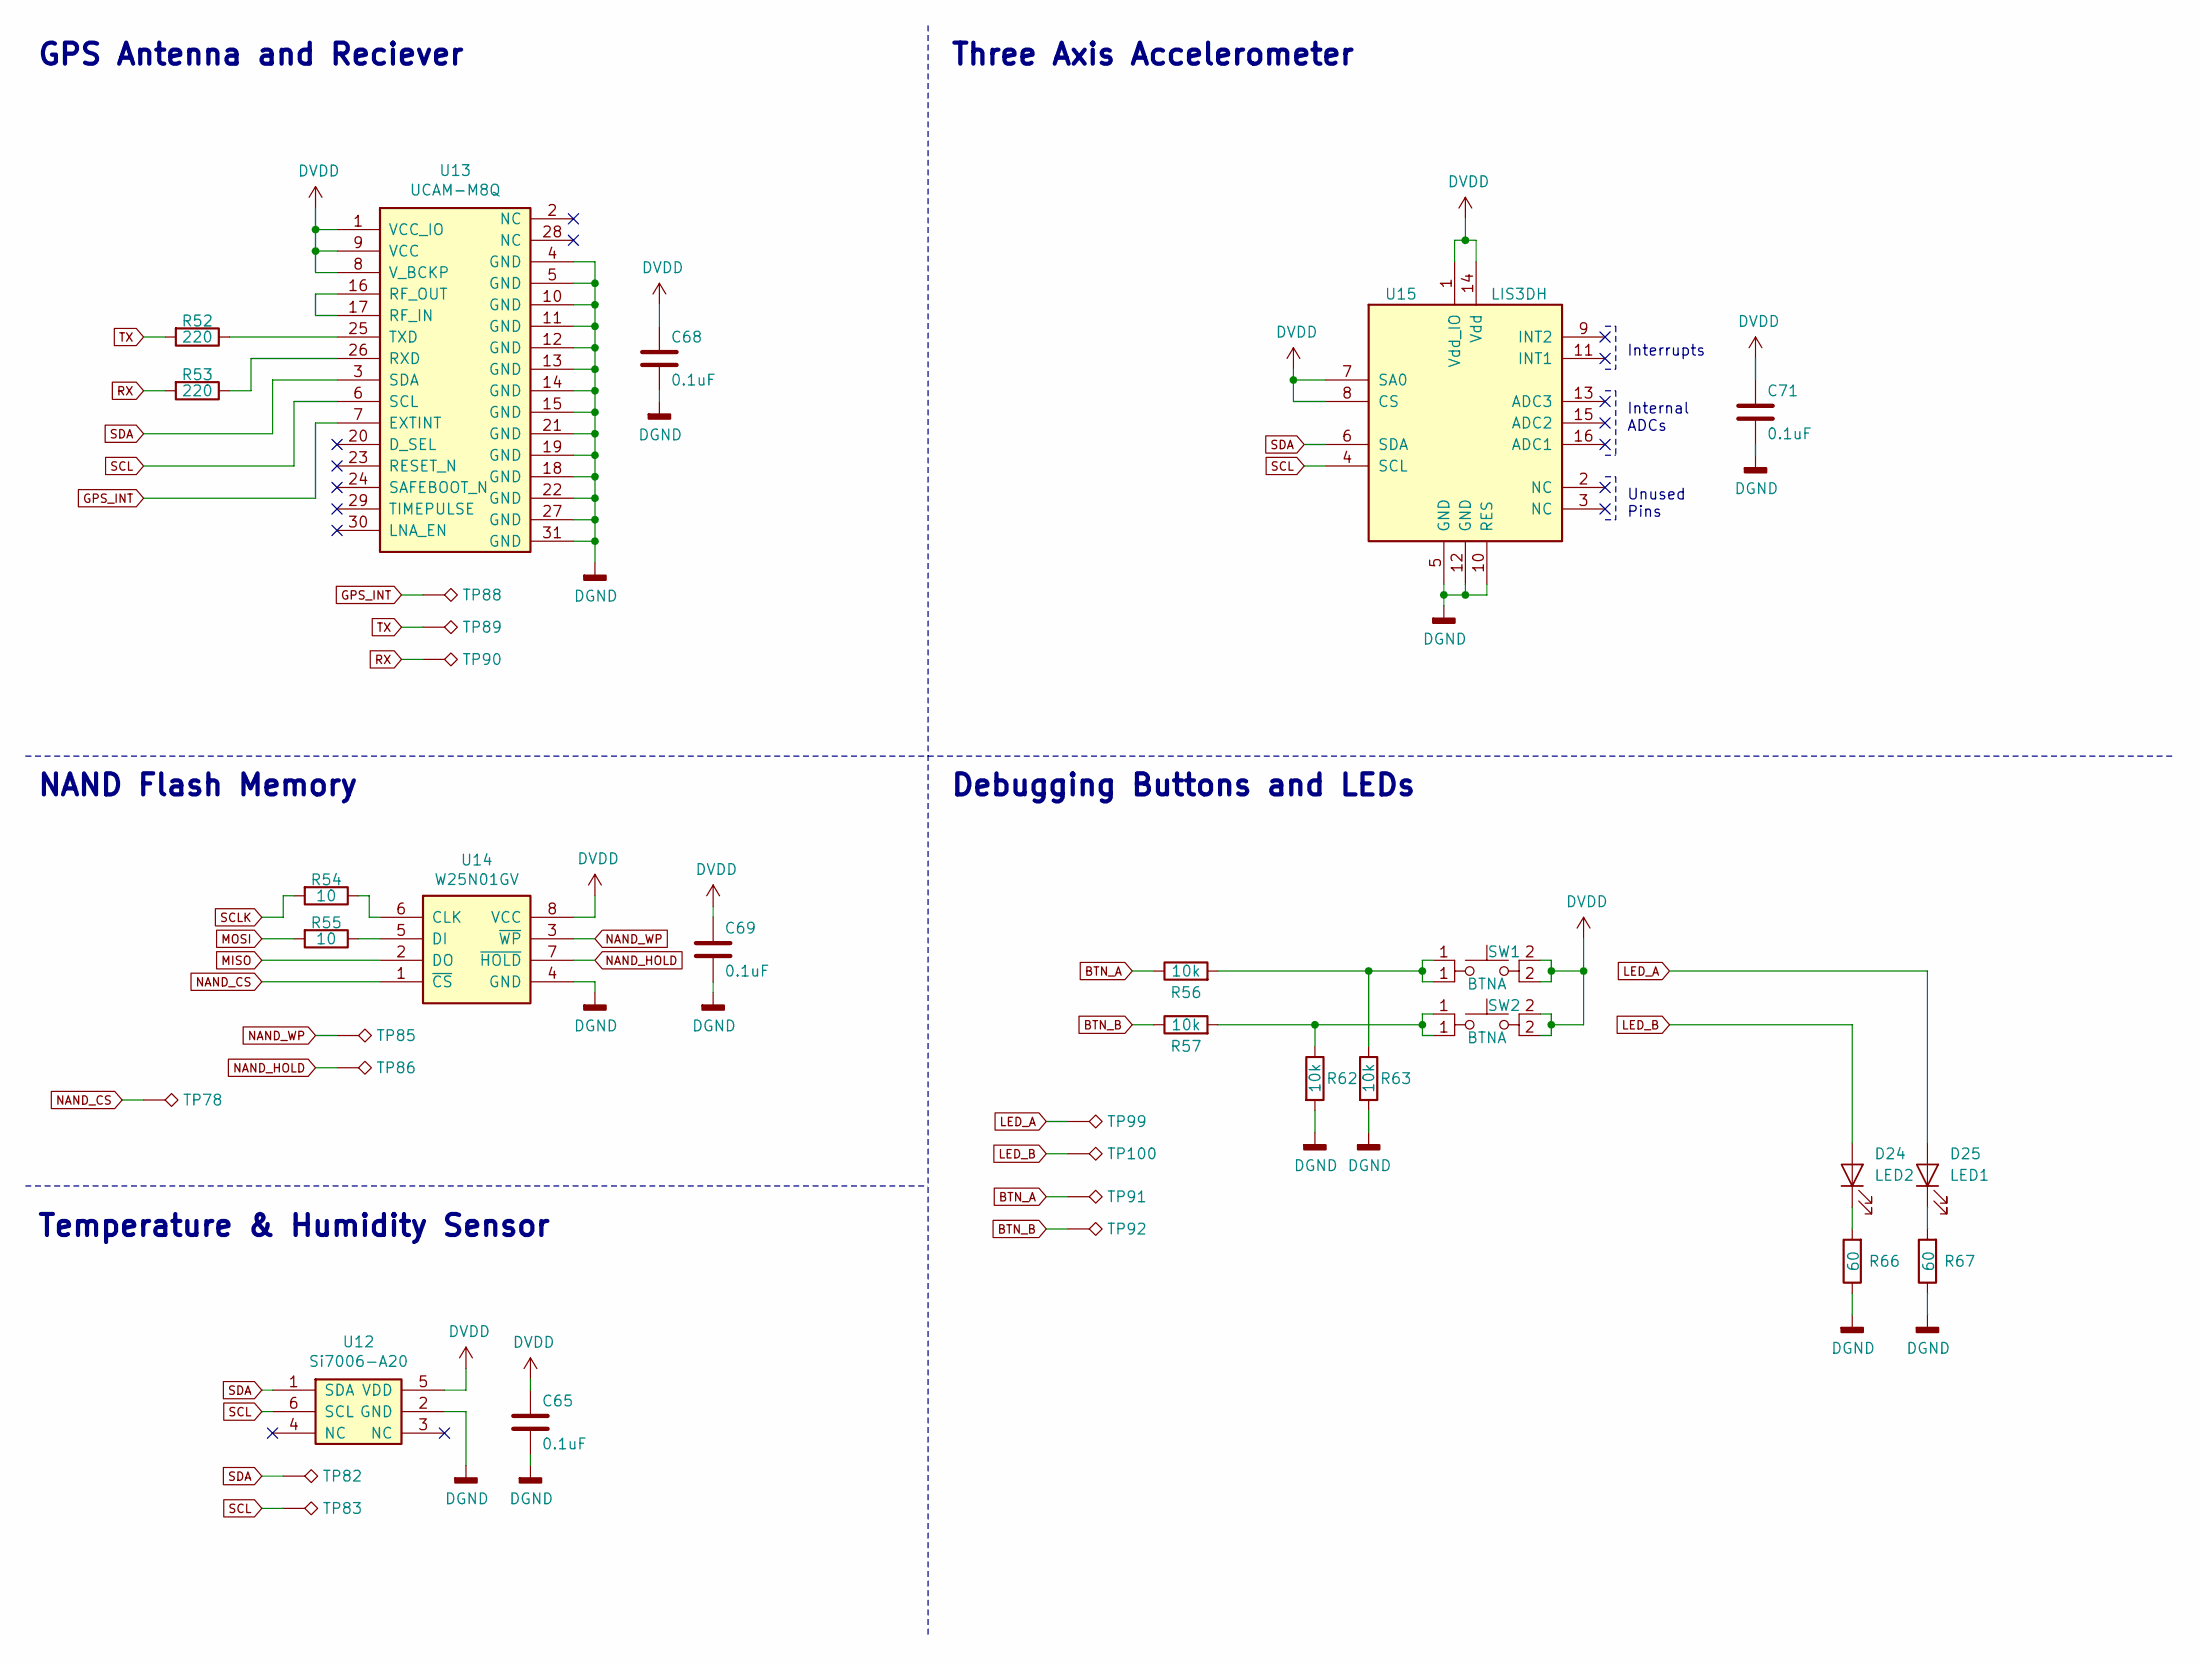
[picture p61: schematic croptop_onboard.sch, CropTop]

Parts:
C65, C68, C69, C71: 0.1uF; C_0402_1005Metric
D24: LED2; LED_0805_2012Metric
D25: LED1; LED_0805_2012Metric
R52, R53: 220; R_0402_1005Metric
R54, R55: 10; R_0402_1005Metric
R56, R57, R62, R63: 10k; R_0402_1005Metric
R66, R67: 60; R_0402_1005Metric
SW1, SW2: BTNA; SW_SPST_PTS645
TP78, TP82, TP83, TP85, TP86, TP88, TP89, TP90, TP91, TP92, TP99, TP100: TestPoint_Alt; TestPoint
U12: Si7006-A20; SI7006
U13: UCAM-M8Q; GPS
U14: W25N01GV
U15: LIS3DH; LGA-16_3x3mm_P0.5mm_LayoutBorder3x5y

Connections:
BTN_A: R56.1, TP91.1; also elsewhere on the board
BTN_B: R57.1, TP92.1; also elsewhere on the board
DRV_GND: C65.2, C68.2, C69.2, C71.2, R62.2, R63.2, R66.1, R67.1, U12.2 (GND), U13.4 (GND), U13.5 (GND), U13.10 (GND), U13.11 (GND), U13.12 (GND), U13.13 (GND), U13.14 (GND), U13.15 (GND), U13.18 (GND), U13.19 (GND), U13.21 (GND), U13.22 (GND), U13.27 (GND), U13.31 (GND), U14.4 (GND), U15.5 (GND), U15.10 (RES), U15.12 (GND); also elsewhere on the board
DVDD: C65.1, C68.1, C69.1, C71.1, SW1.2, SW2.2, U12.5 (VDD), U13.1 (VCC_IO), U13.8 (V_BCKP), U13.9 (VCC), U14.8 (VCC), U15.1 (Vdd_IO), U15.7 (SA0), U15.8 (CS), U15.14 (Vdd); also elsewhere on the board
GPS_INT: TP88.1, U13.7 (EXTINT); also elsewhere on the board
LED_A: D25.2 (A), TP99.1; also elsewhere on the board
LED_B: D24.2 (A), TP100.1; also elsewhere on the board
MISO: U14.2 (DO); also elsewhere on the board
MOSI: R55.2; also elsewhere on the board
NAND_CS: TP78.1, U14.1 (~CS); also elsewhere on the board
NAND_HOLD: TP86.1, U14.7 (~HOLD); also elsewhere on the board
NAND_WP: TP85.1, U14.3 (~WP); also elsewhere on the board
unnamed: D24.1 (K), R66.2
unnamed: D25.1 (K), R67.2
unnamed: R52.1, U13.25 (TXD)
unnamed: R53.1, U13.26 (RXD)
unnamed: R54.1, U14.6 (CLK)
unnamed: R55.1, U14.5 (DI)
unnamed: R56.2, R63.1, SW1.1
unnamed: R57.2, R62.1, SW2.1
unnamed: U13.16 (RF_OUT), U13.17 (RF_IN)
RX: R53.2, TP90.1; also elsewhere on the board
SCL: TP83.1, U12.6 (SCL), U13.6 (SCL), U15.4 (SCL); also elsewhere on the board
SCLK: R54.2; also elsewhere on the board
SDA: TP82.1, U12.1 (SDA), U13.3 (SDA), U15.6 (SDA); also elsewhere on the board
TX: R52.2, TP89.1; also elsewhere on the board

Notes on the sheet:
Internal ADCs
Unused Pins
Interrupts
Three Axis Accelerometer
GPS Antenna and Reciever
NAND Flash Memory
Temperature & Humidity Sensor
Debugging Buttons and LEDs

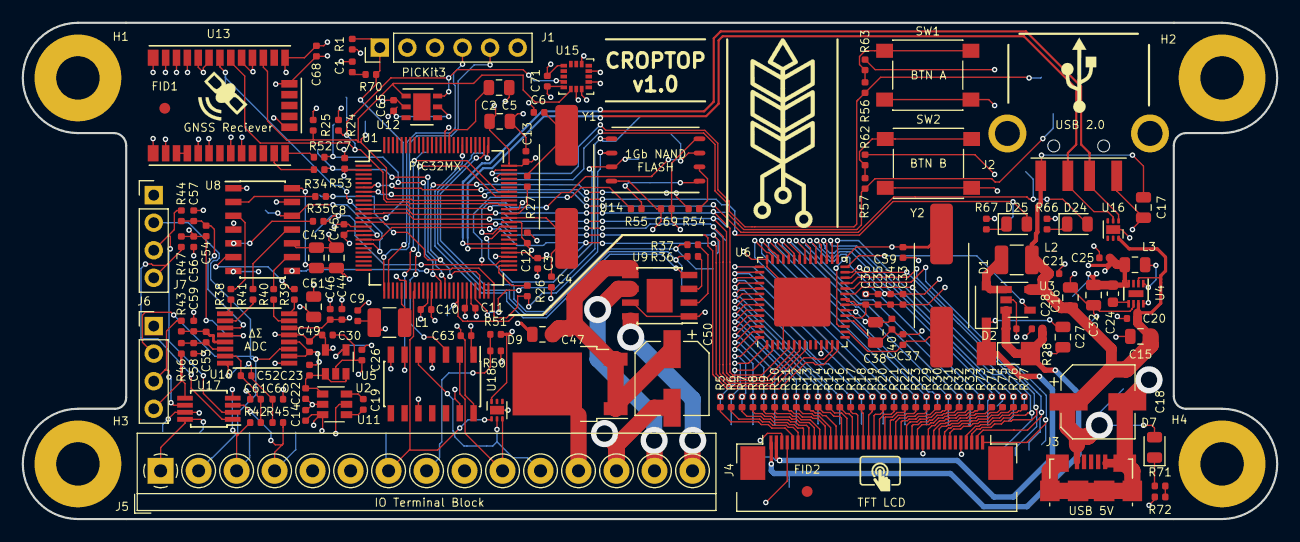
[picture p62: board PCB v1.0/croptop.kicad_pcb from above]

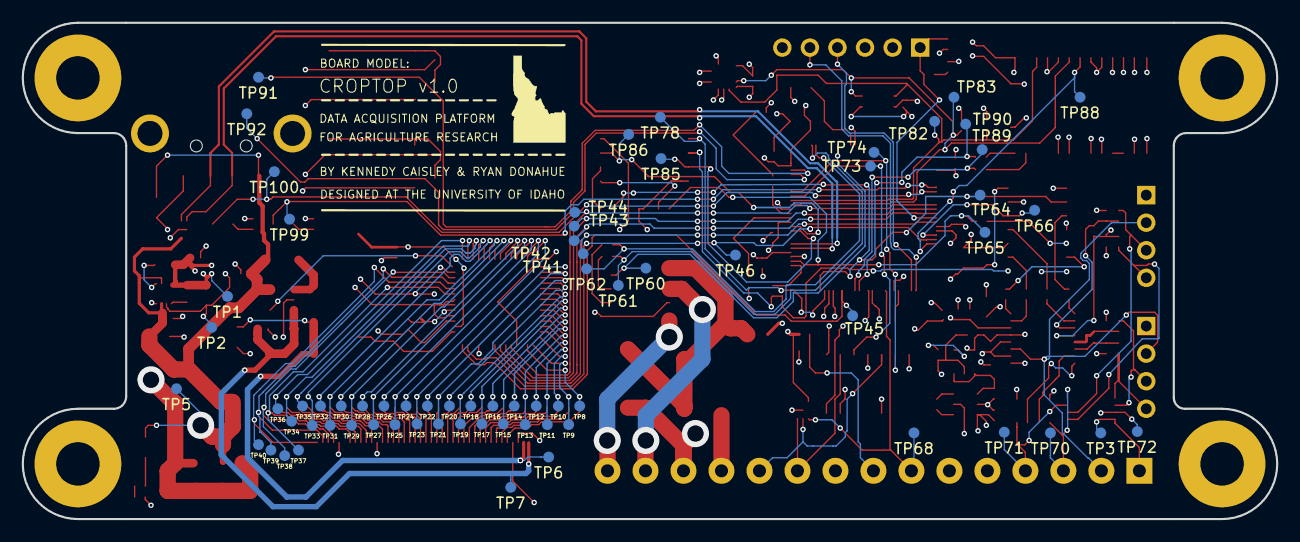
[picture p63: board PCB v1.0/croptop.kicad_pcb from below]

Board: 4 copper layers, 115.6 x 45.7 mm, 236 parts (69 on the bottom side), 162 nets.
