CollinHeist/CropTop/Software/project_starting_point/main.c

/**
 *	File
 *		main.c
 *	Summary
 *		Main program source file. Implements main operational loop.
 *	Author(s)
 *		Collin Heist, Ryan Donahue
 */

/* ----------------------------------- File Inclusion ----------------------------------- */

#include "config_bits.h"	// Do only once
#include <plib.h>
#include <stdio.h>
#include <string.h>

#include "hardware.h"
#include "main.h"
#include "motors.h"
#include "potentiometer.h"
#include "I2CLib.h"
#include "temp_humidity.h"
#include "accelerometer.h"
#include "GPS.h"
#include "screen.h"

/* -------------------------- Global Variables and Structures --------------------------- */

/* ---------------------------------- Public Functions ---------------------------------- */

/*
 *	Summary
 *		Main foreground program loop. The processing in this should be kept to a minimal.
 *	Parameters
 *		None.
 *	Returns
 *		This should never return - if it does, you've done goofed.
 */
int main() {
	if (initialize_system() == ERROR)
		Nop(); //return 0;		// An error occurred while running
	
	
	while (1) {
		parse_screen_response();
	}
	
	return 1;
}

/* --------------------------------- Private Functions ---------------------------------- */

/*
 *	Summary
 *		Private function to initialize all subsystems for the main program.
 *	Parameters
 *		None.
 *	Returns
 *		Unsigned integer that is ERROR or NO_ERROR if initialization was successful.
 */
static unsigned int initialize_system(void) {
	rtccTime start_time;	rtccDate start_date;

	// Initialize primary shared hardware
	unsigned int error_flag = NO_ERROR;
	error_flag |= initialize_shared_hardware();

	// Initialize subsystems	   
	start_time.l = DEFAULT_STARTUP_TIME;
	start_date.l = DEFAULT_STARTUP_DATE;
	error_flag |= initialize_RTC(start_time, start_date);
	error_flag |= initialize_test_operations();
	error_flag |= initialize_potentiometer(POTENTIOMETER_SAMPLE_FREQ_HZ);
	error_flag |= initialize_motors();
	error_flag |= initialize_i2c(I2C1_GNSS_FREQ_HZ);
//	error_flag |= initialize_accelerometer();
	error_flag |= initialize_screen(SCREEN_UART_BAUD);

	INTEnableSystemMultiVectoredInt();

	return error_flag;
}

/* ----------------------------- Interrupt Service Routines ----------------------------- */
