CollinHeist/CropTop/Software/project_starting_point/I2CLib.c

/**
 *	File
 *		I2CLib.c
 *	Summary
 *		I2C library source file. Implements functionality for initializing, reading to, and
 *		writing from I2C1.
 *	Author(s)
 *		Collin Heist, Ryan Donahue.
 */

/* ----------------------------------- File Inclusion ----------------------------------- */

#include <plib.h>

#include "hardware.h"
#include "I2CLib.h"

/* -------------------------- Global Variables and Structures --------------------------- */

/* ---------------------------------- Public Functions ---------------------------------- */

/**
 *	Summary
 *		Initializes I2C1 module to the desired frequency.
 *	Parameters
 *		i2c_frequency[in]: Unsigned int that signifies what frequency the I2C clock line
 *			should operate at.
 *	Returns
 *		Unsigned int that is ERROR or NO_ERROR if initialization was successful.
 */
unsigned int initialize_i2c(const unsigned int i2c_frequency) {
	I2CConfigure(I2C1, 0);  // Configure I2C1 with no special options
	
	// Check if the actual frequency of the I2C bus is acceptable close to what we wanted
	float actual_freq = (float) I2CSetFrequency(I2C1, GetPeripheralClock(), (UINT32) i2c_frequency);
	if ((actual_freq - (float) i2c_frequency > (float) i2c_frequency * I2C_CLOCK_MAX_DEVIATION) ||
		((float) i2c_frequency - actual_freq > (float) i2c_frequency * I2C_CLOCK_MAX_DEVIATION)) {
		
		return ERROR;
	}
	I2CEnable(I2C1, TRUE);
	
	return NO_ERROR;
}

/**
 *	Summary
 *		Reads the I2C1 busy status registers.
 *	Parameters
 *		None.
 *	Returns
 *		Character that is either 1 or 0. 1 if any busy flags are SET, 0 is CLEAR.
 *	Note
 *		This reads the SEN, PEN, RSEN, RCEN, ACKEN, and TRSTAT bits of the I2C1 controller.
 */
inline char busy_I2C1(void) {
	return (I2C1CONbits.SEN || I2C1CONbits.PEN || I2C1CONbits.RSEN || I2C1CONbits.RCEN || I2C1CONbits.ACKEN || I2C1STATbits.TRSTAT);
}

/**
 *	Summary
 *		Reads (len) items from slave device into read_array over I2C1 bus.
 *	Parameters
 *		slave_address[in]: Character that is the device address to read from.
 *		read_array[out]: Pointer to character array that will be filed with (len) bytes from
 *			the slave device.
 *		len[in]: Unsigned int corresponding to how many characters to read from the slave.
 *	Returns
 *		Character that is either 0 (for no errors) or non-zero if errors occurred during read.
 */
char read_I2C1(const char slave_address, char *read_array, unsigned int len) {
	char error = 0;
	
	// Begin I2C transaction by addressing the slave with a READ 
	StartI2C1();
	IdleI2C1();
	error |= MasterWriteI2C1((slave_address << 1) | 1);
	
	// Begin reading from I2C bus into the array
	while (len-- >= 0) {
		*read_array = MasterReadI2C1();
		AckI2C1();				// Originally was after the len == 0 check, perhaps move if I2C errors occur
		IdleI2C1();

		if (len == 0)
			return NO_ERROR;
		read_array++;
	}
	NotAckI2C1();
	IdleI2C1();
	StopI2C1();
	IdleI2C1();
	
	return error;
}

/**
 *	Summary
 *		Writes (len) items from write_array to slave_address over I2C1 bus.
 *	Parameters
 *		slave_address[in]: Character that is the device address to read from.
 *		write_array[in]: Pointer to character array that will be written over the I2C1 bus.
 *		len[in]: Unsigned int corresponding to how many characters to read from the slave.
 *	Returns
 *		Character that is either 0 (for no errors) or non-zero if errors occurred during read.
 */
char write_I2C1(const char slave_address, char *write_array, unsigned int len) {
	StartI2C1();
	IdleI2C1();
	char error = MasterWriteI2C1(slave_address << 1 | 0);
	while (len-- != 0) {
		error |= MasterWriteI2C1(*write_array);
		write_array++;
	}

	StopI2C1();
	IdleI2C1();

	return error;
}

/**
 *	Summary
 *		Writes write_length items from write_array to slave_address, and then reads read_length
 *		items from that slave into the read_array.
 *	Parameters
 *		slave_address[in]: Character that is the device address to read from.
 *		write_array[in]: Pointer to character array that will be written over the I2C1 bus.
 *		read_array[out]: Pointer to character array that will be read into from the I2C1 bus.
 *		write_length[in]: Unsigned int corresponding to how many characters to write to the slave.
 *		read_length[in]: Unsigned int corresponding to how many characters to read from the slave.
 *	Returns
 *		Character that is either 0 (for no errors) or non-zero if errors occurred during read.
 *	Note
 *		This function times out after I2C_READ_WRITE_TIMEOUT_COUNT polls for the write operation.
 */
char read_write_I2C1(const char slave_address, char *write_array, char *read_array, unsigned int write_length, unsigned int read_length) {
	StartI2C1();
	IdleI2C1();
	char error = MasterWriteI2C1(slave_address << 1);
	while ((write_array != NULL) && (write_length != 0)) {
		error |= MasterWriteI2C1(*write_array);
		write_array++;
		write_length--;
	}
	RestartI2C1();
	IdleI2C1();

	int i = 0;
	while (1) {
		MasterWriteI2C1(slave_address << 1 | 1);
		if (I2C1STATbits.ACKSTAT == 0) { break; }

		if (++i > I2C_TIMEOUT_COUNT) {
			StopI2C1();
			IdleI2C1();

			return ERROR;
		}

		RestartI2C1();
		IdleI2C1();
	}

	while (1) {
		*read_array = MasterReadI2C1();
		AckI2C1();		// Originally was after the read_length == 0 check, perhaps move if I2C errors occur
		IdleI2C1();
		if ((--read_length) == 0) { break; }
		read_array++;
	}

	NotAckI2C1();
	IdleI2C1();
	StopI2C1();
	IdleI2C1();

	return error;
}

/**
 *	Summary
 *		Polls for read acknowledgement from slave_address. After I2C_TIMEOUT_COUNT polls
 *		without an acknowledgement, the function exits.
 *	Parameters
 *		slave_address[in]: Character that is the device address to read from.
 *	Returns
 *		Unsigned int that is either NO_ERROR or ERROR if operation failed or not.
 *	Note
 *		This function times out after I2C_READ_WRITE_TIMEOUT_COUNT polls for the write operation.
 */
unsigned int wait_for_I2C1_ack(char slave_address) {
	int i = 0;
	StartI2C1();
	IdleI2C1();
	while (1) { 
		MasterWriteI2C1(slave_address << 1 | 1);

		if (I2C1STATbits.ACKSTAT == 0) {
			StopI2C1();
			IdleI2C1();

			return NO_ERROR;
		}

		if (++i > I2C_TIMEOUT_COUNT) {
			return ERROR;
		}

		RestartI2C1();
		IdleI2C1();
	}
}

/* --------------------------------- Private Functions ---------------------------------- */

/* ----------------------------- Interrupt Service Routines ----------------------------- */
