CollinHeist/CropTop/Software/PotentiometerDriver/PotentiometerTests.X/CerebotMX7cK.h

/* **************************************************************************
 * File name:   CerebotMX7cK.h
 * Association: University of Idaho
 * Author:      Ryan Donahue
 * Dates:       Created 1/11/2018
 * 
 * Summary:     This file contains definitions to support it's C file
 *              counterpart
 * 
 * Notes:       Software things:
 *
 *              Hardware things:
 *              
 * *************************************************************************/

#ifndef __CEREBOT_MX7ck_H__
    #define __CEREBOT_MX7ck_H__

//IO ports
    #define BTN1	BIT_6		/* Port G */
    #define BTN2	BIT_7		/* Port G */
    #define BTN3	BIT_0		/* Port A */


    #define LED1	BIT_12		/* Port G */
    #define LED2	BIT_13		/* Port G */
    #define LED3	BIT_14		/* Port G */
    #define LED4	BIT_15		/* Port G */
    #define BRD_LEDS	(LED1 | LED2 | LED3 | LED4)

//PmodSTEP stepper motor driver board, often used for instrumentation

    #define LEDA 	BIT_2		/*  Port B */
    #define LEDB 	BIT_3		/*  Port B */
    #define LEDC 	BIT_4		/*  Port B */
    #define LEDD 	BIT_6		/*  Port B */
    #define LEDE 	BIT_7		/*  Port B */
    #define LEDF 	BIT_8		/*  Port B */
    #define LEDG 	BIT_9		/*  Port B */
    #define LEDH 	BIT_10		/*  Port B */
    #define SM1		LEDE
    #define SM2		LEDF
    #define SM3		LEDG
    #define SM4		LEDH

    #define RD1 

    #define SM_COILS	(SM1 | SM2 | SM3 | SM4)
    #define SM_LEDS	(LEDA | LEDB | LEDC | LEDD | LEDE | LEDF | LEDG | LEDH)

//timing values

    #define GetSystemClock()		(80000000ul)	/* 80 MHz */
    #define GetInstructionClock()	(GetSystemClock()/2)	
    #define GetPeripheralClock()	(GetSystemClock()/8)	

    #define XTAL	(8000000UL)         /* 8 MHz Xtal on Cerebot MX7cK */
    #define SYS_FREQ    GetSystemClock()    /* System clock rate */
    #define SYSTEM_FREQ GetSystemClock()
    #define CORE_OSC 	GetInstructionClock()  /* Core clock rate */
    #define FPB		GetPeripheralClock()   /* Peripheral bus clock rate */
    #define CORE_MS_TICK_RATE	(GetInstructionClock()/1000)

#endif

//funciton declarations
void Cerebot_mx7cK_setup(void);
