CollinHeist/CropTop/(commit log)

2018-09-13 Prototype documentation added
    [BOM_PartType-stalkTesterForkWithDCDCConverter.xls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]
2018-10-19 Board rev 3
    [croptop_rev1.kicad_pcb, croptop_rev1.sch]
2018-11-02 November 1st edit1
    [croptop_rev1.sch]
2018-11-09 Created BOM
    [Bill of Materials.xlsx, croptop_rev1.sch]
2018-11-12 Nov 11th
    [Bill of Materials.xlsx]
2018-11-14 Added screen power supply
    [Bill of Materials.xlsx, Schematic To Do.xlsx, croptop_rev1.sch]
2018-11-14 Updated task list
    [Schematic To Do.xlsx]
2018-11-14 Added block diagram
    [Bill of Materials.xlsx]
2018-11-18 Broke schematic up into multiple sheets
    [BOM.xlsx, Bill of Materials.xlsx, Schematic To Do.xlsx, TODO.xlsx, croptop_rev1.kicad_pcb, croptop_rev1.sch, debug.sch, io.sch]
2018-11-20 Decoupling caps & more
    [BOM.xlsx, TODO.xlsx, croptop_rev1.sch, debug.sch, io.sch, lcd.sch, mcu.sch, mcucap.sch]
2018-11-22 Before changing files
    [BOM.xlsx, TODO.xlsx, croptop_rev1.sch, debug.sch, io.sch, lcd.sch, mcu.sch, onboard.sch]
2018-11-28 Updates ESD protection diodes
    [BOM.xlsx, croptop.sch, croptop_io.sch, croptop_lcd.sch, croptop_mcu.sch, croptop_onboard.sch, croptop_psu.sch, croptop_rev1.kicad_pcb]
2018-12-03 Got to PCB layout
    [BOM.xlsx, croptop.kicad_pcb, croptop.sch, croptop_io.sch, croptop_lcd.sch, croptop_mcu.sch, croptop_onboard.sch, croptop_psu.sch]
2018-12-18 Save before netlist read
    [croptop_io.sch]
2018-12-18 Added AD7799 drivers
2018-12-18 Dec 18th
    [croptop.kicad_pcb, croptop_io.sch, croptop_lcd.sch, croptop_onboard.sch]
2018-12-20 Dec 19th
    [croptop.kicad_pcb]
2018-12-20 Before remove LCD resistors
    [croptop.kicad_pcb, croptop_lcd.sch, croptop_mcu.sch]
2018-12-20 Before USB update
    [croptop.kicad_pcb]
2018-12-20 Final board shape
    [croptop.kicad_pcb, croptop_psu.sch]
2018-12-24 Finished working board
    [croptop.kicad_pcb, croptop_io.sch, croptop_mcu.sch, croptop_onboard.sch, croptop_psu.sch]
2018-12-24 Changed testpoint size
    [croptop.kicad_pcb, croptop_io.sch, croptop_lcd.sch, croptop_mcu.sch, croptop_onboard.sch, croptop_psu.sch]
2019-01-06 Complete PCB version 1
    [BOM.xlsx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]
2019-01-10 Added motor driver. Needs to be tested on hardware
2019-01-11 Add gerber image
    [croptop.kicad_pcb]
2019-01-11 Add gerber image2
2019-01-12 Added a README, this includes conventions we should follow while developing code to be consistent. Also, modified the motor library.
2019-01-30 Started Potentiometer Driver
2019-02-02 Update before Linux
    [croptop.kicad_pcb]
2019-02-08 Adding images
    [croptop.kicad_pcb, croptop.sch, croptop_io.sch]
2019-02-09 Schematic 11
2019-02-10 Getting example files
    [croptop.sch, croptop_io.sch]
2019-02-11 Motor driver files added
2019-02-13 New microcontroller pinout
    [PIC32MX Pins.xlsx, Pin Out.xlsx, TODO.xlsx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]
2019-02-14 Added I2C library
2019-02-18 Wrote and ran I2C library, still won't activate I2C transaction
    [I2CLib.c, I2CLib.h, MotorLib.h, PotLib.h, config_bits.h, crop_top.h, main.c]
2019-02-26 I2C and Temp/humidity sensor work
2019-02-27 Finalized and documented I2CLib and Si7006 c and h files. There may be an issue with how humidity is calculated.
    [I2CLib.c, I2CLib.h, main.c]
2019-03-05 Fixed it
    [BOM.xlsx, BRT_AN_006_Source.X.production.obj, Pin Out.xlsx, croptop.kicad_pcb, croptop.sch, croptop_conn.sch, croptop_io.sch, croptop_lcd.sch]
2019-03-05 Renamed folders
    [BOM_PartType-stalkTesterForkWithDCDCConverter.xls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]
2019-03-08 Added USB port control
    [BOM.xlsx, croptop.kicad_pcb, croptop.sch, croptop_io.sch, croptop_lcd.sch, croptop_mcu.sch, croptop_onboard.sch, croptop_psu.sch]
2019-03-09 Added important notes
    [croptop_mcu.sch]
2019-03-17 Schematic near completion
    [393570015.stp, ABLS.STEP, BOM.xlsx, CAM-M8.STEP, Downlaod_STP_61300411121 (rev1).stp, Download_STP_61300611121 (rev1).stp, Download_STP_614004190021 (rev1).stp, c-4-1734839-0-c-3d.stp]
2019-03-23 Added pmod
    [croptop.kicad_pcb, croptop.sch, croptop_io.sch, croptop_lcd.sch, croptop_mcu.sch, croptop_onboard.sch, croptop_psu.sch, pinout.xlsx]
2019-04-02 Added TVS diodes
    [croptop.sch, croptop_io.sch, croptop_lcd.sch, croptop_mcu.sch, croptop_onboard.sch, croptop_psu.sch, pinout.xlsx]
2019-04-05 Updated pin out
    [croptop.kicad_pcb, croptop.sch, croptop_io.sch, croptop_lcd.sch, croptop_mcu.sch, croptop_onboard.sch, croptop_psu.sch, pinout.xlsx]
2019-04-05 Final Schematic
    [croptop.sch, croptop_io.sch, croptop_lcd.sch, croptop_mcu.sch, croptop_onboard.sch, pinout.xlsx]
2019-04-07 Schematic Done
    [croptop.sch, croptop_io.sch, croptop_lcd.sch, croptop_mcu.sch, croptop_onboard.sch]
2019-04-22 Footprints done, board started
    [1040310811.stp, 1702474.stp, 40fpc.FCStd, 4fpc.FCStd, 686104183422.stp, CAM-M8.STEP, DM3AT-SF-PEJM5.stp, DM3CS-SF.stp]
2019-04-22 Updated prez
    [LGA-16.stp, croptop_io.sch, croptop_lcd.sch, croptop_mcu.sch, croptop_onboard.sch, soic-14.stp]
2019-04-23 Fixed Command Execution Bug
    [main.c]
2019-04-25 added CFD to readme
    [BRT_AN_006_Source.X.production.obj]
2019-04-25 Board almost done
    [87583-2010blfc.stp, USB_Micro-B_Molex_47346-0001.step, croptop.kicad_pcb, croptop.sch, croptop_io.sch, croptop_lcd.sch, croptop_mcu.sch, croptop_onboard.sch]
2019-04-25 Example code for printing numbers
2019-04-26 Fixed some merge issues
    [main.c]
2019-04-26 Finished expo prez
    [croptop.kicad_pcb]
2019-05-07 Finished PCB
    [ABS07.STEP, croptop.kicad_pcb, croptop_mcu.sch]
2019-05-08 Add the correct touch screen configuration
    [main.c]
2019-05-13 Add more debug information to screen, but touch is still broken
    [main.c]
2020-01-17 Rewrote button and led settings to align with v2.1 of PCB. Started reworking the potentiometer ADC code - waiting to hear back about end-use.
    [MotorLib.c, PotLib.c, PotLib.h, hardware.h, main.c, main.h]
2020-01-21 Updated PCB2, Changed MotorLib, Changed PotLib
    - Updated PCB2 to have all correct MPNs
    - Added some useful macros within the standard hardware heade file
    - Changed hardware initialization function calls (for main, MotorLib, and PotLib) to return an error flag.
    - Corrected GPIO configurations for switches, LEDS
    - Made initialize_system() private
    - Added Doxygen to MotorLib and PotLib files
    - Reduced bloat of MotorLib by combining subsystem setup functions into one.
    - Added boundary condition checks for PWM functions
    - Added error-flag return values to motor functions
    - Corrected issue where CN14 was "used" to detect faults, but in PCBv2.2 CN14 is connected to GPU_INT, and INT1 is connected to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
    [1040310811.stp, 1702474.stp, 393570015.stp, 40fpc.FCStd, 4fpc.FCStd, 686104183422.stp, 87583-2010blfc.stp, ABLS.STEP]
2020-01-22 - Updated call to read_potentiometer() for new function name - Removed unnecessary #include in MotorLib.c, PotLib.c - Changed DisableIntT3() to DisableIntT3 - although this is an odd one.. - Fixed pr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
    [MotorLib.c, PotLib.c, PotLib.h]
2020-01-24 - Changed name of AccelLib.h and AccelLib.c to accelerometer.c and accelerometer.h - Made accelerometer code more readable - Changed initialization function name of accelerometer library (to be more 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
2020-01-24 - Deleted unused files - Renamed DisplayLib.h to display_library.h - Changed names of MCU_SetFreq10() and MCU_SetFreq20() - Updated entirety of pin assignments for DisplayMCU(); was using SPI2 for so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
    [main.c, motors.c, temp_humidity.c, temp_humidity.h]
2020-01-26 Made minor changes
    - Updated function names for I2CLib
    - Added multi-inclusion protection to config bits
    - Added file sections to main.c
    - Made motors.c more generic and increased adjustability of the pin configurations of motors.
2020-02-09 Fixed Screen alignment
    - Fixed pin alignment of LCD screen
    - Pins now properly align with the ribbon cables of the LCD screen
    [croptop.kicad_pcb, croptop_lcd.sch, croptop_onboard.sch]
2020-02-12 - Deleted Expo.c and Expo.h - Formatted comments more clearly. - Created screen_uart files for future implementation - Converted macro functions to inline functions for type-checking and error-tolera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
    [I2CLib.c, I2CLib.h, hardware.c, hardware.h, main.c, main.h, motors.c, motors.h]
2020-02-13 Finalized PCB changes
    Changed display schematic and PCB to have the correct orientation
    [bom-nov12.csv, bom-nov12.xlsm, croptop-dec03.csv, croptop.csv]
2020-02-15 - Added software delay to hardware.c - Created #define statements for TRUE and FALSE - Added test code for UART2 - Renamed screen_uart to uart - Added DMA code to UART2 library
2020-03-02 - Removed all #define _SUPRESS_PLIB_WARNING macros from source and header files and added it as a preprocessor directive - Verified PLIB installation - Updated project to newer MPLAB X IDE version - 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
    -- Project builds without errors or warning
    [GPS.c, GPS.h, I2CLib.c, I2CLib.h, accelerometer.c, accelerometer.h, config_bits.h, hardware.c]
2020-03-04 - Moved system configuration to hardware.c (was in main.c) - Commented clear_buffer() in hardware.c - Created copy_buffer function in hardware.c to use instead of strcpy because screen responses are 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
    -- Built and tested on-board; all works as expected.
2020-03-06 Deleted Unused Files
    [BRT_AN_006_Source.X.production.obj, Part List and Inventory.xlsx, bom.xlsx, todo.xlsx]
2020-03-06 Started fixing GPS code
    - Fixing / updating the GPS library to be better commented, easier to interface with, and accurate.
    [GPS.c, GPS.h, I2CLib.c, I2CLib.h, main.c, main.h, potentiometer.c, screen.c]
2020-03-20 (Nearly) finished GUI - started PIC interface
    - Created Arial size 24, 16
    - Finished all known GUI screens and added PIC32 messages on important events
    - Deleted old FT812 files (API_layer, DisplayAPI, DisplayAPP, DisplayECE, DisplayMCU, FT8xx, display_library)
    - Added proper header to GPS.c
    - Fixed ternary operator type in GPS.c
    - Made function parameters const where applicable
    - Added function description to initialize_sytem() in main.c
    - Made some motors.c functions inline where applicable
    - Added modes to potentiometer.c (for Volts vs. Newtons)
    - Created mode setting function in potentiometer.c
    - Fixed file header for potentiometer.h
    - Created real time clock files (RTC.c, RTC.h) for fut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
    [GPS.c, GPS.h, I2CLib.c, I2CLib.h, RTC.c, RTC.h, accelerometer.c, accelerometer.h]
2020-04-04 Fixed formatting
    - Fixed formatting on most all files
    - Made a lot of progress of the GUI
    [GPS.c, I2CLib.c, I2CLib.h, RTC.c, RTC.h, accelerometer.c, accelerometer.h, config_bits.h]
2020-04-11 Updated Readme
    - Updated Readme
    - Fixed most files (see details on each file)
    [AccelLib.c, GPSLib.c, I2CLib.c, I2CLib.h, RTC.c, config_bits.h, crop_top.h, hardware.c]
2020-04-14 Added test functionality and storage
    - Deleted reference pictures about existing GUI
    - Added byte size definitions for short, int, and float to hardware.h; these are used in the tests library
    - Moved start_time and start_date to within initialize_system in main.c
    - Created configuration macros for default startup date and time within main.h
    - Created get_datetime_rtcc() within RTC.c to return the current date and time as rtccTime and rtccDate structures (not unique fields).
    - Created alert_user_memory_full() function in screen.c to send the user to a messages screen on the Nextion GUI that alerts the user when the pre-allocated PIC test memory is full
    - Added memory is full check to start_te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
    [RTC.c, RTC.h, hardware.c, hardware.h, main.c, main.h, motors.h, potentiometer.c]
2020-04-14 Renamed PCB Folders, started v3
    - Renamed pcb1 and pcb2 to verbose PCB v1.0, etc.
    - Started PCB v3.0 which uses the new Nextion Display
    - Deleted old screen sheet from PCB v3
    - Changed U2TX/U2RX pinouts to 01x04 pinout for display
    [1040310811.stp, 1702474.stp, 393570015.stp, 40fpc.FCStd, 4fpc.FCStd, 686104183422.stp, 87583-2010blfc.stp, ABLS.STEP]
2020-04-14 Variable scope and function heading in screen.c
    - Made variable scope of parse_screen_response() in screen.c local to switch-case statements for faster function call (less overhead)
    - Fixed ISR function heading to be more accurate (not using DMA anymore)
    [screen.c]
2020-05-15 Updated PCB dimensions for Nextion screen, deleted old files
    - Updated PCB v3.0 to use the Nextion screen mounting and connectors
    - Deleted old I2CDriver files from /Software/
    - Deleted unused /Software/Readme
    [BOM.xlsx, Croptop BOM.xlsx, croptop_io.sch, croptop_mcu.sch, croptop_onboard.sch]
2020-05-15 Finalized all code comments, function naming, etc.
    - Finished adding const to all relevent function calls.
    - Finished cleaning accelerometer library files.
    - Finished cleaning I2CLib files.
2020-05-16 Updated readme, added graphics to PCBv3
    [croptop.kicad_pcb]
2020-05-27 Minor changes to PCB
    [croptop.kicad_pcb]
